TokarskyiAnton/a0180_eol_ecu_mix/img_assy/A0180_EOL ECU MIX CARD_R11A_V0_DEF_TOP.jpeg

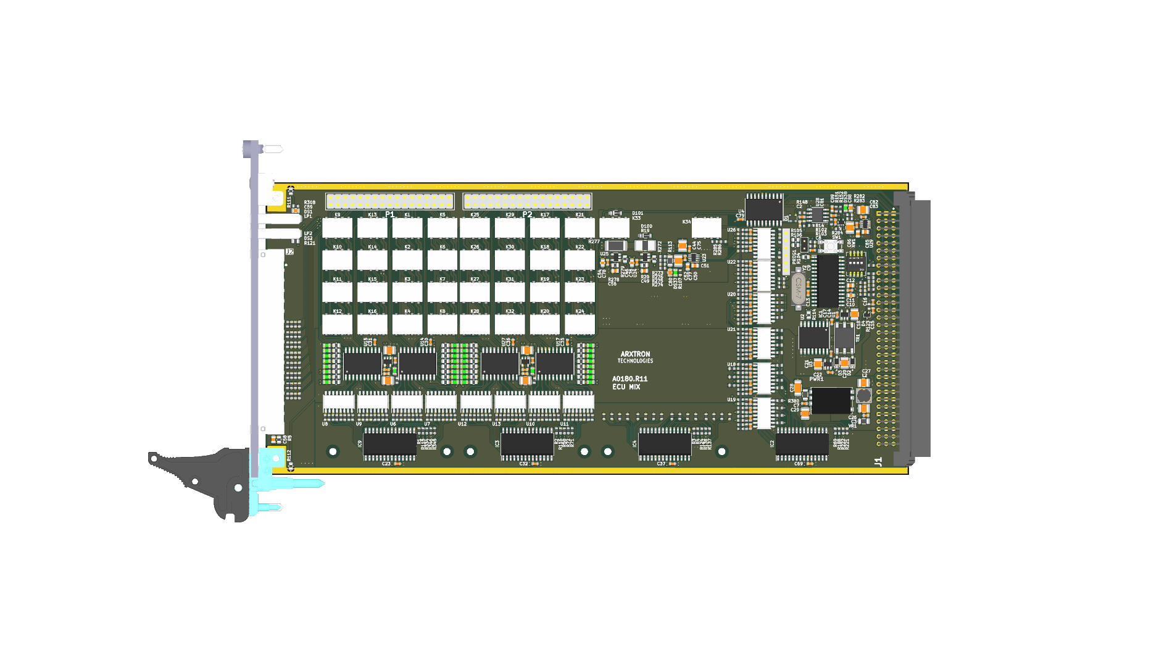
img_assy/A0180_EOL ECU MIX CARD_R11A_V0_DEF_TOP.jpeg
