TokarskyiAnton/a0180_eol_ecu_mix/dxf/a0180_eol_ecu_mix-drl_map.dxf

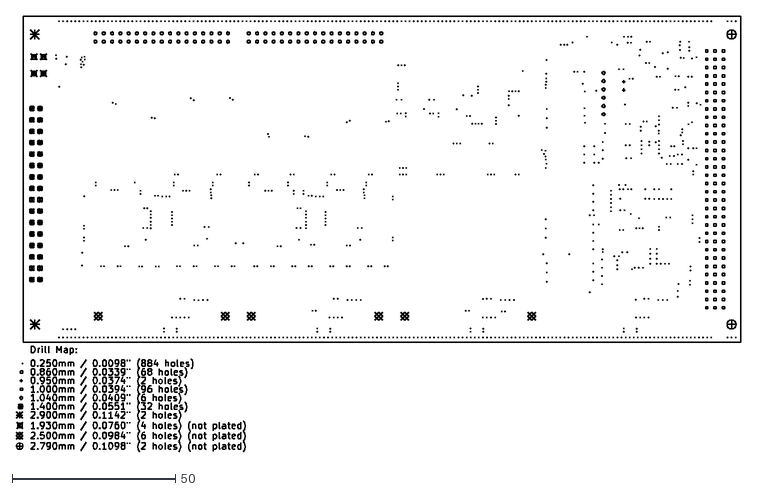
[picture p4: CAD file, 2026-02-21]
dxf/a0180_eol_ecu_mix-drl_map.dxf
222.1 x 133.5
