TokarskyiAnton/a0180_eol_ecu_mix/dxf/a0180_eol_ecu_mix-B_Fab.dxf

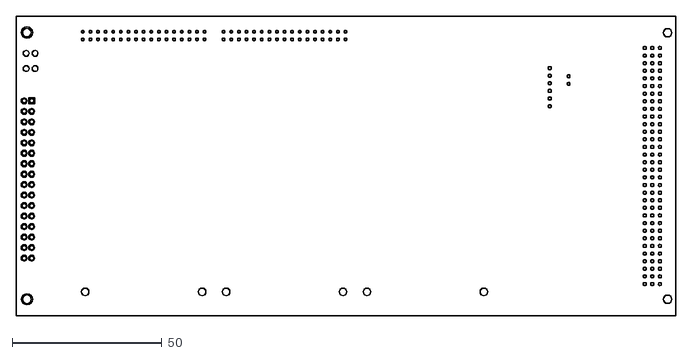
[picture p5: CAD file, 2026-02-07]
dxf/a0180_eol_ecu_mix-B_Fab.dxf
220.0 x 100.0
