TokarskyiAnton/a0180_eol_ecu_mix/pdf/a0180_eol_ecu_mix.pdf

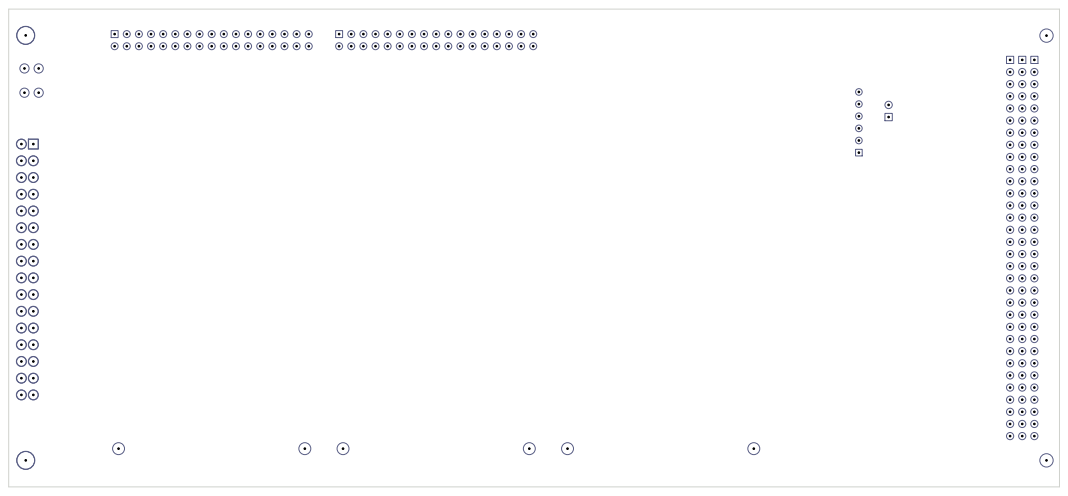
[picture p6: page 1]

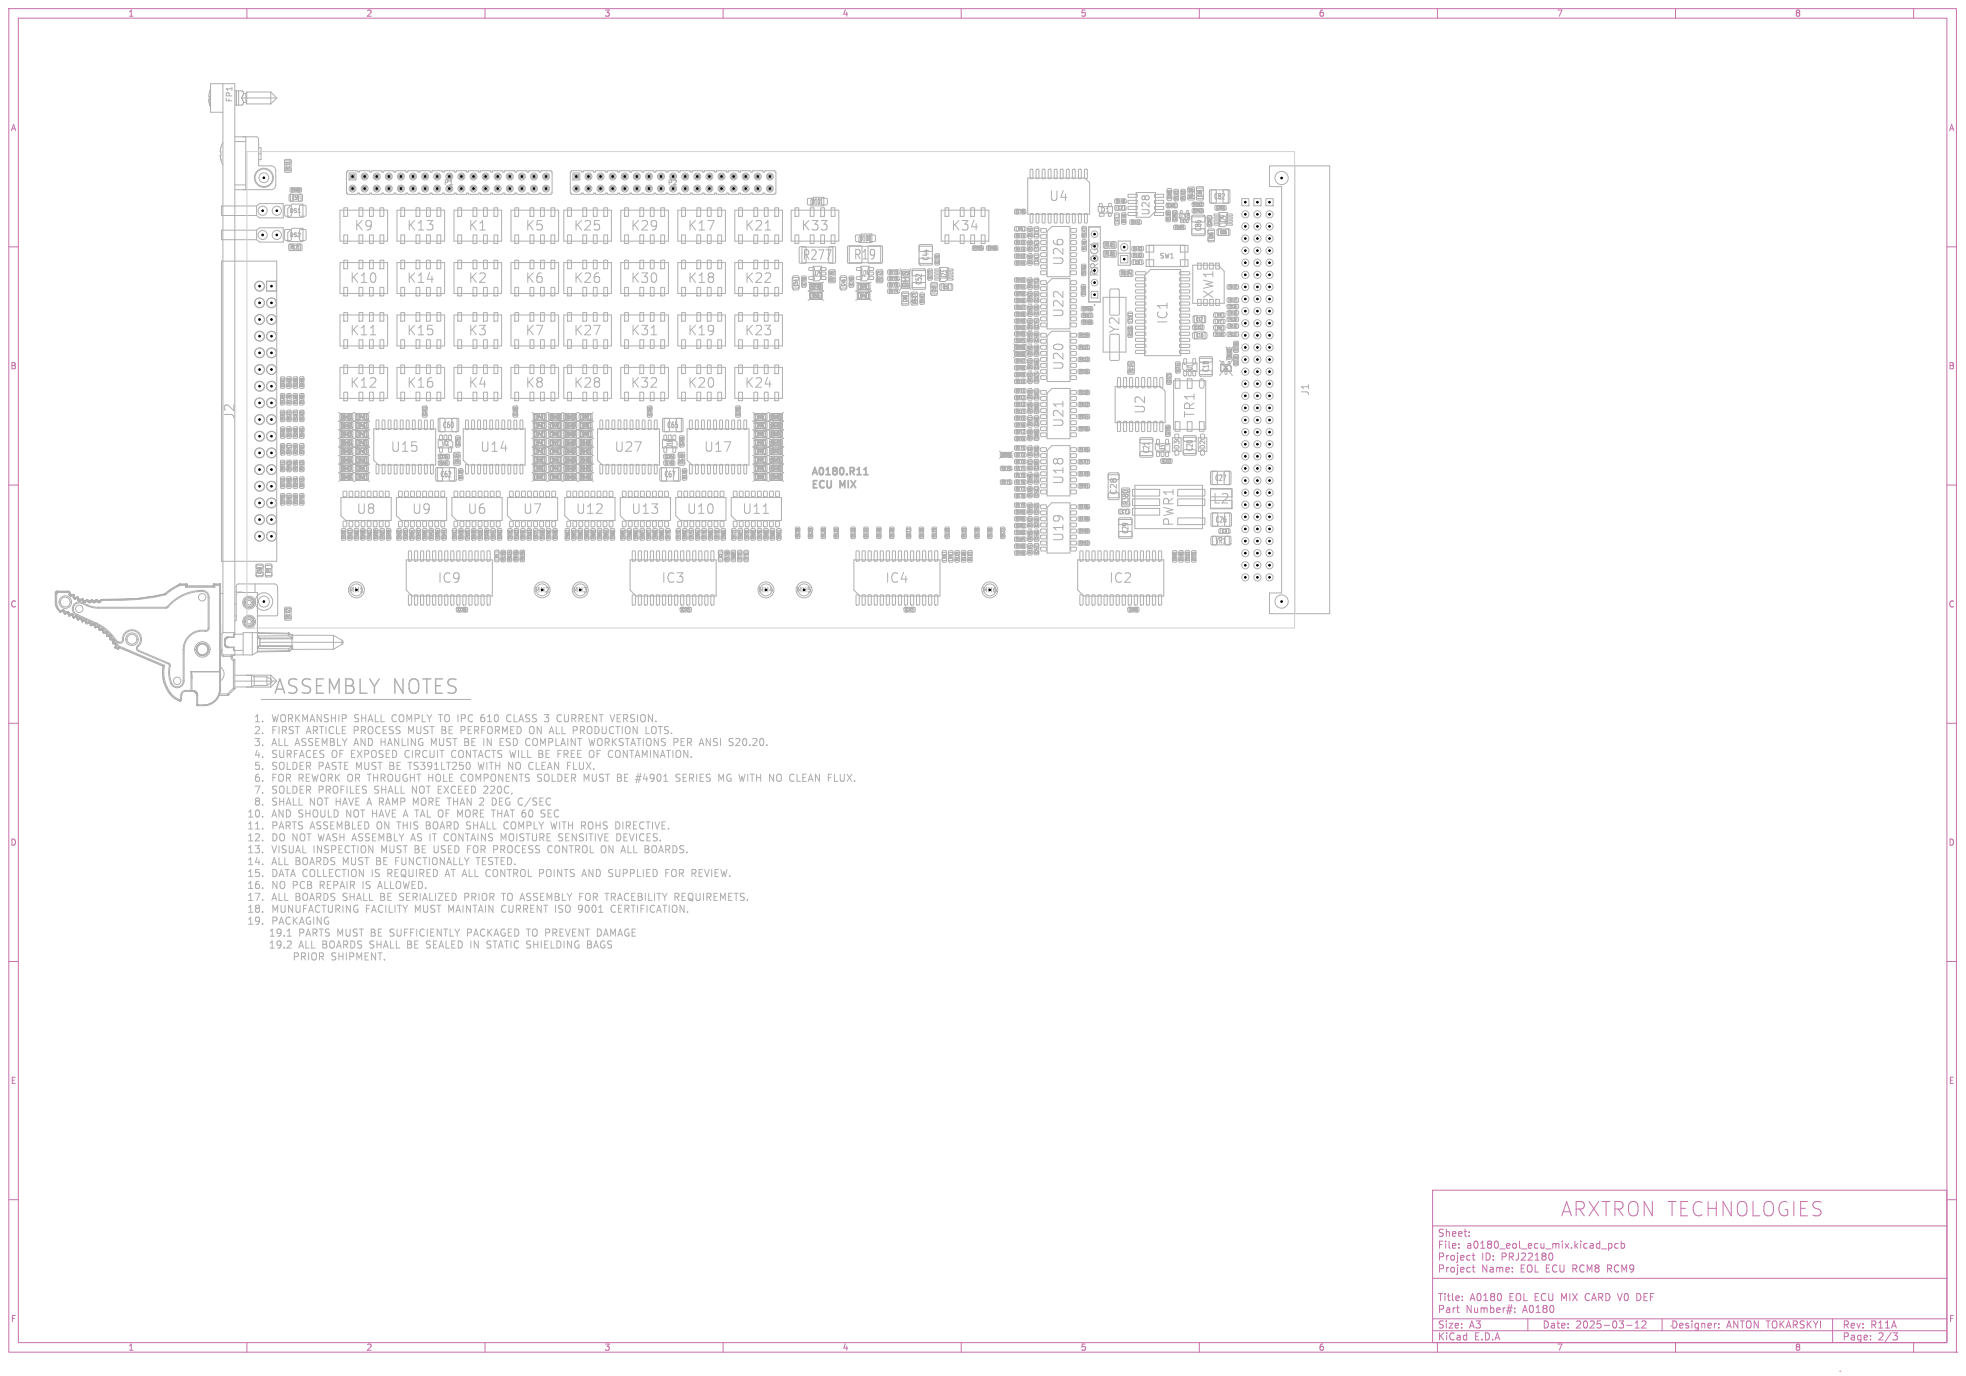
[picture p7: page 2]

19.2 ALL BOARDS SHALL BE SEALED IN STATIC SHIELDING BAGS WORKMANSHIP SHALL COMPLY TO IPC 610 CLASS 3 CURRENT VERSION. AND SHOULD NOT HAVE A TAL OF MORE THAT 60 SEC

FOR REWORK OR THROUGHT HOLE COMPONENTS SOLDER MUST BE #4901 SERIES MG WITH NO CLEAN FLUX. 3.

VISUAL INSPECTION MUST BE USED FOR PROCESS CONTROL ON ALL BOARDS. 19. DATA COLLECTION IS REQUIRED AT ALL CONTROL POINTS AND SUPPLIED FOR REVIEW. PARTS ASSEMBLED ON THIS BOARD SHALL COMPLY WITH ROHS DIRECTIVE. 12. SHALL NOT HAVE A RAMP MORE THAN 2 DEG C/SEC

16. 19.1 PARTS MUST BE SUFFICIENTLY PACKAGED TO PREVENT DAMAGE

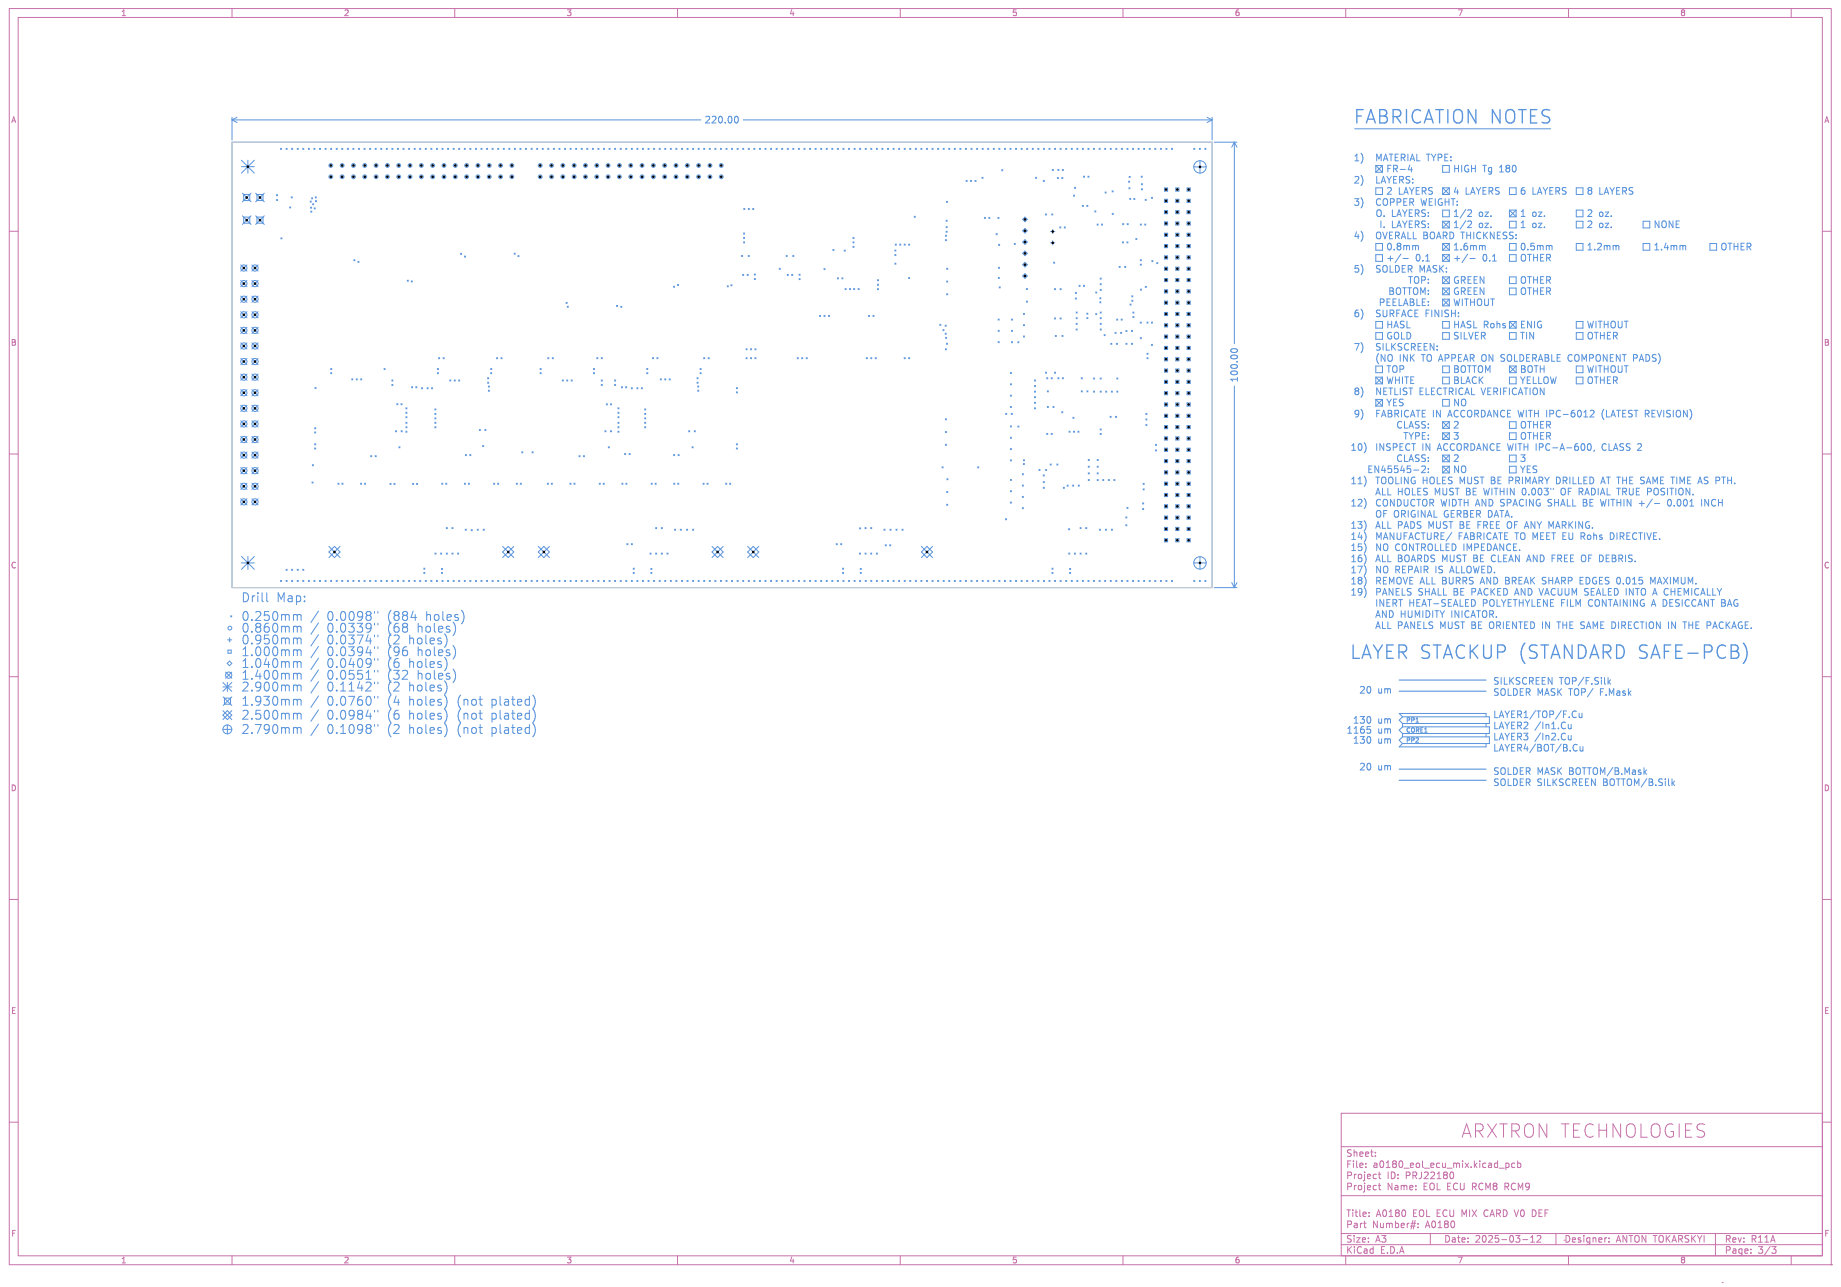
[picture p8: page 3]

CLASS: SURFACE FINISH: FR-4

I. LAYERS: ALL BOARDS MUST BE CLEAN AND FREE OF DEBRIS. YES

(NO INK TO APPEAR ON SOLDERABLE COMPONENT PADS) GOLD

17) OF ORIGINAL GERBER DATA. BLACK

NO REPAIR IS ALLOWED. PANELS SHALL BE PACKED AND VACUUM SEALED INTO A CHEMICALLY

INERT HEAT-SEALED POLYETHYLENE FILM CONTAINING A DESICCANT BAG

PP1 LAYER STACKUP (STANDARD SAFE-PCB)

SILKSCREEN TOP/F.Silk LAYER3 /In2.Cu

LAYER1/TOP/F.Cu SOLDER MASK BOTTOM/B.Mask
