TokarskyiAnton/a0180_eol_ecu_mix/sch/A0180_EOL ECU MIX CARD_R11A_V0_DEF.pdf

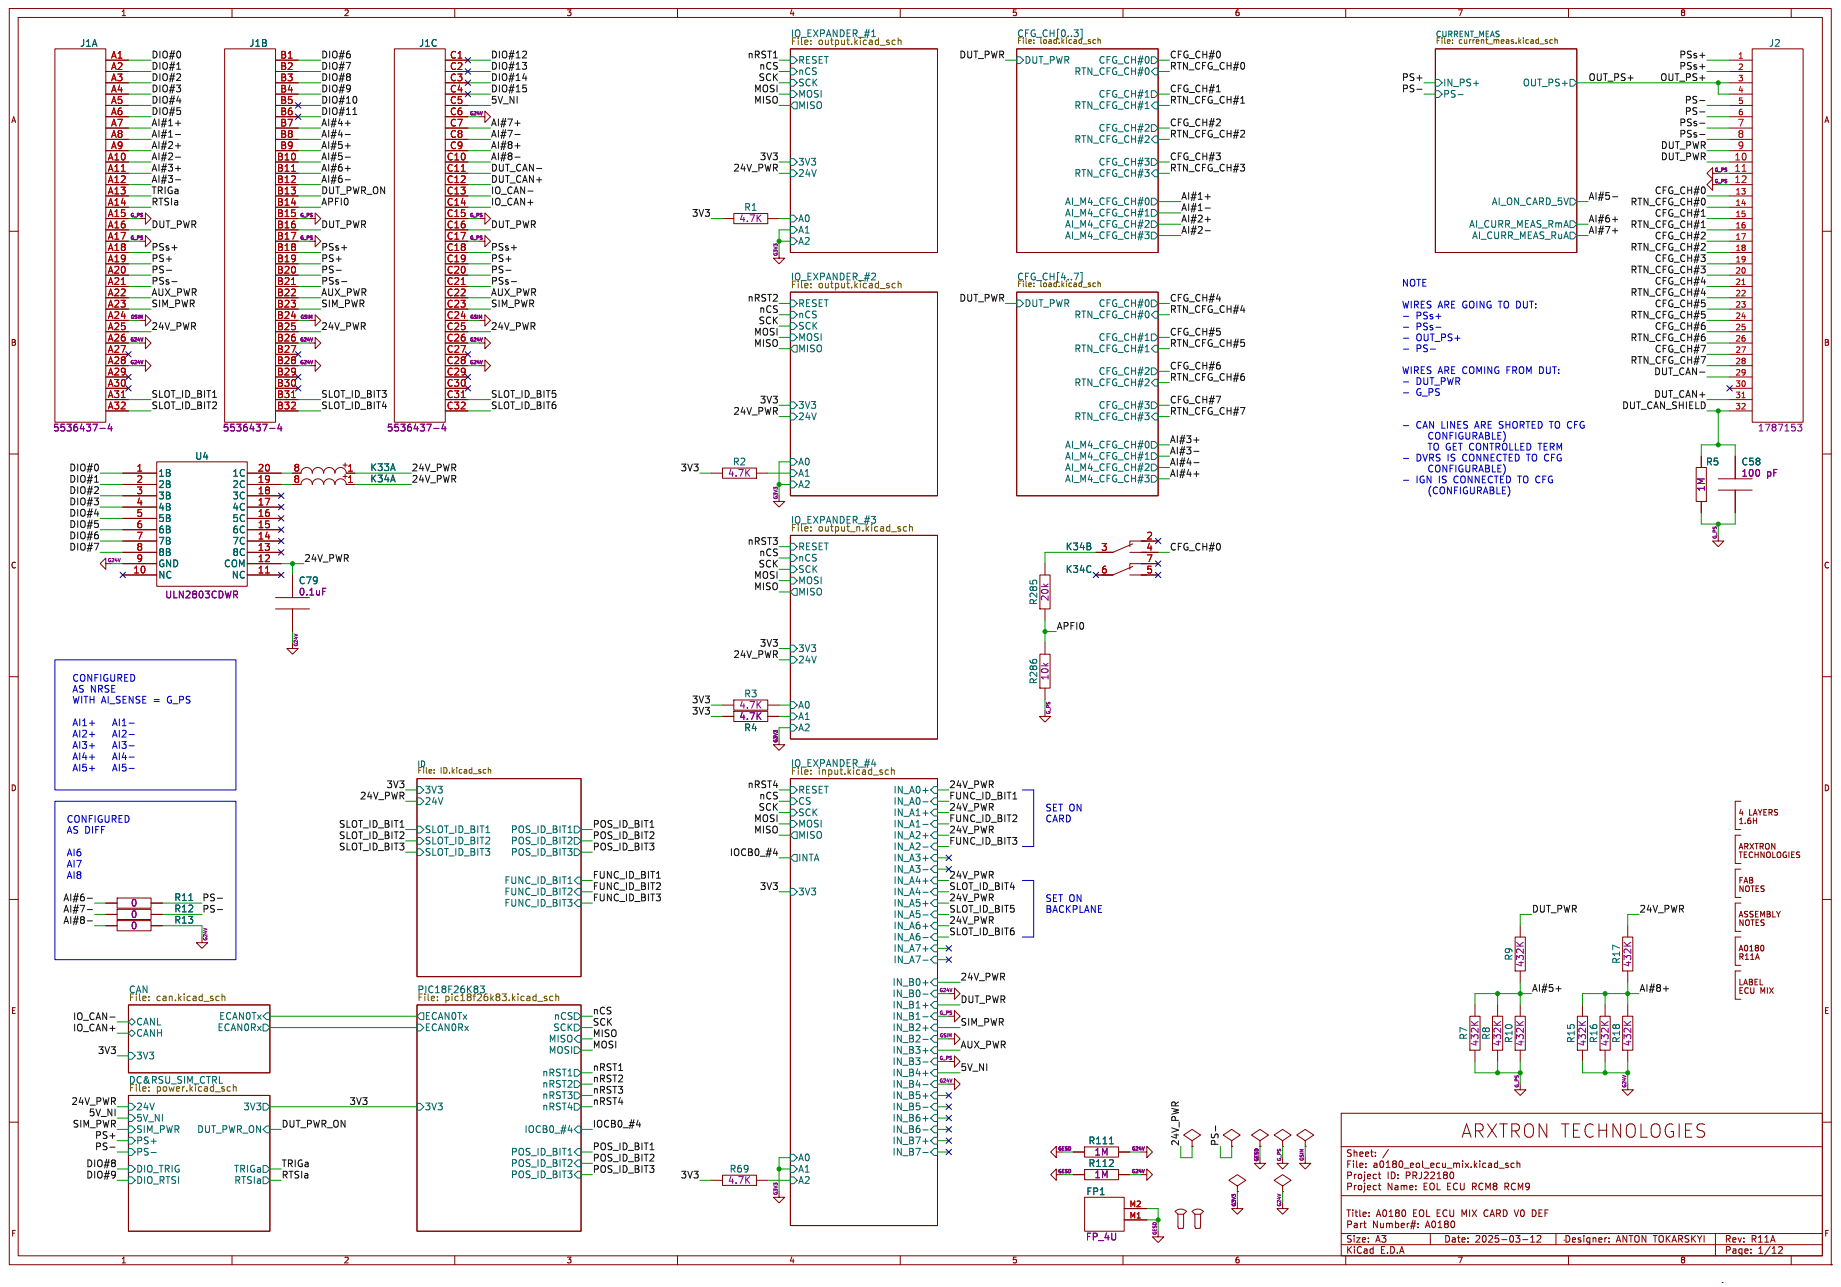
[picture p9: page 1]

DIO#2 AI#2+ AI#3- AI#3+ DUT_PWR

DIO#9 AI#5+ DIO#11
DIO#10 AI#5- AI#6- AI#6+ DUT_PWR_ON

WIRES ARE GOING TO DUT: - PSs+

WIRES ARE COMING FROM DUT: - DUT_PWR

- CAN LINES ARE SHORTED TO CFG
CONFIGURABLE)
- DVRS IS CONNECTED TO CFG
- IGN IS CONNECTED TO CFG
(CONFIGURABLE)

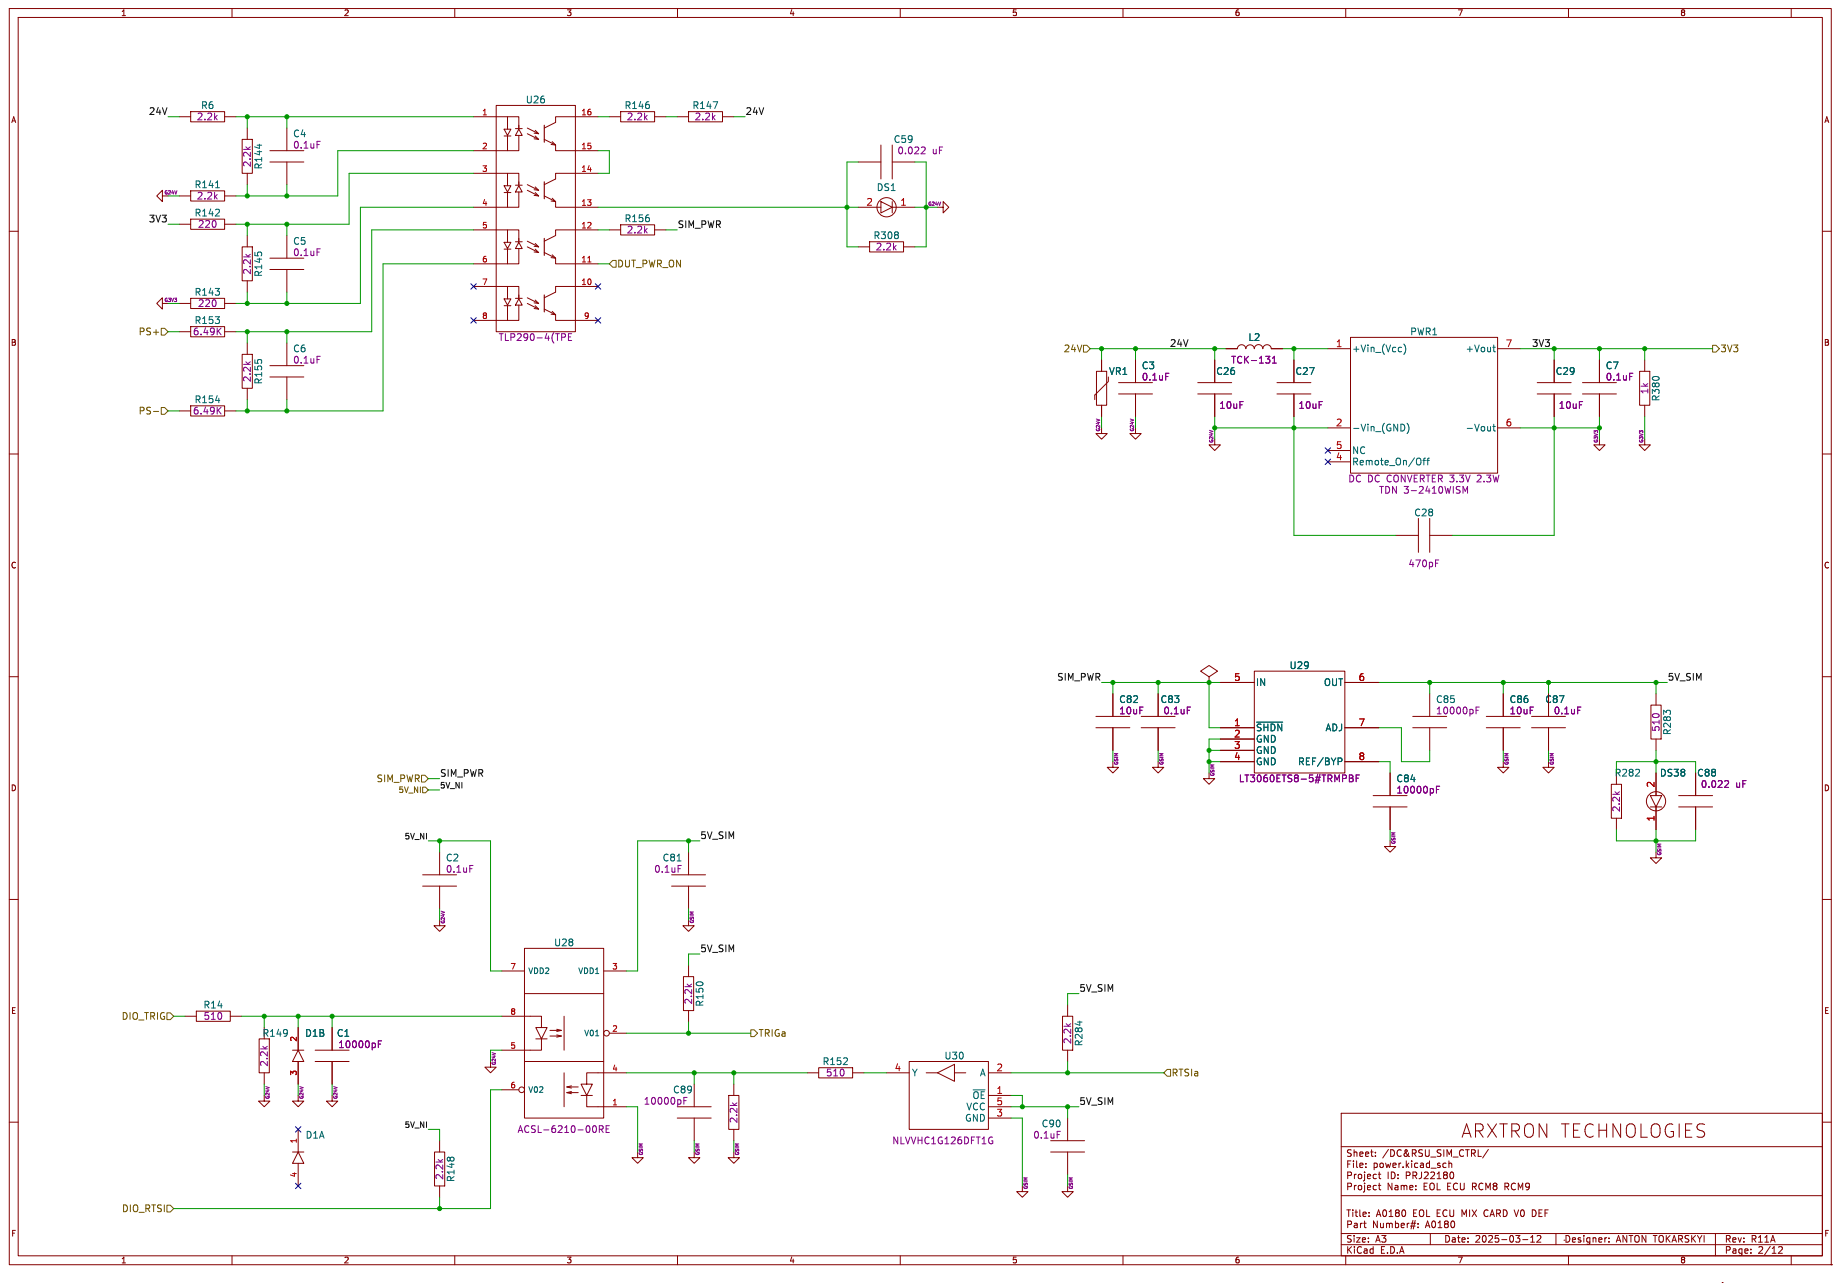
[picture p10: page 2]

File: power.kicad_sch Sheet: /DC&RSU_SIM_CTRL/

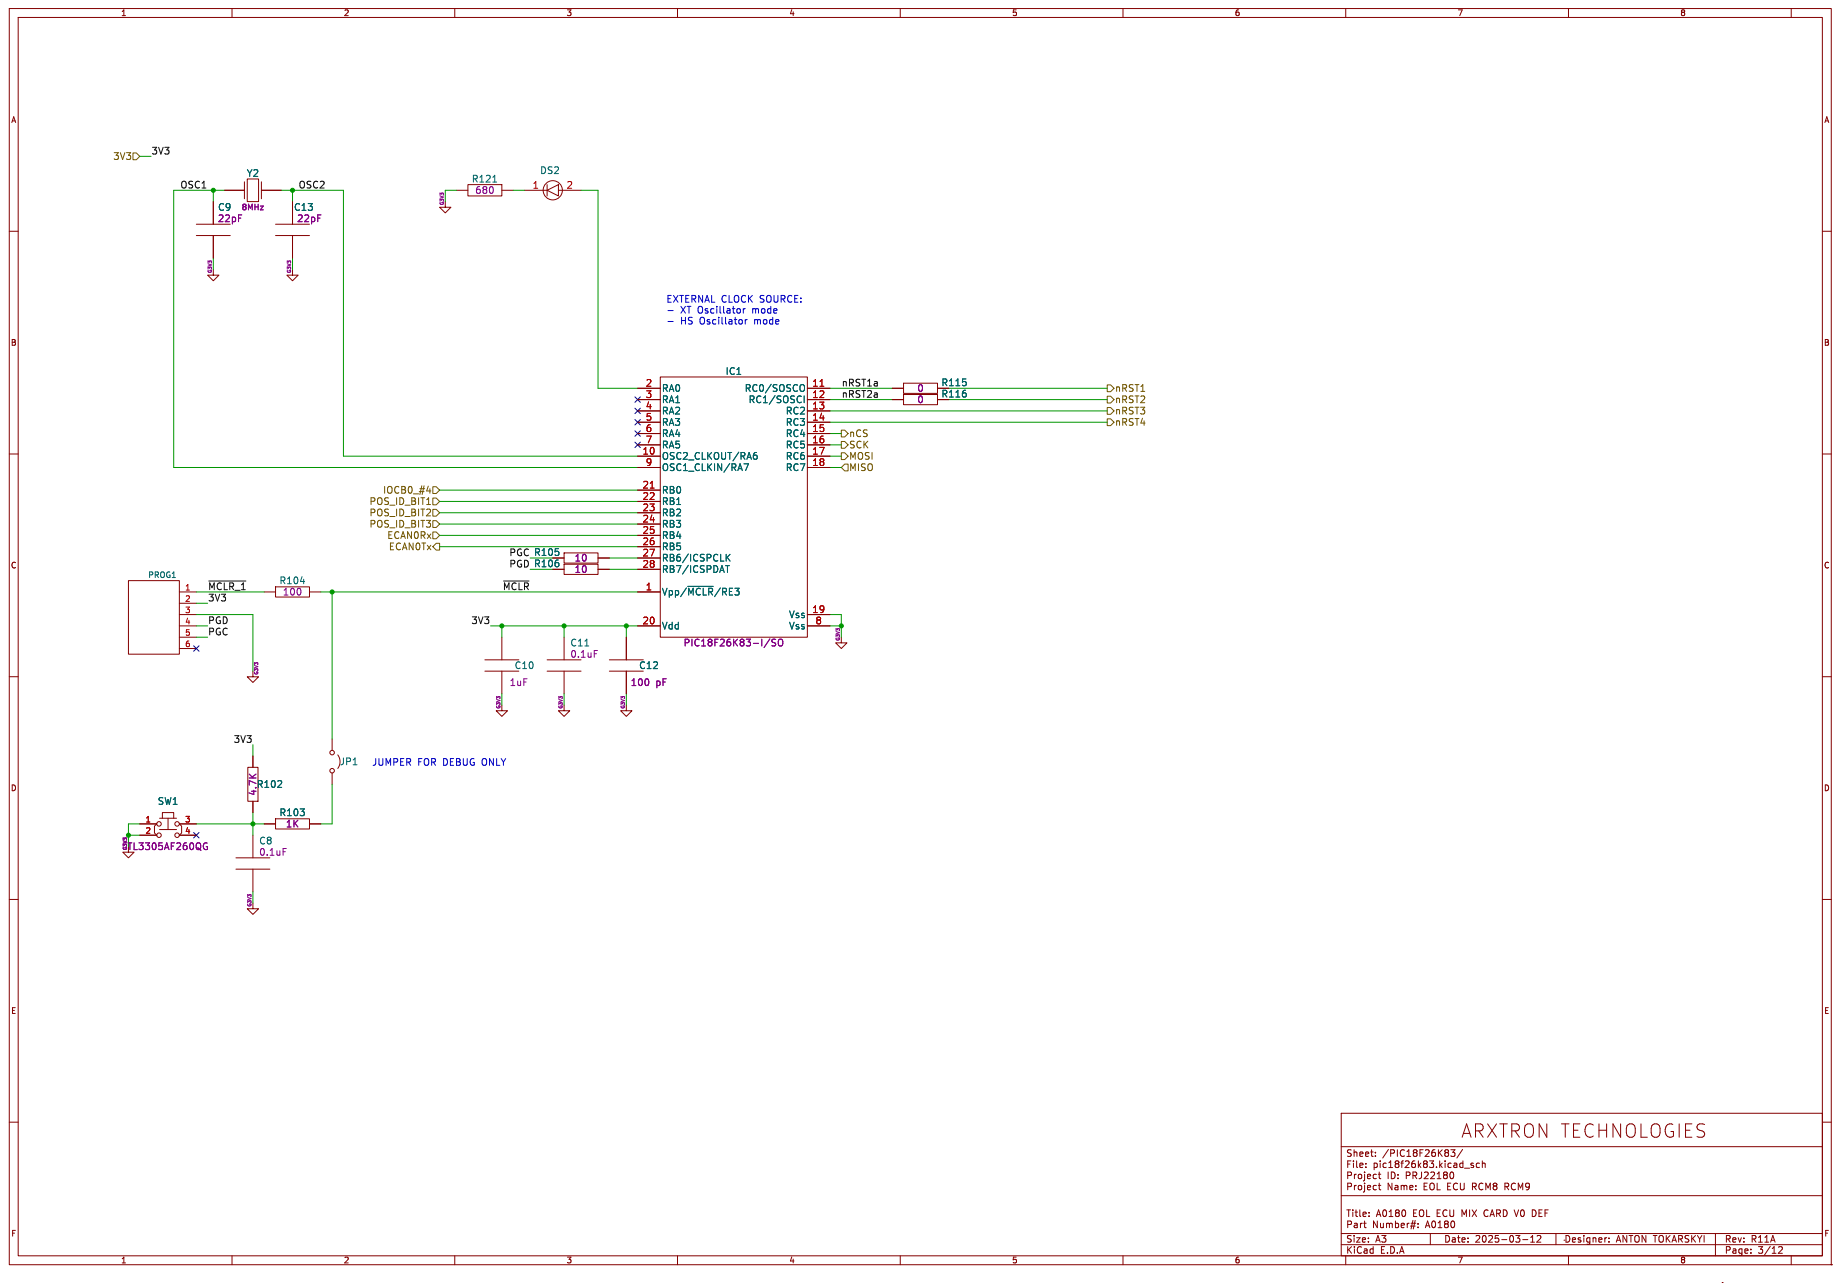
[picture p11: page 3]

JUMPER FOR DEBUG ONLY

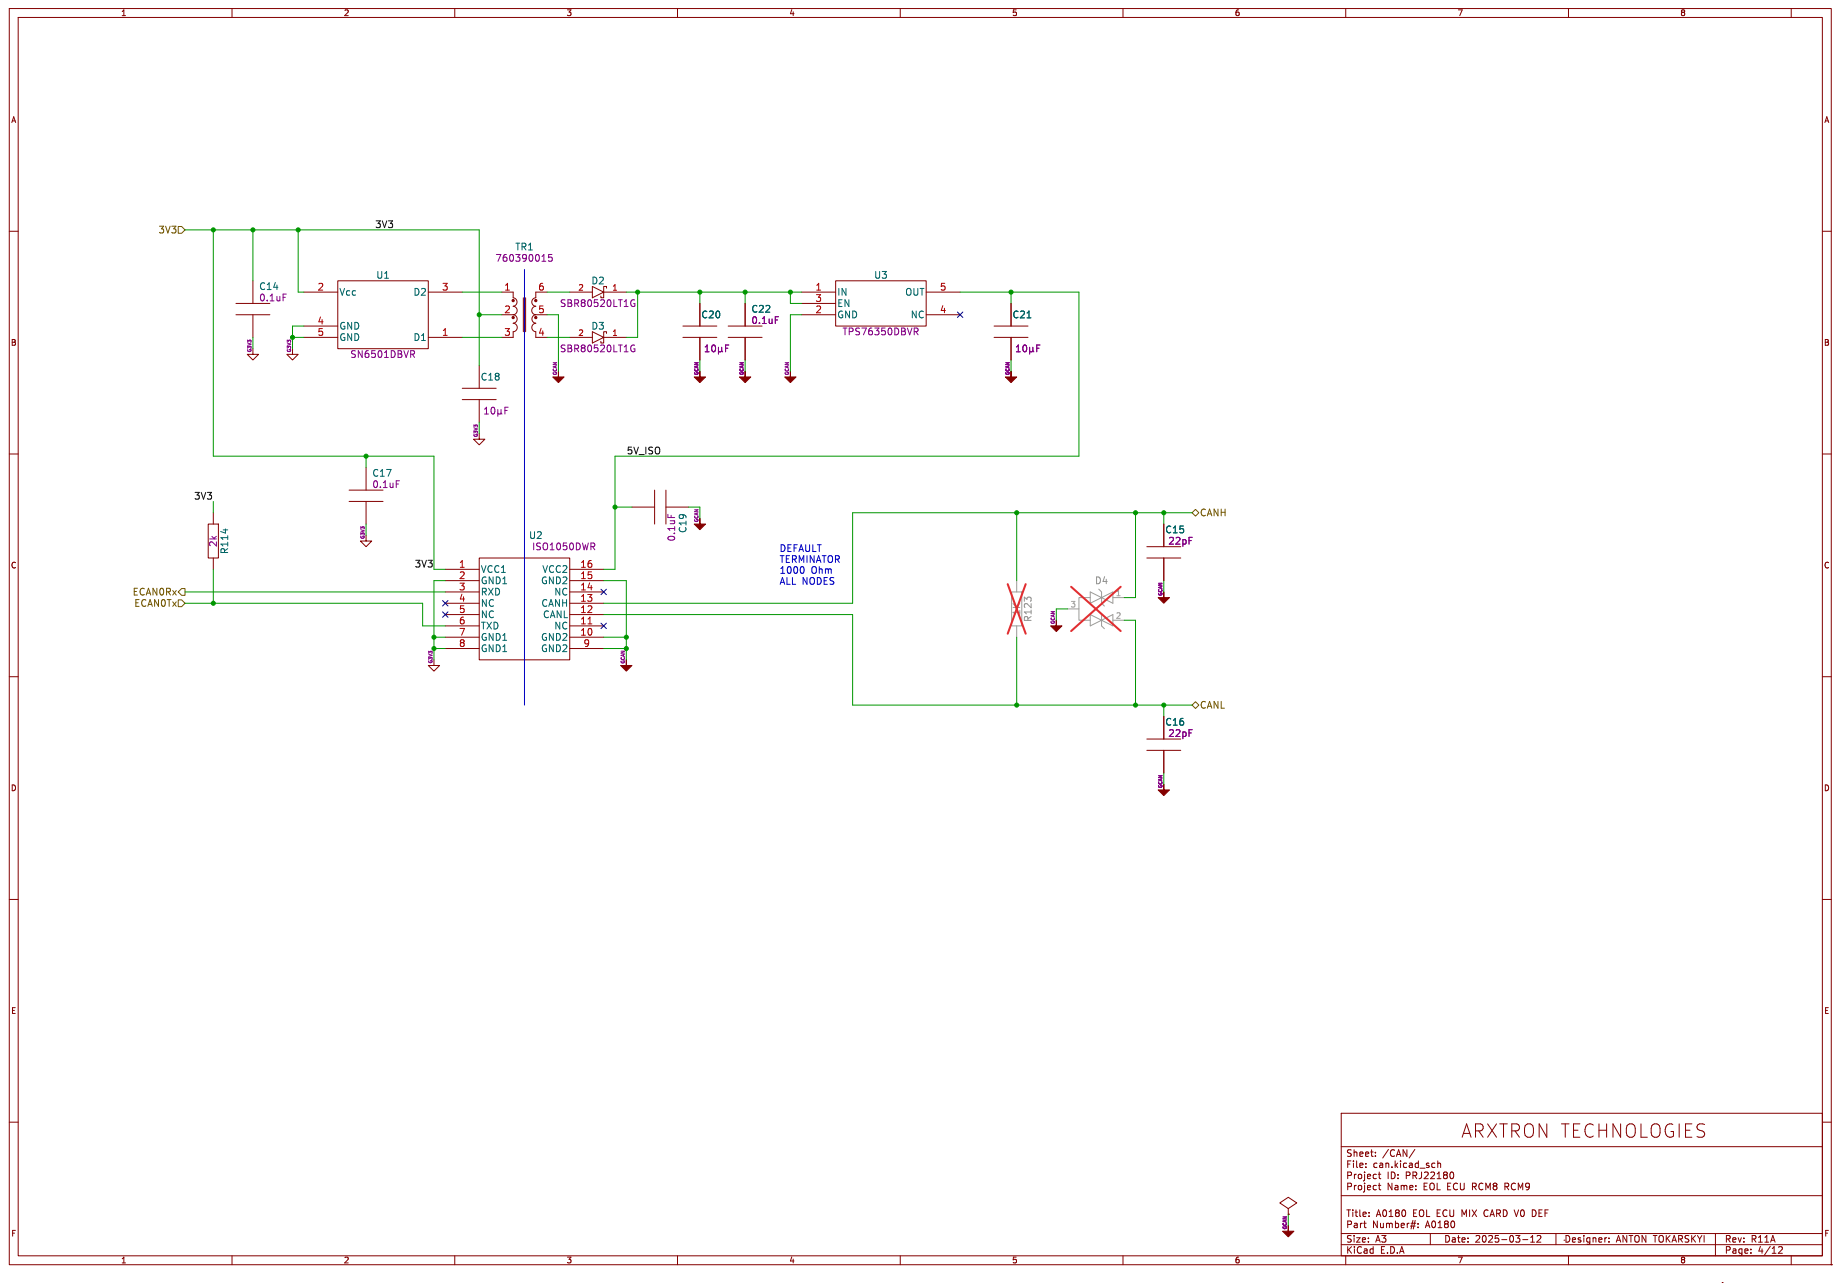
[picture p12: page 4]

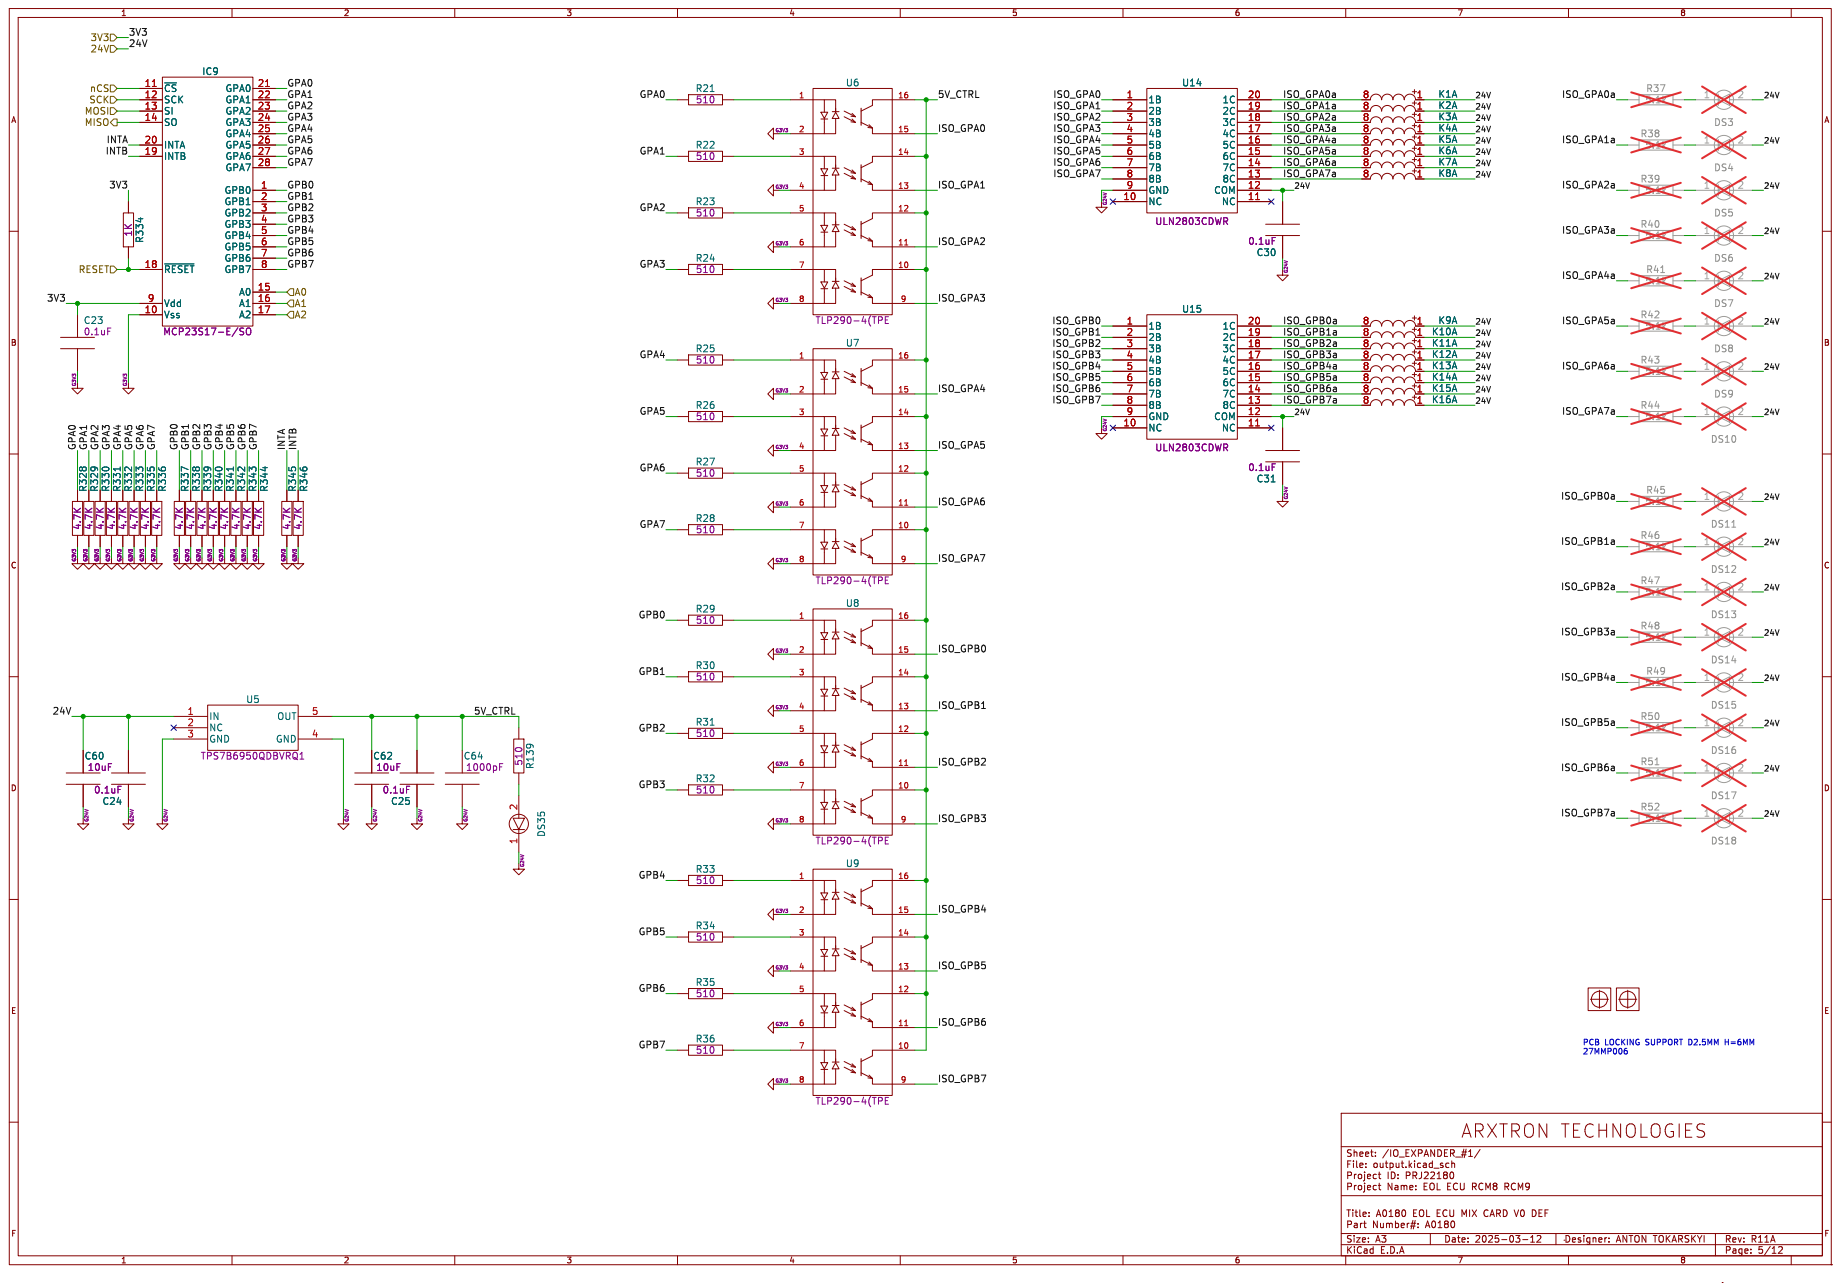
[picture p13: page 5]

~{CS} 11 SCK 12 SI 13 SO 14

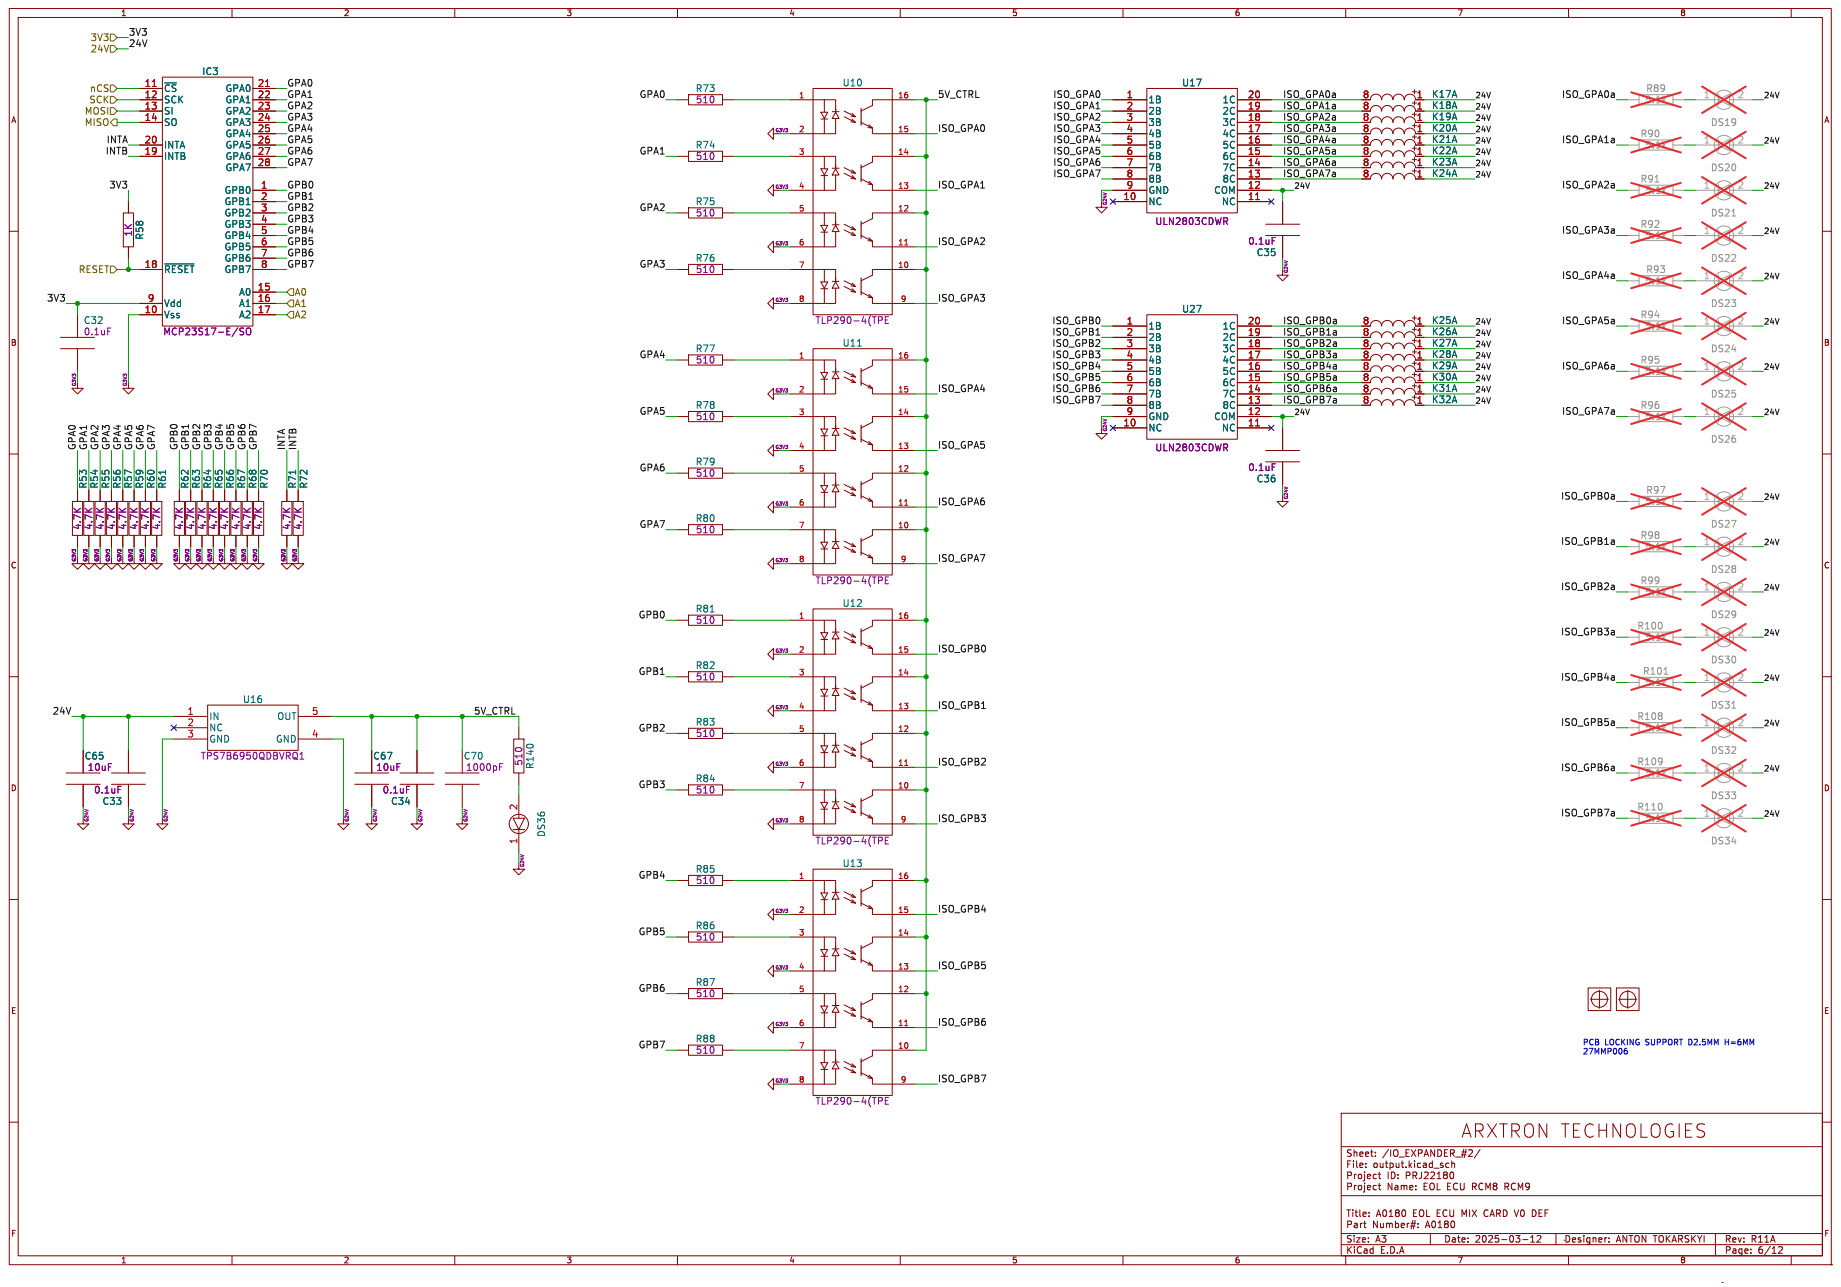
[picture p14: page 6]

~{CS} 11 SCK 12 SI 13 SO 14

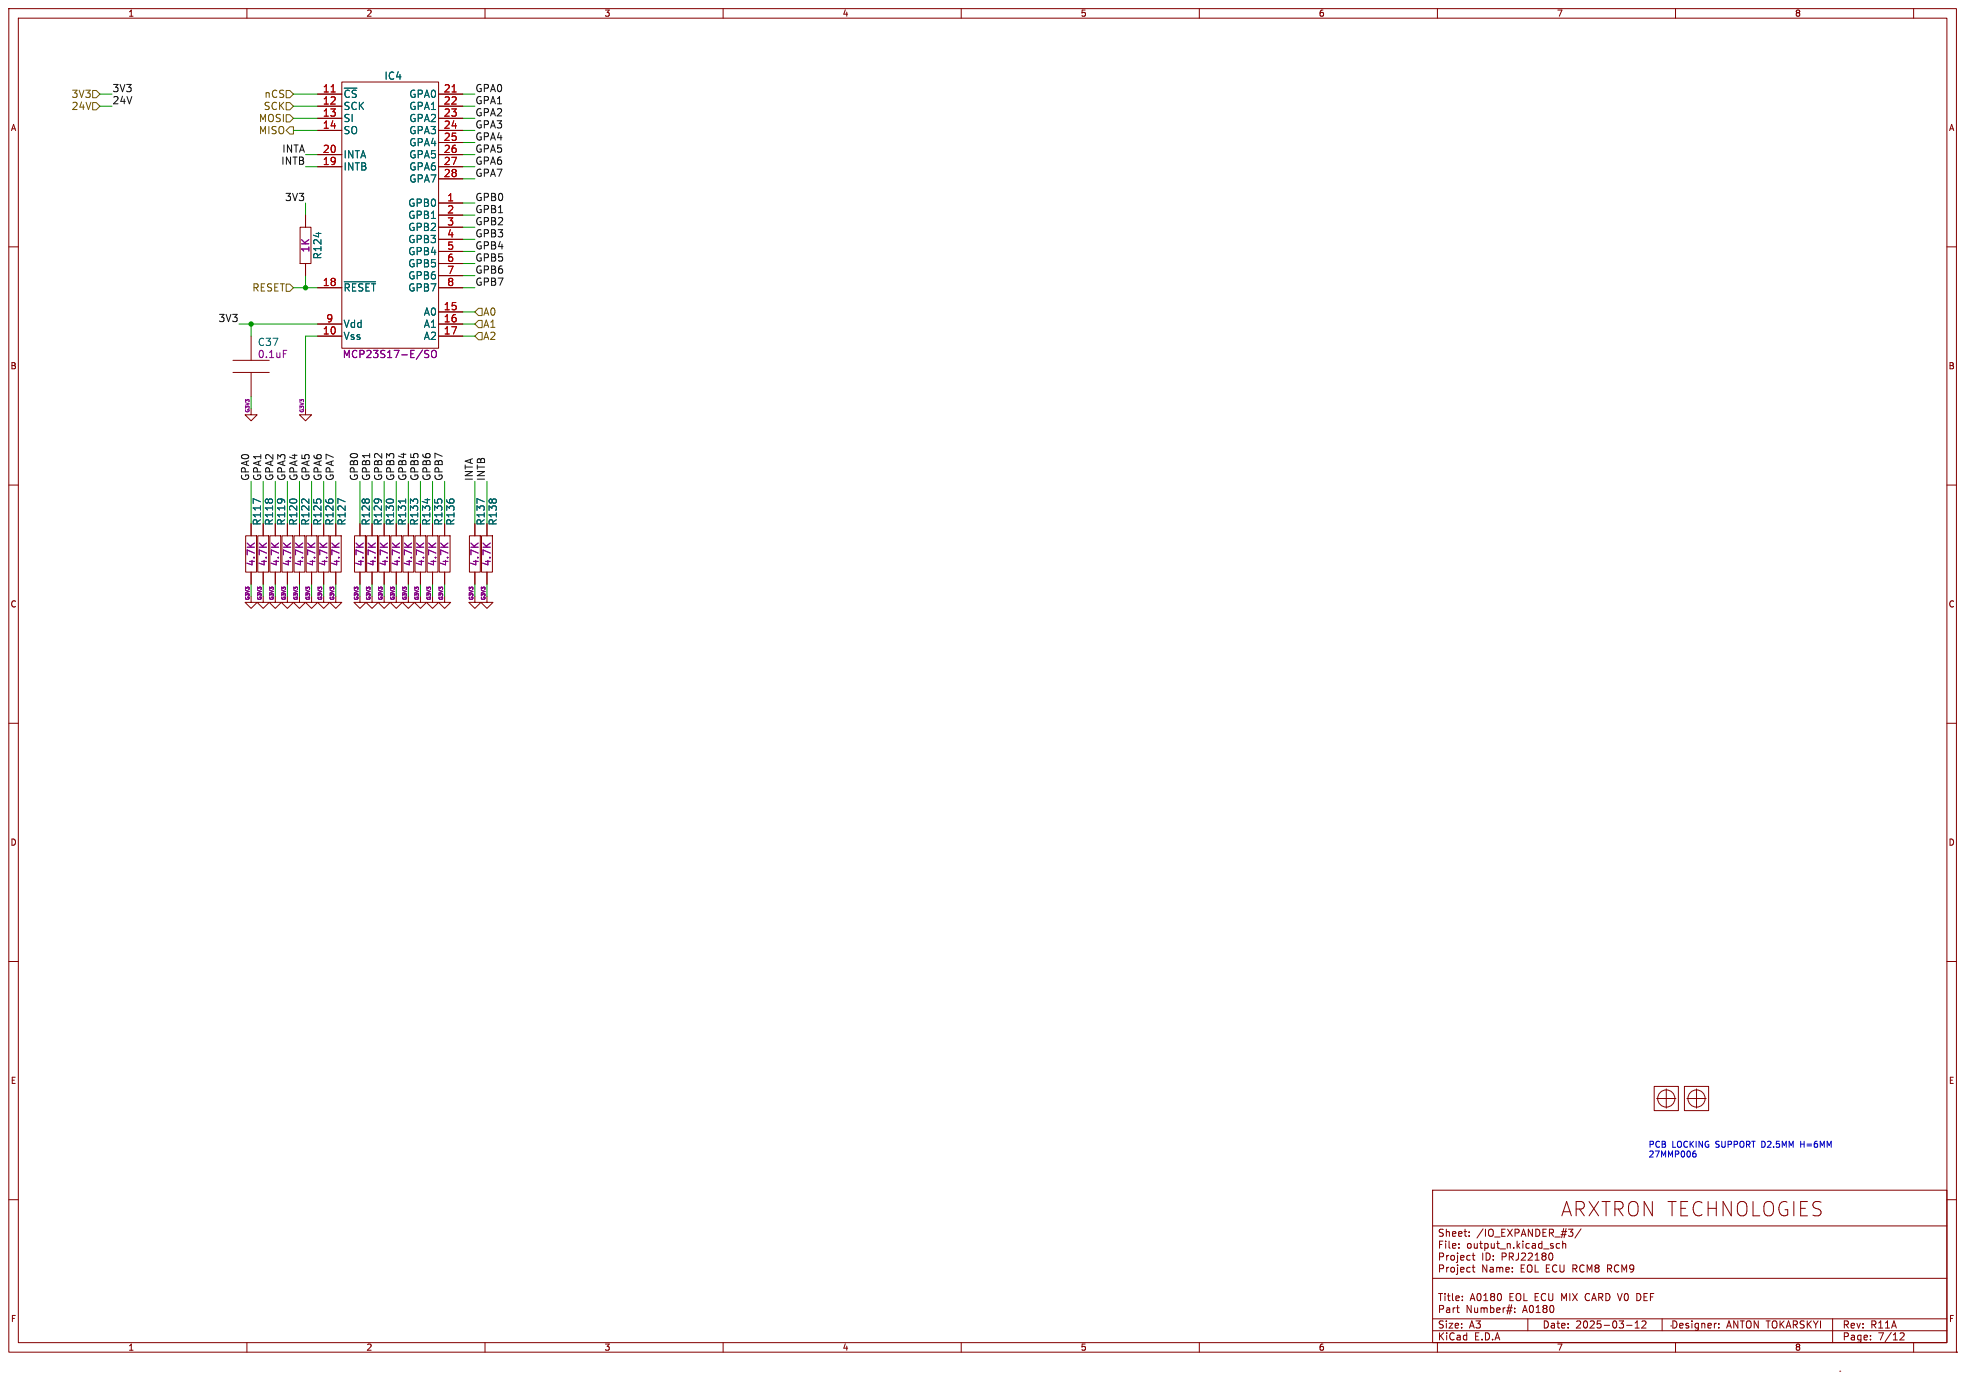
[picture p15: page 7]

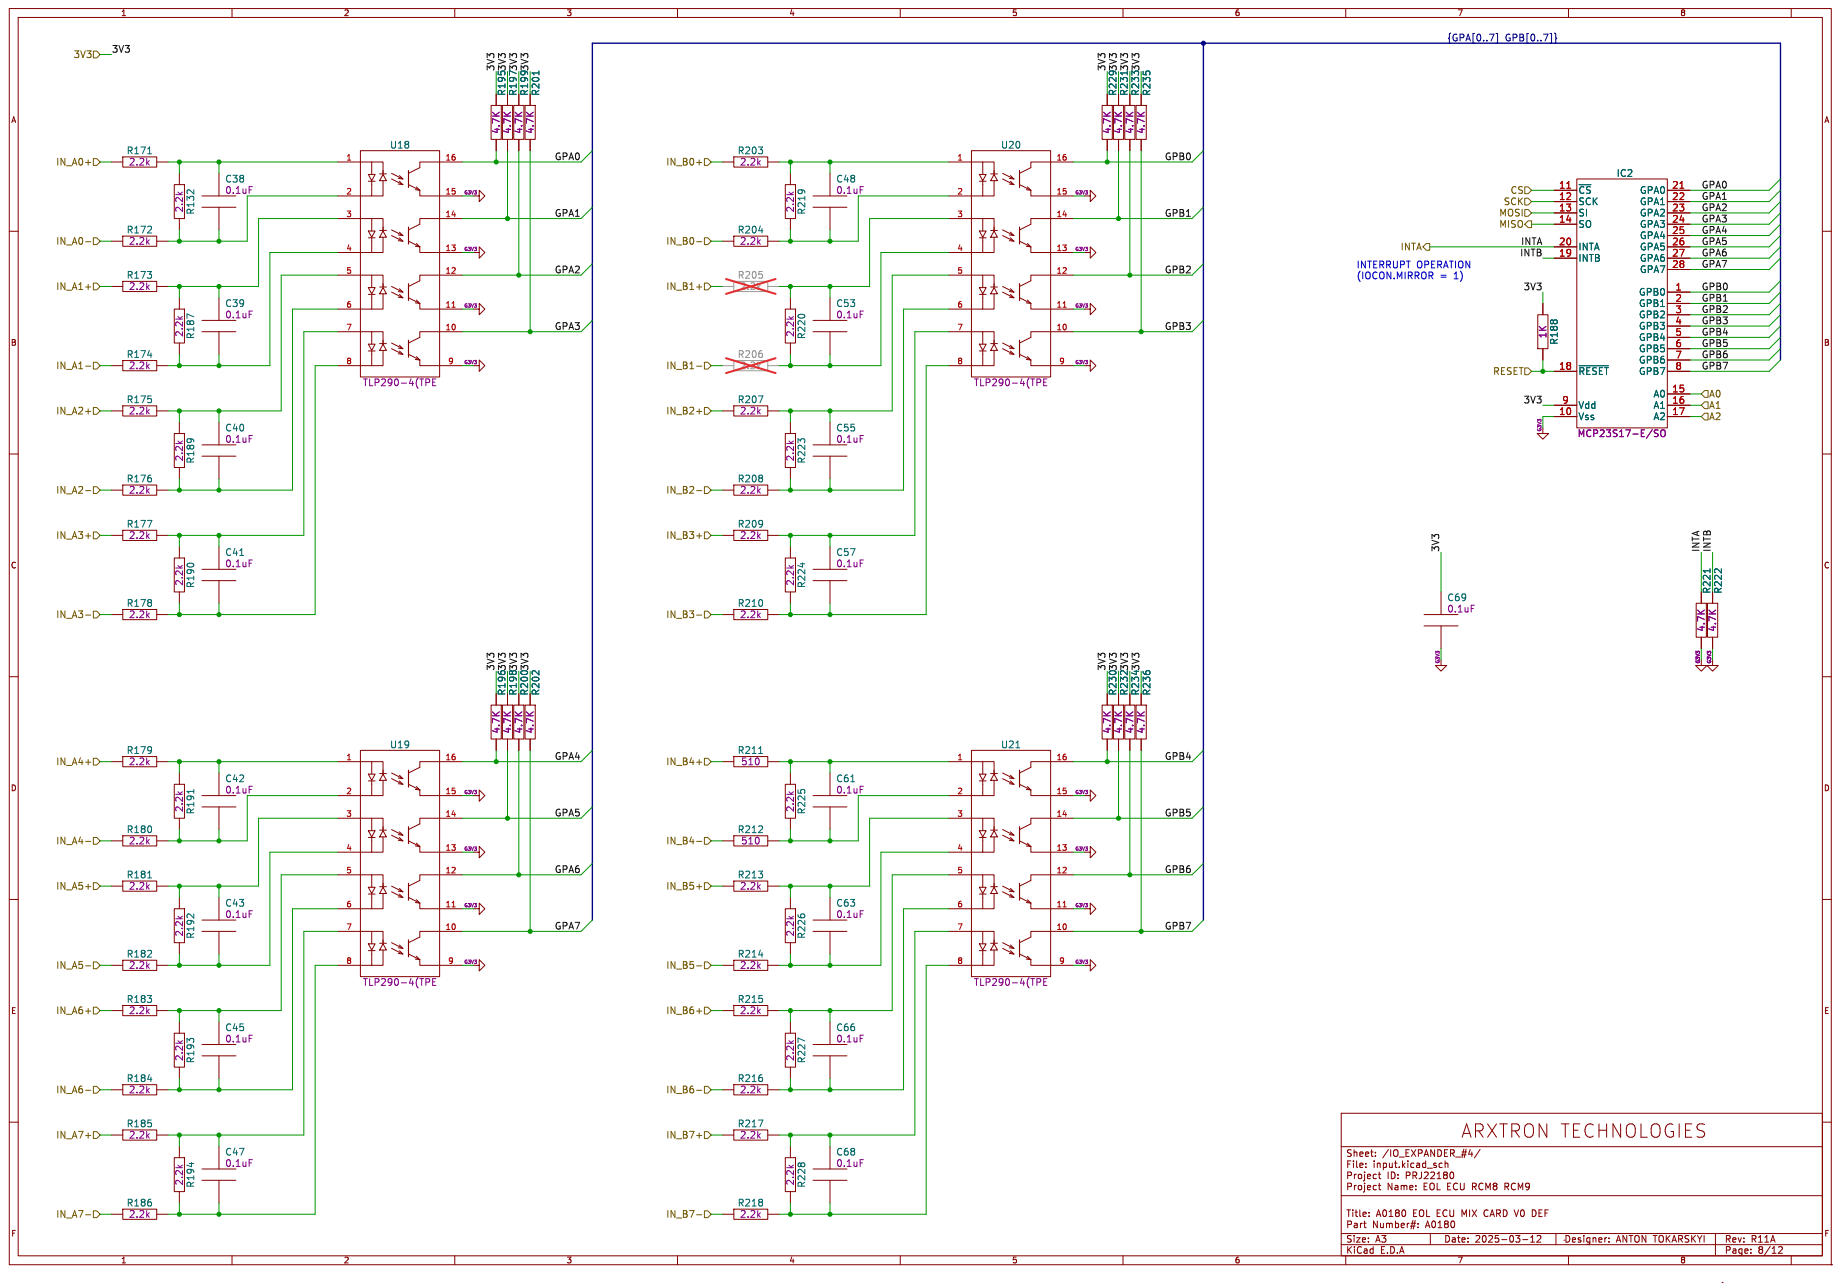
[picture p16: page 8]

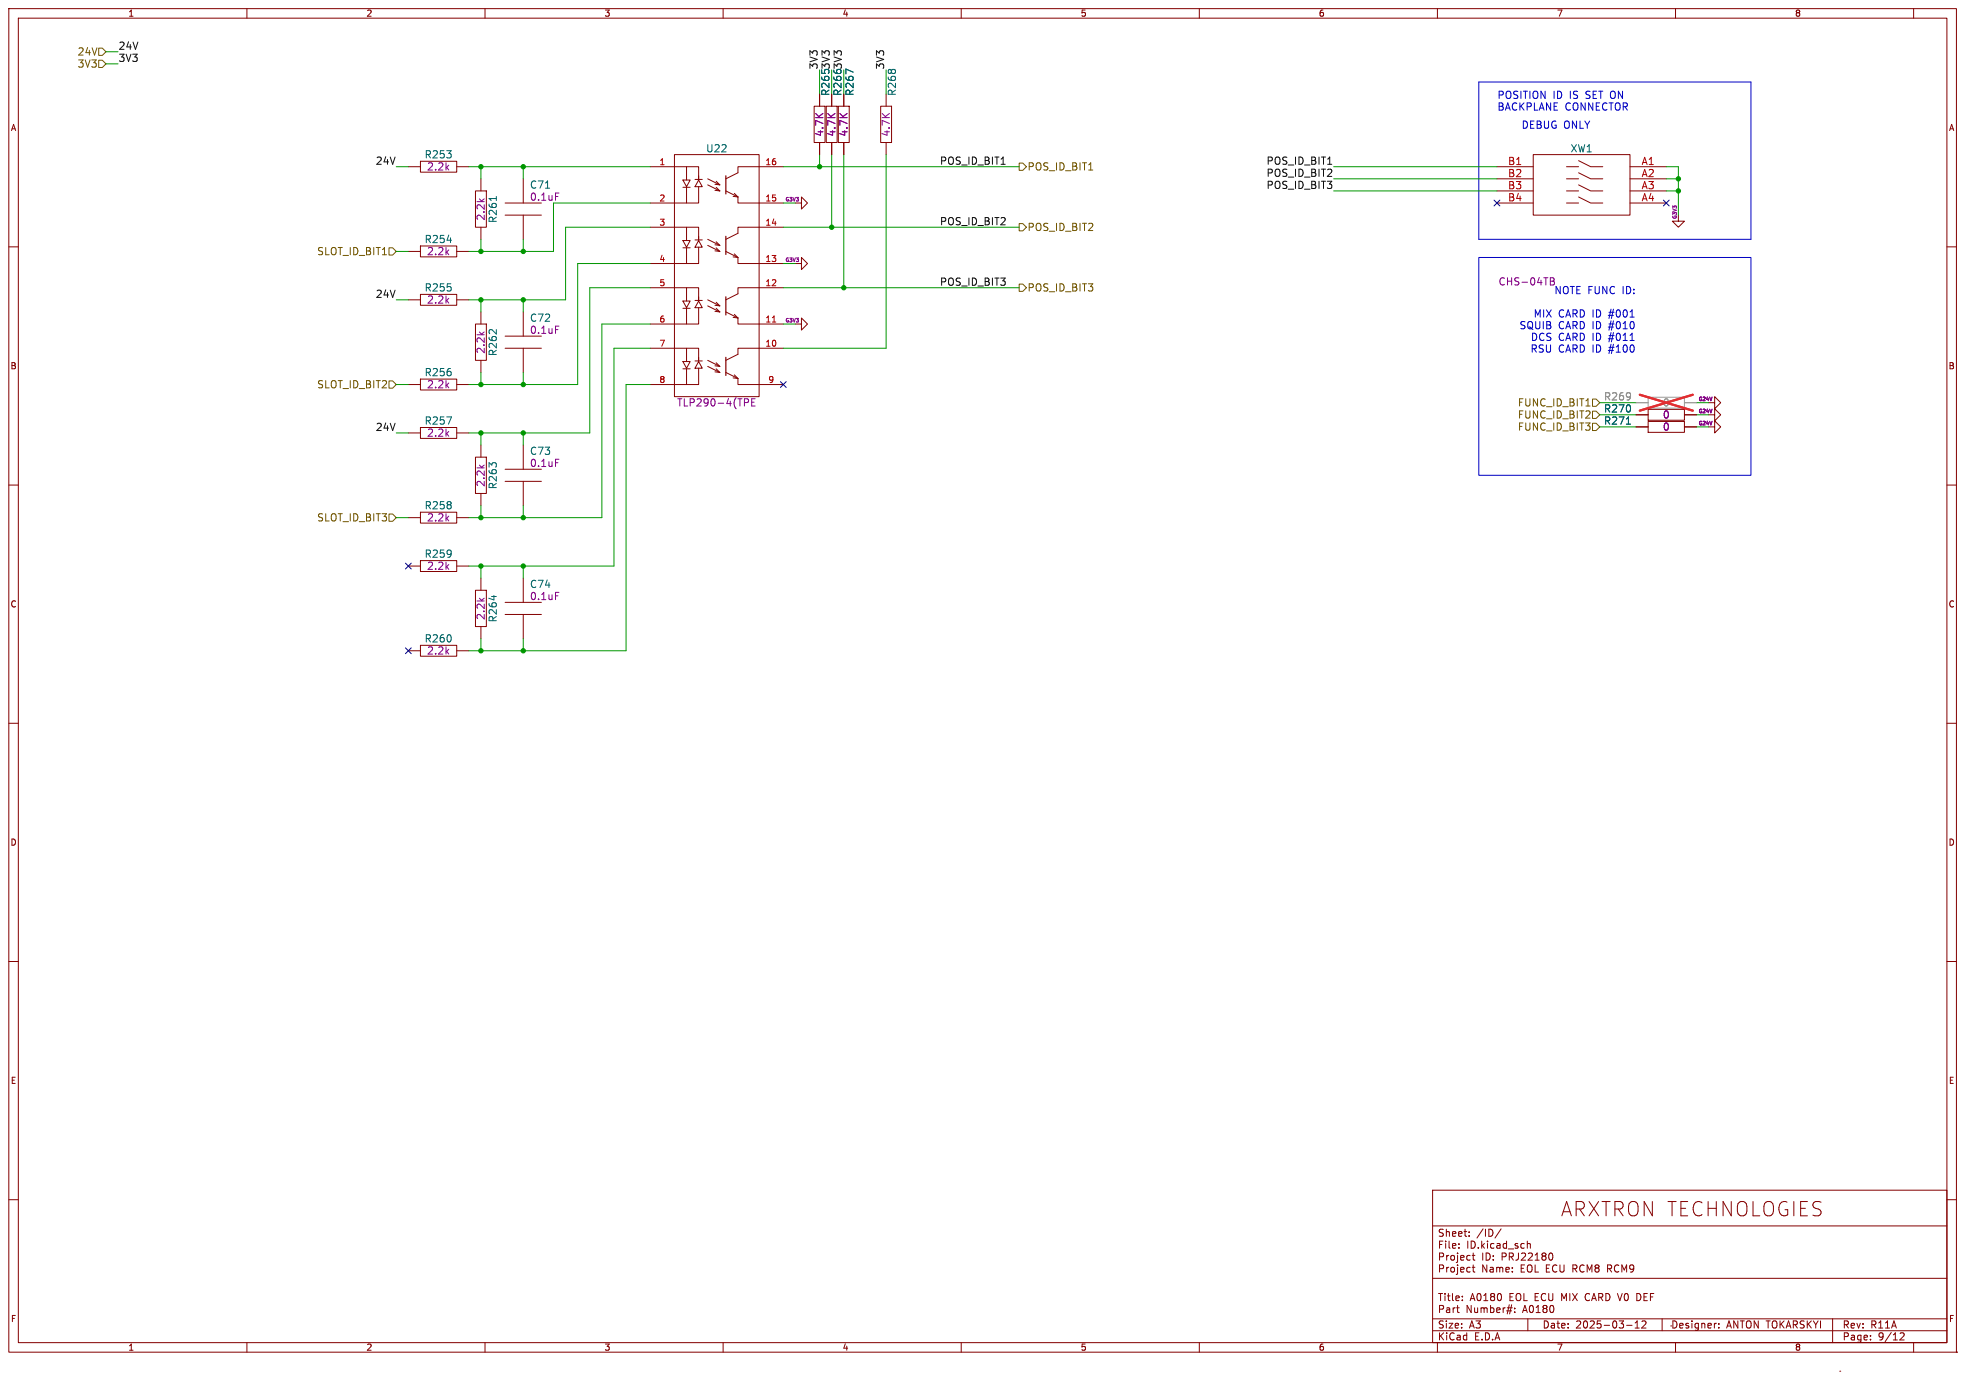
[picture p17: page 9]

POSITION ID IS SET ON
BACKPLANE CONNECTOR
NOTE FUNC ID: MIX CARD ID #001 SQUIB CARD ID #010 DCS CARD ID #011 RSU CARD ID #100 DEBUG ONLY

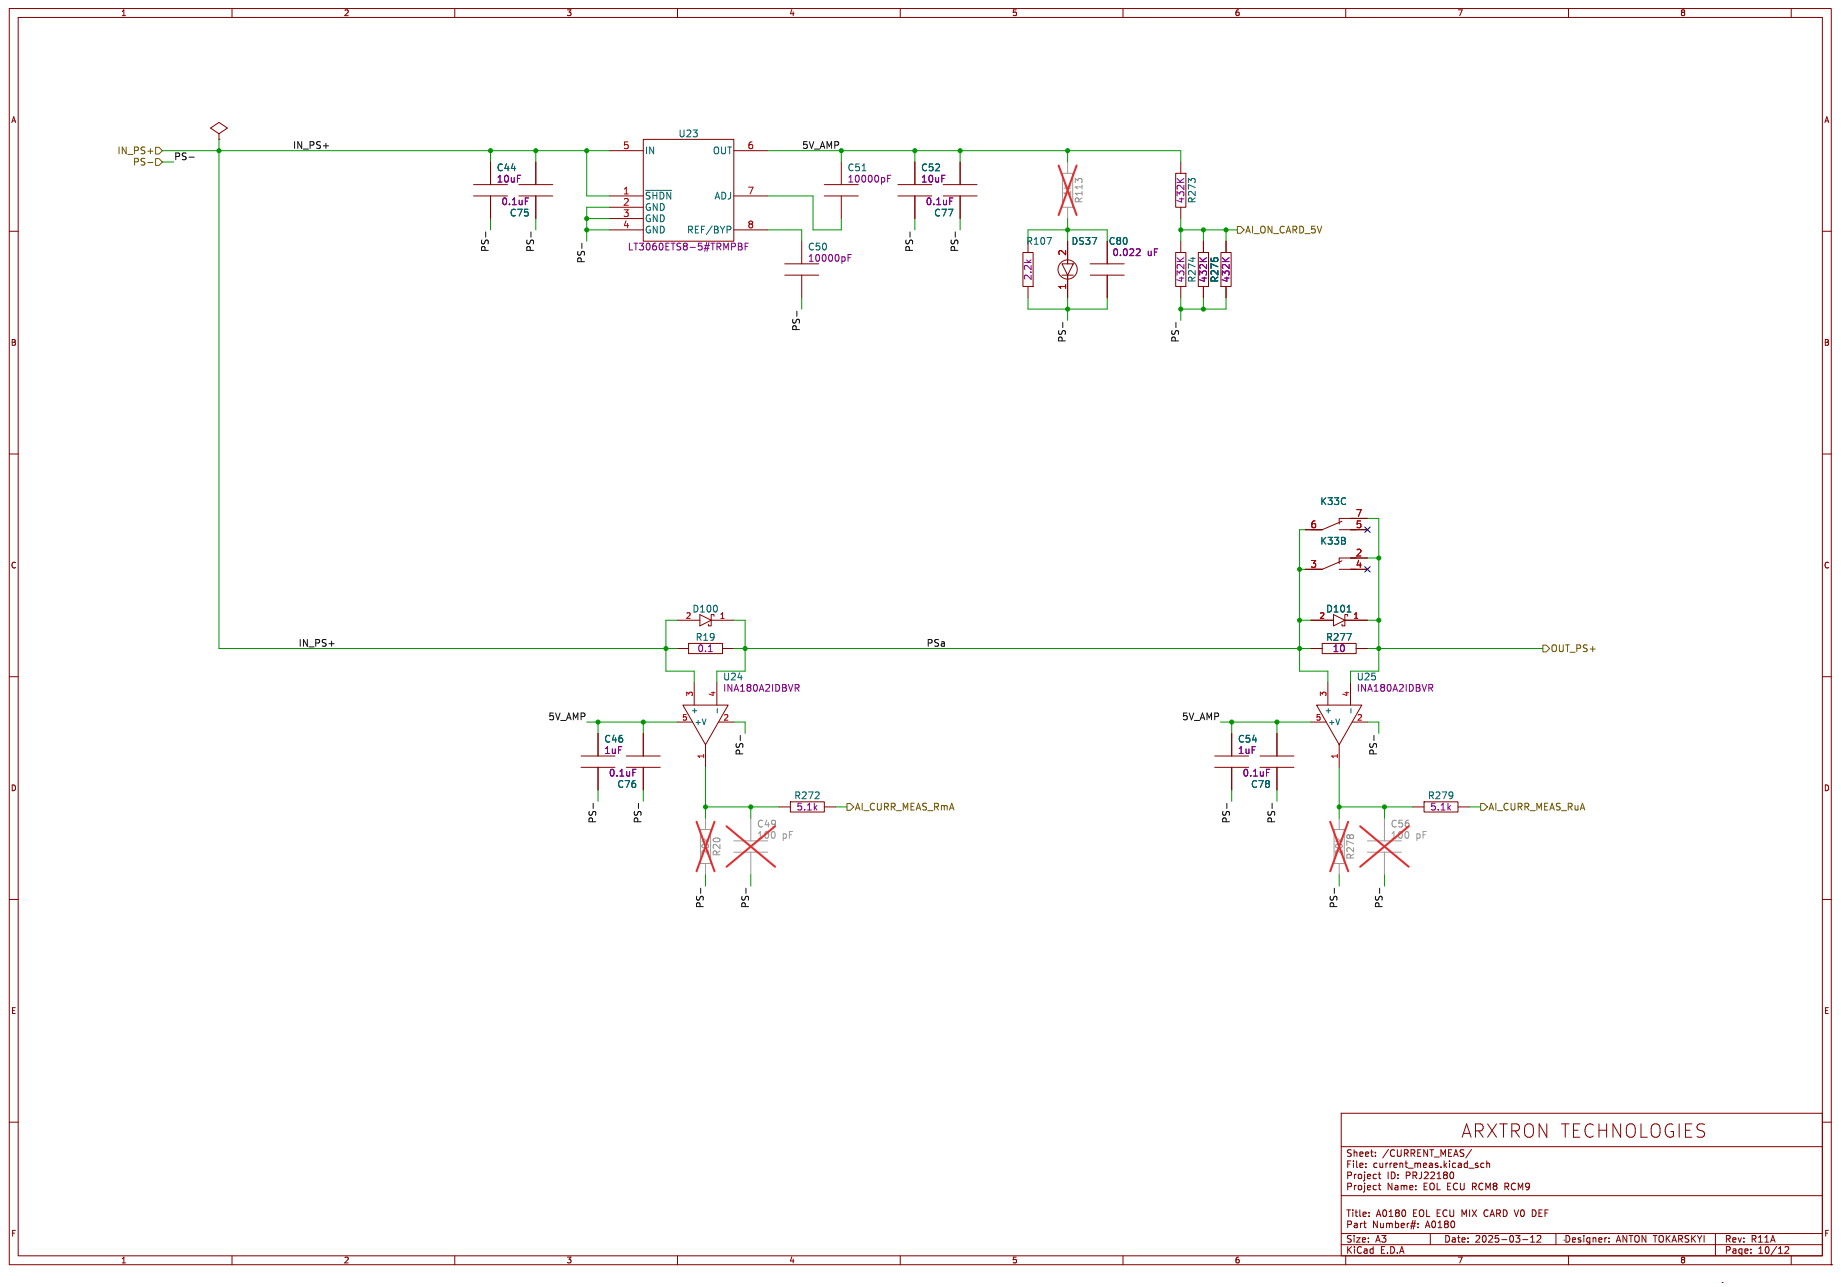
[picture p18: page 10]

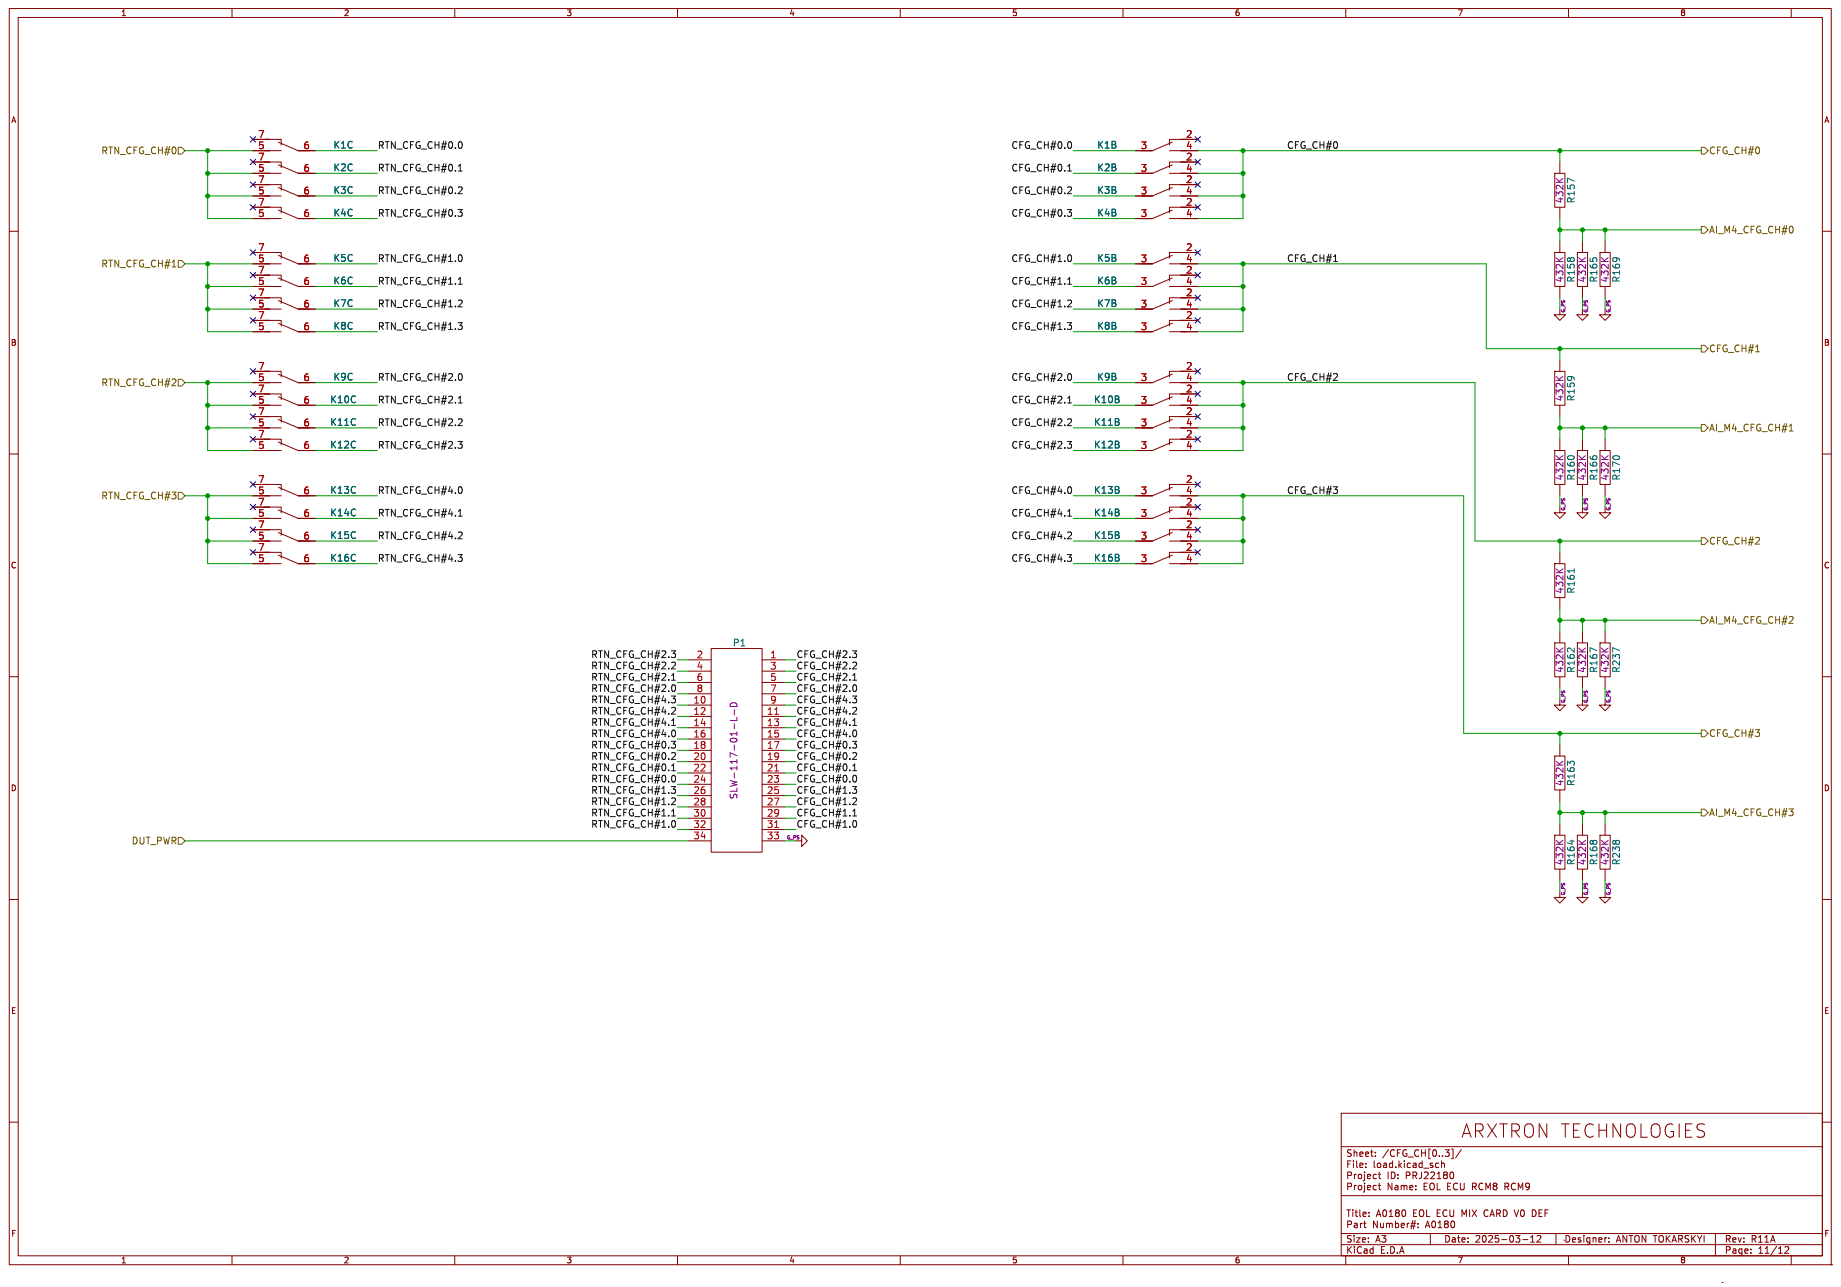
[picture p19: page 11]

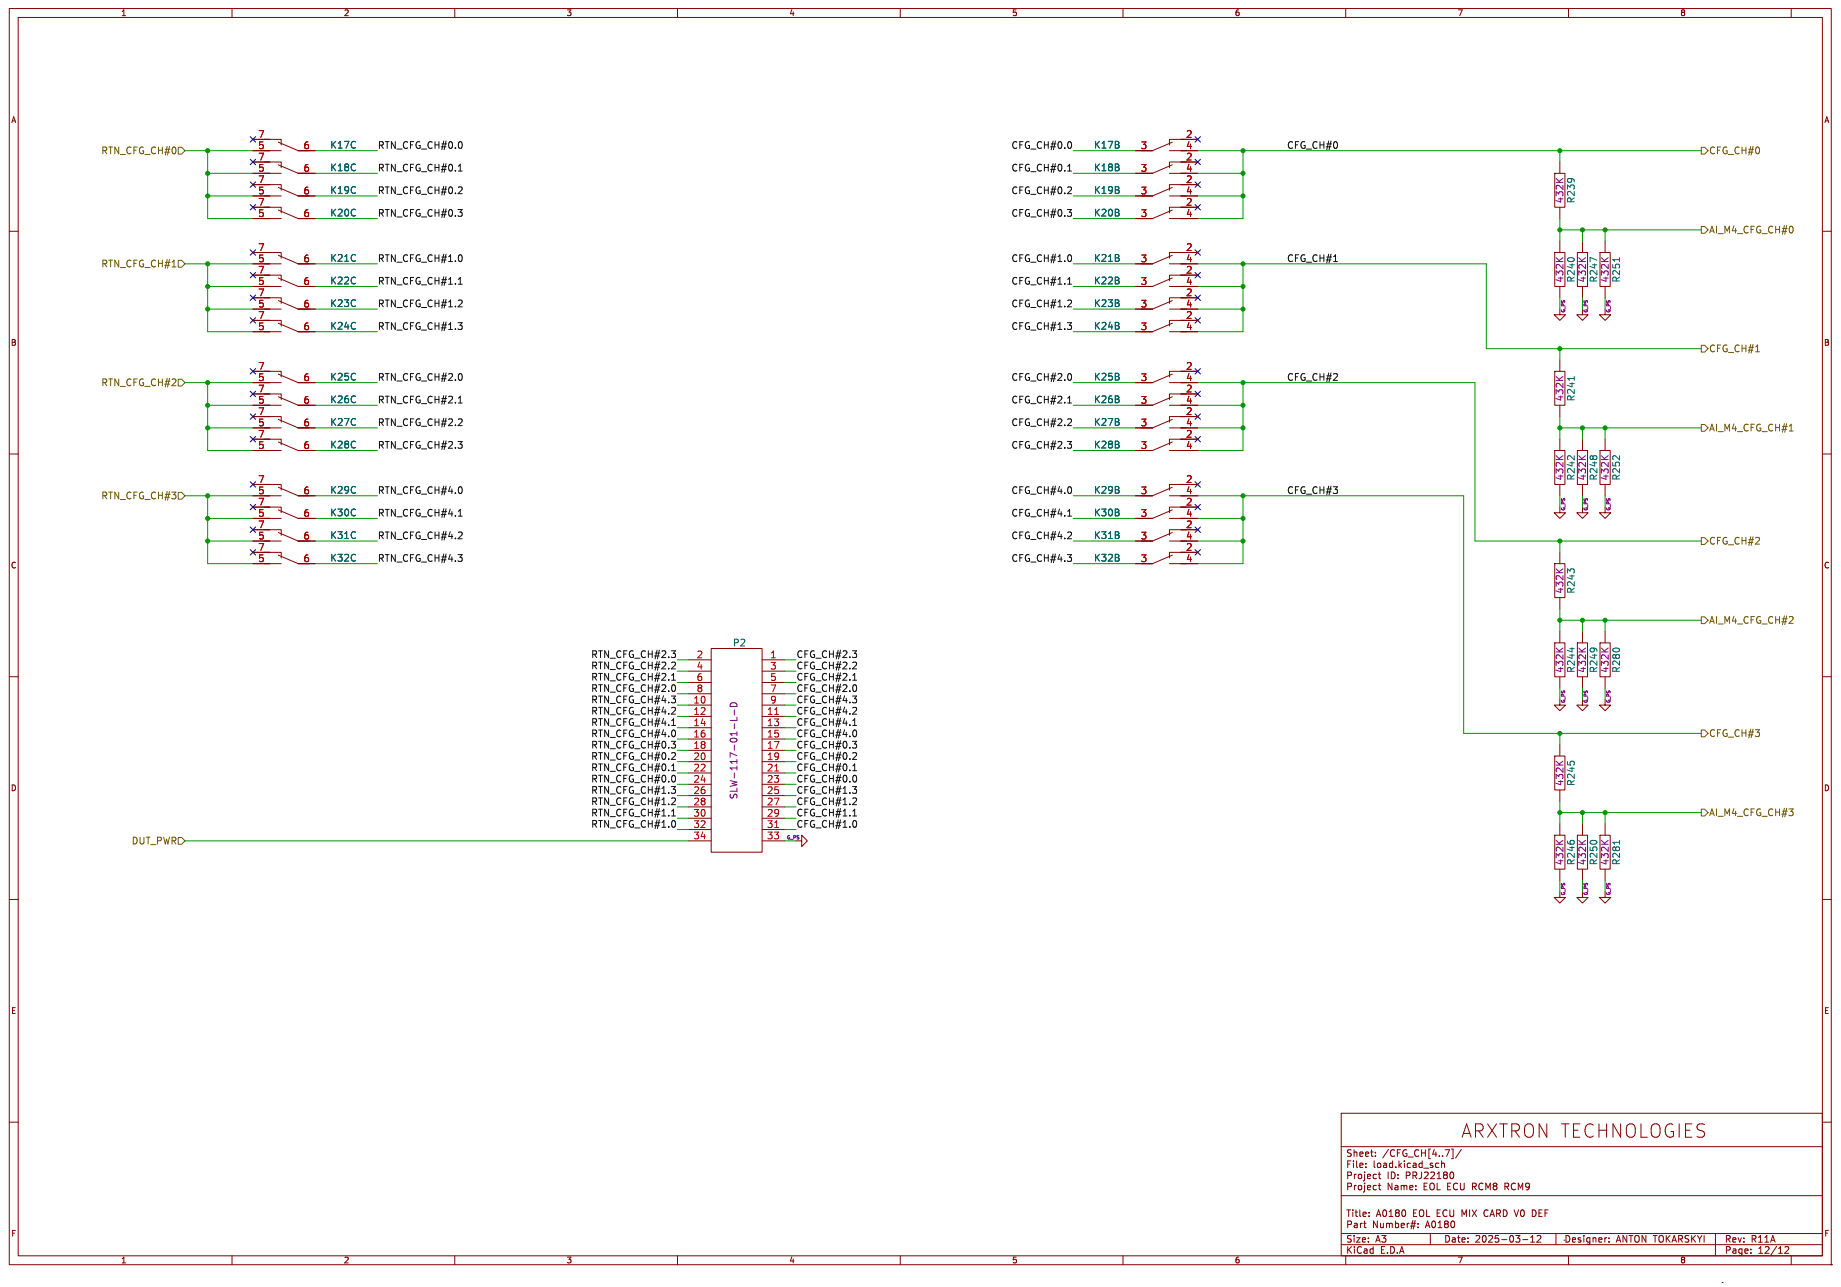
[picture p20: page 12]
