TokarskyiAnton/a0180_eol_ecu_mix/sch/A0180_EOL ECU MIX CARD_R11_V0_DEF.pdf

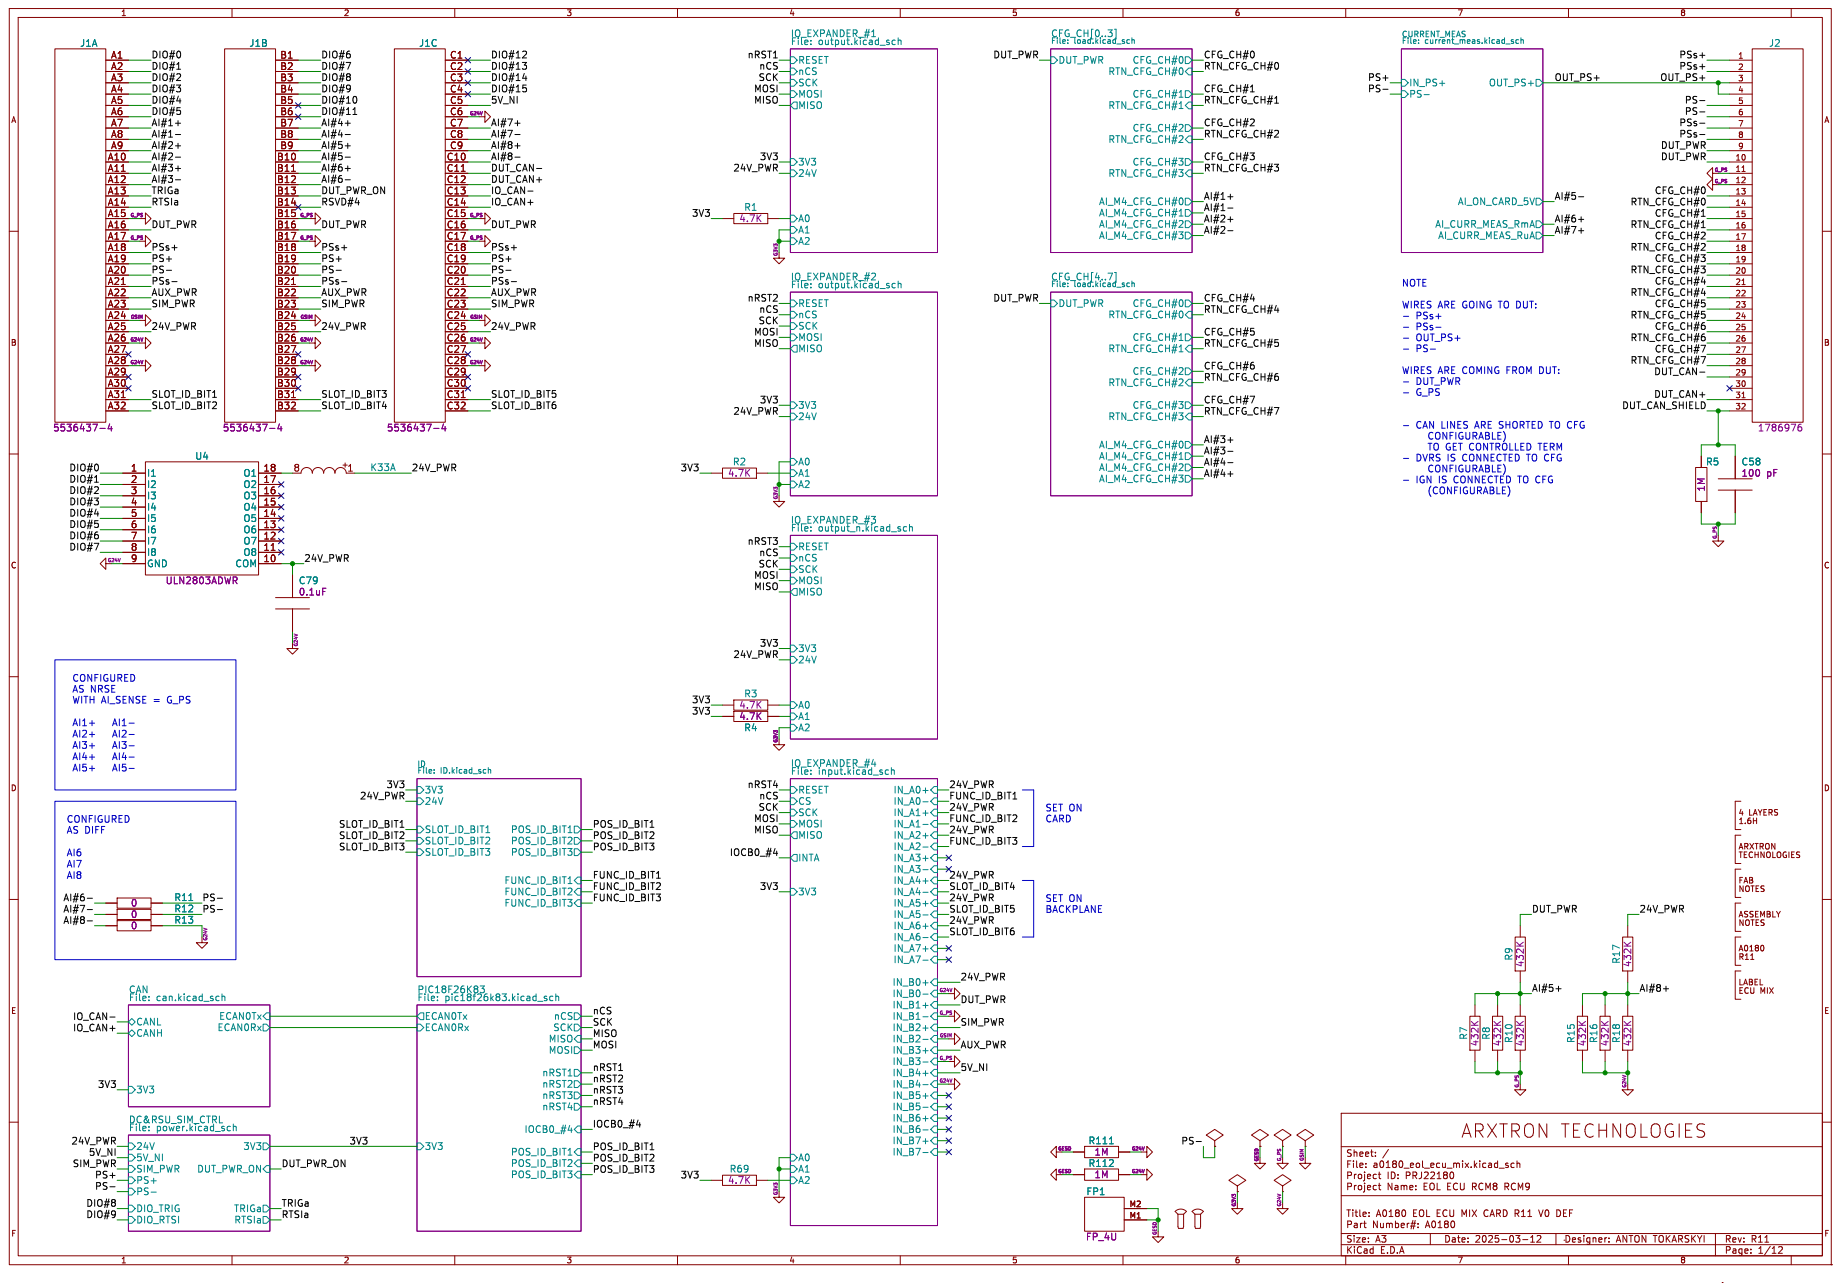
[picture p21: page 1]

WIRES ARE GOING TO DUT: - PSs+

WIRES ARE COMING FROM DUT: - DUT_PWR

- CAN LINES ARE SHORTED TO CFG
CONFIGURABLE)
- DVRS IS CONNECTED TO CFG
- IGN IS CONNECTED TO CFG
(CONFIGURABLE)

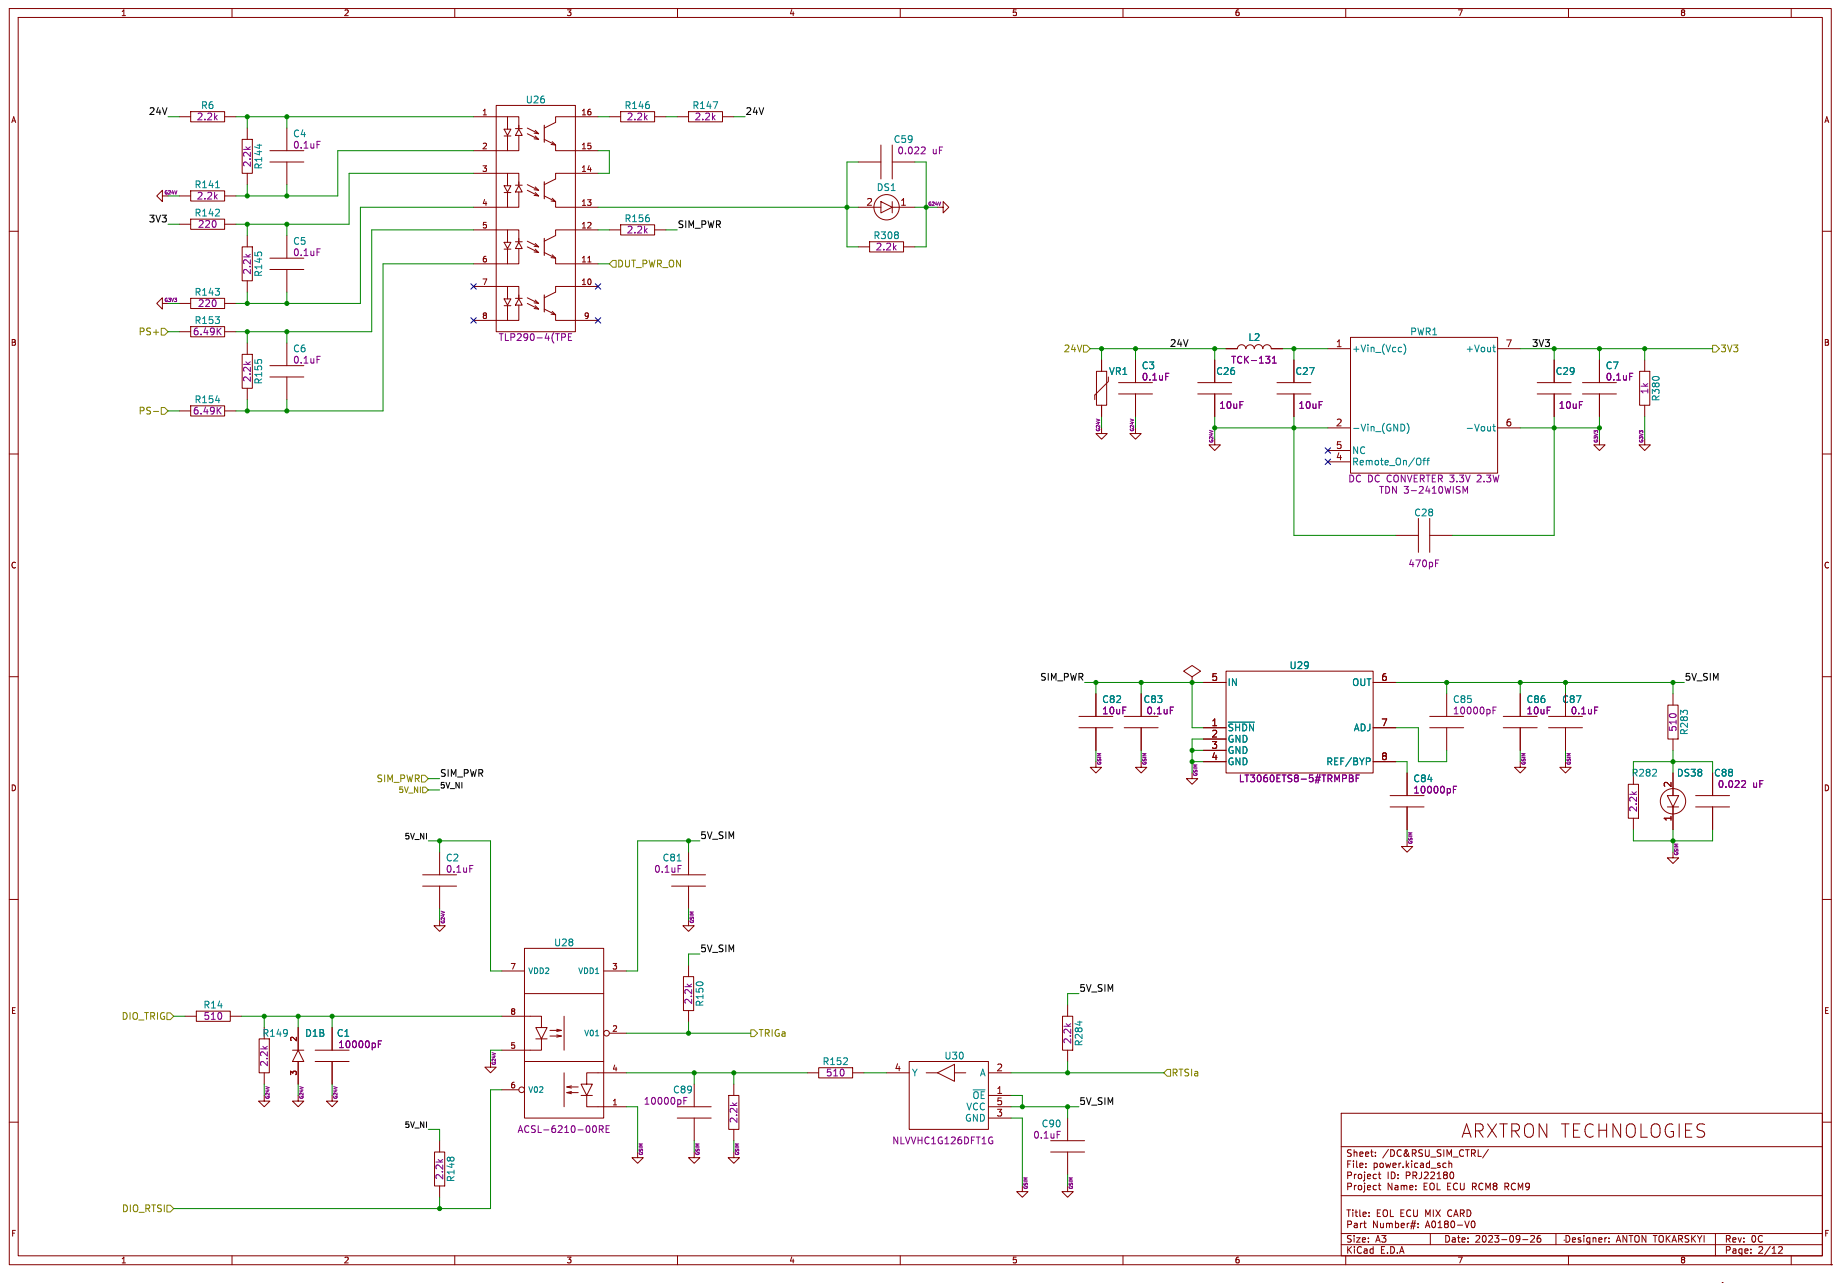
[picture p22: page 2]

File: power.kicad_sch Sheet: /DC&RSU_SIM_CTRL/

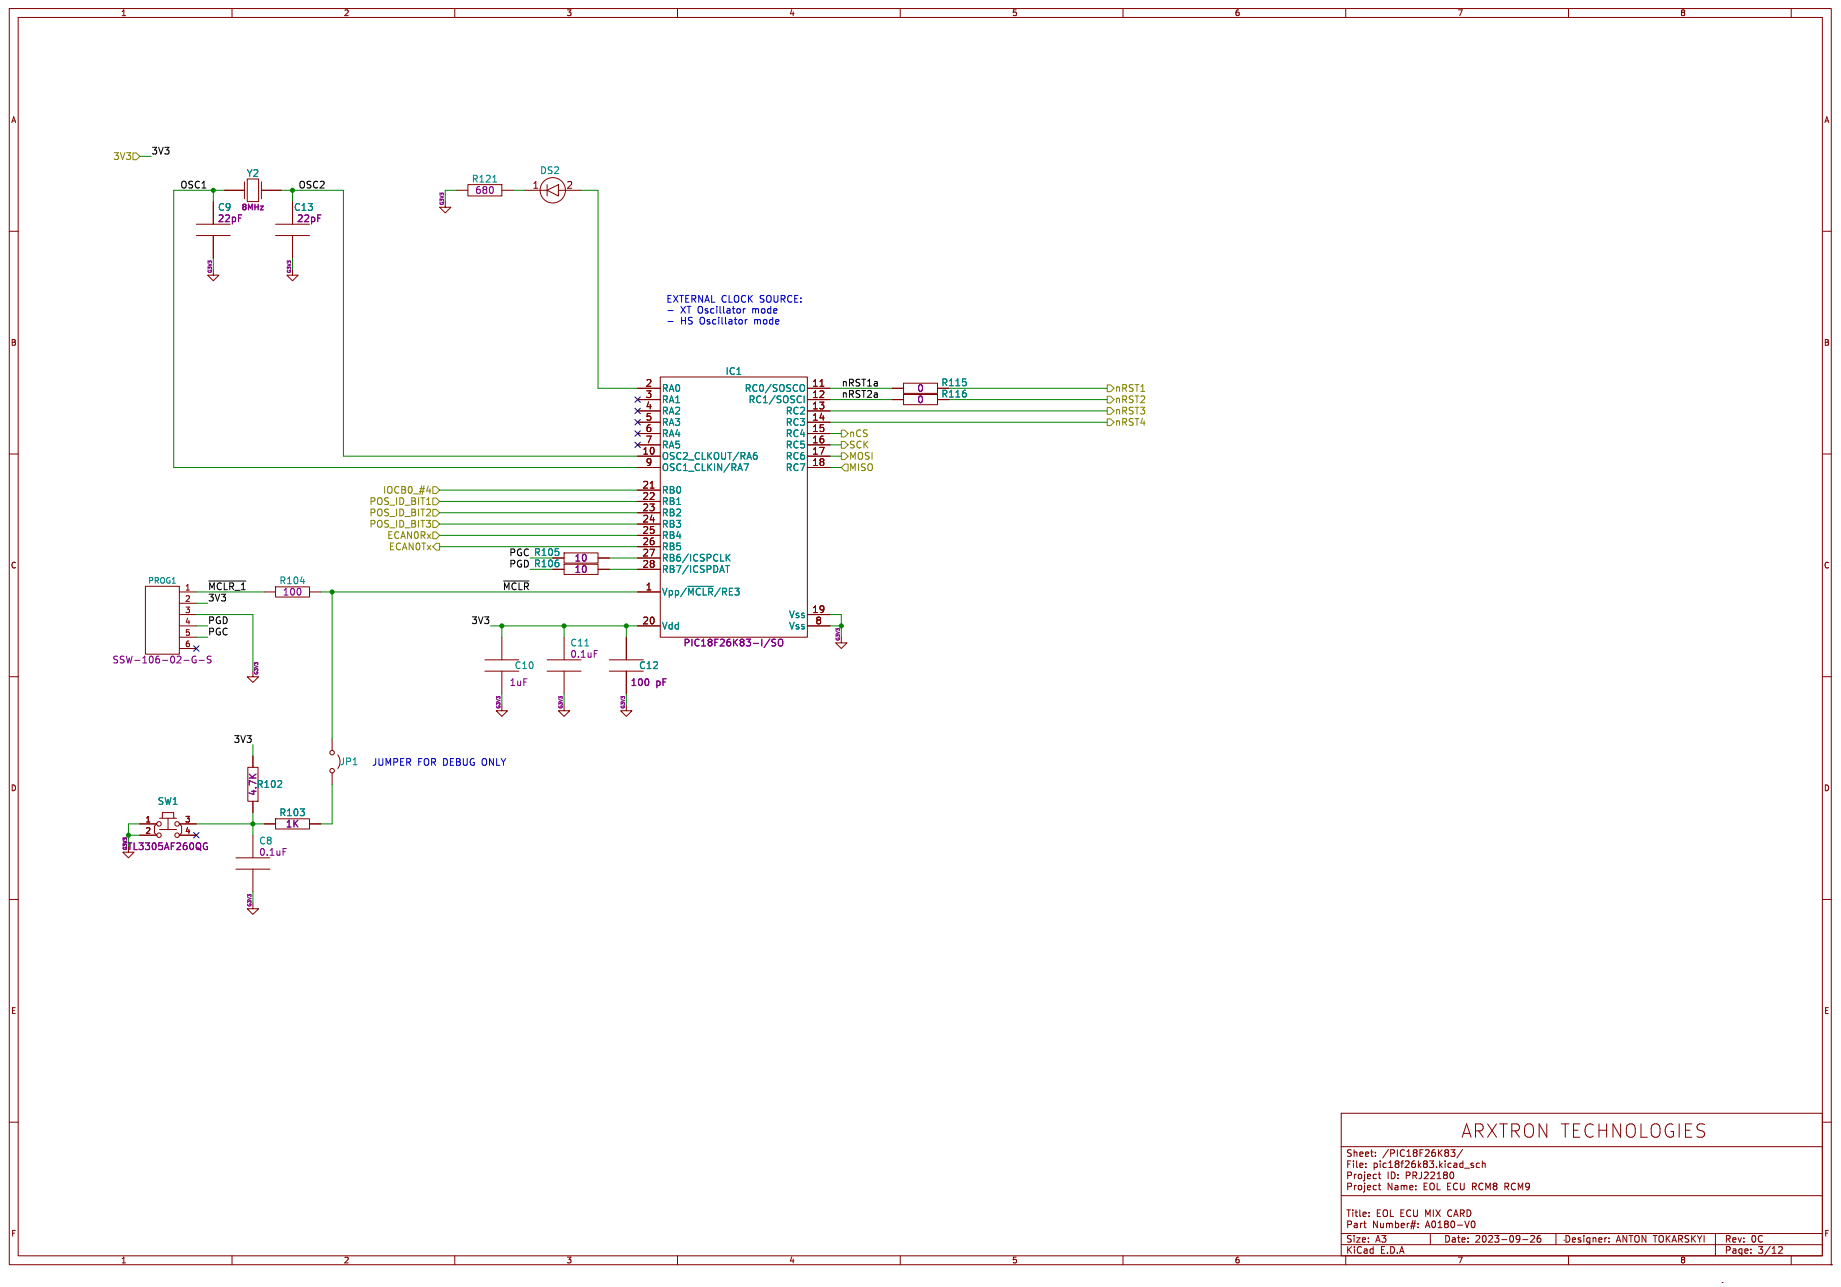
[picture p23: page 3]

JUMPER FOR DEBUG ONLY

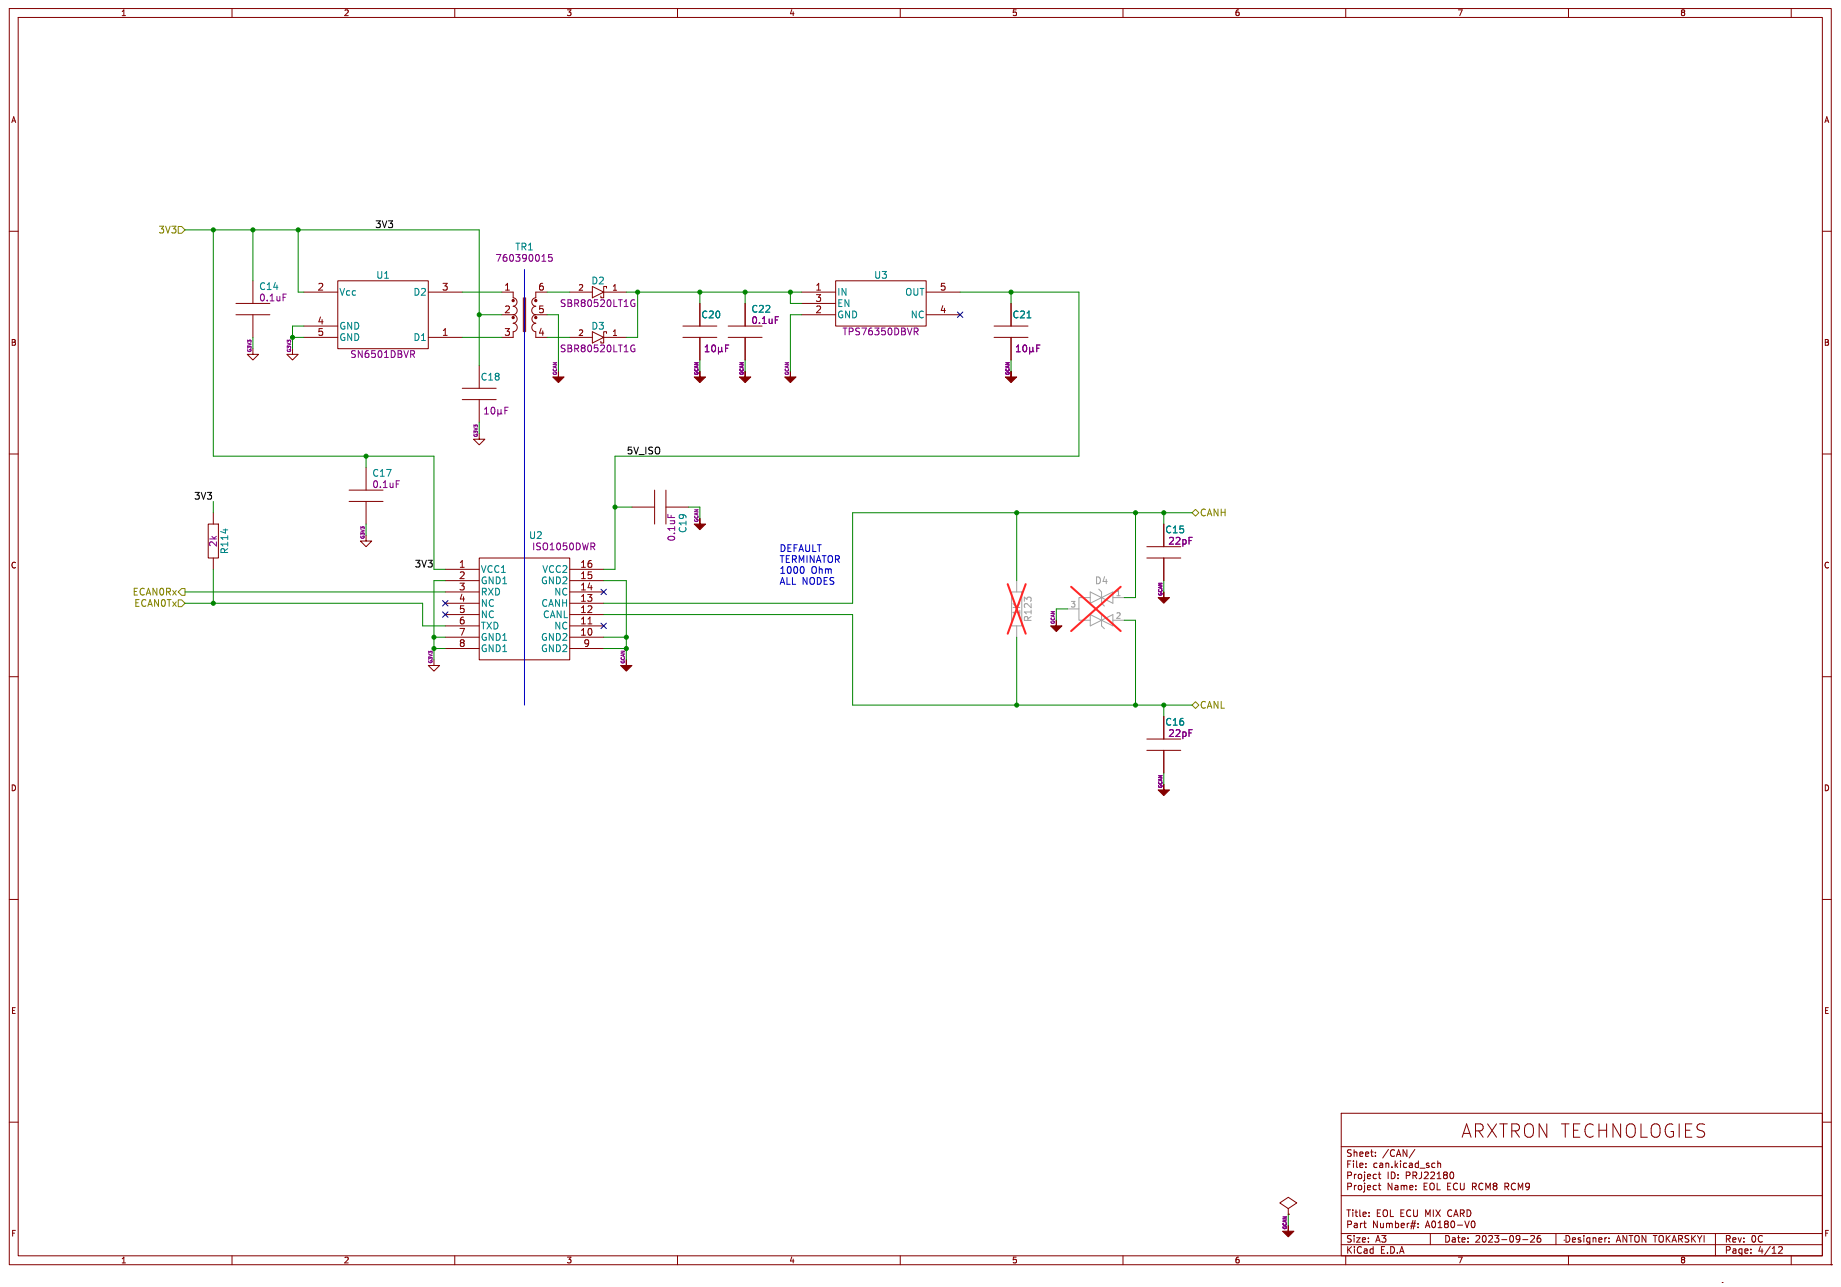
[picture p24: page 4]

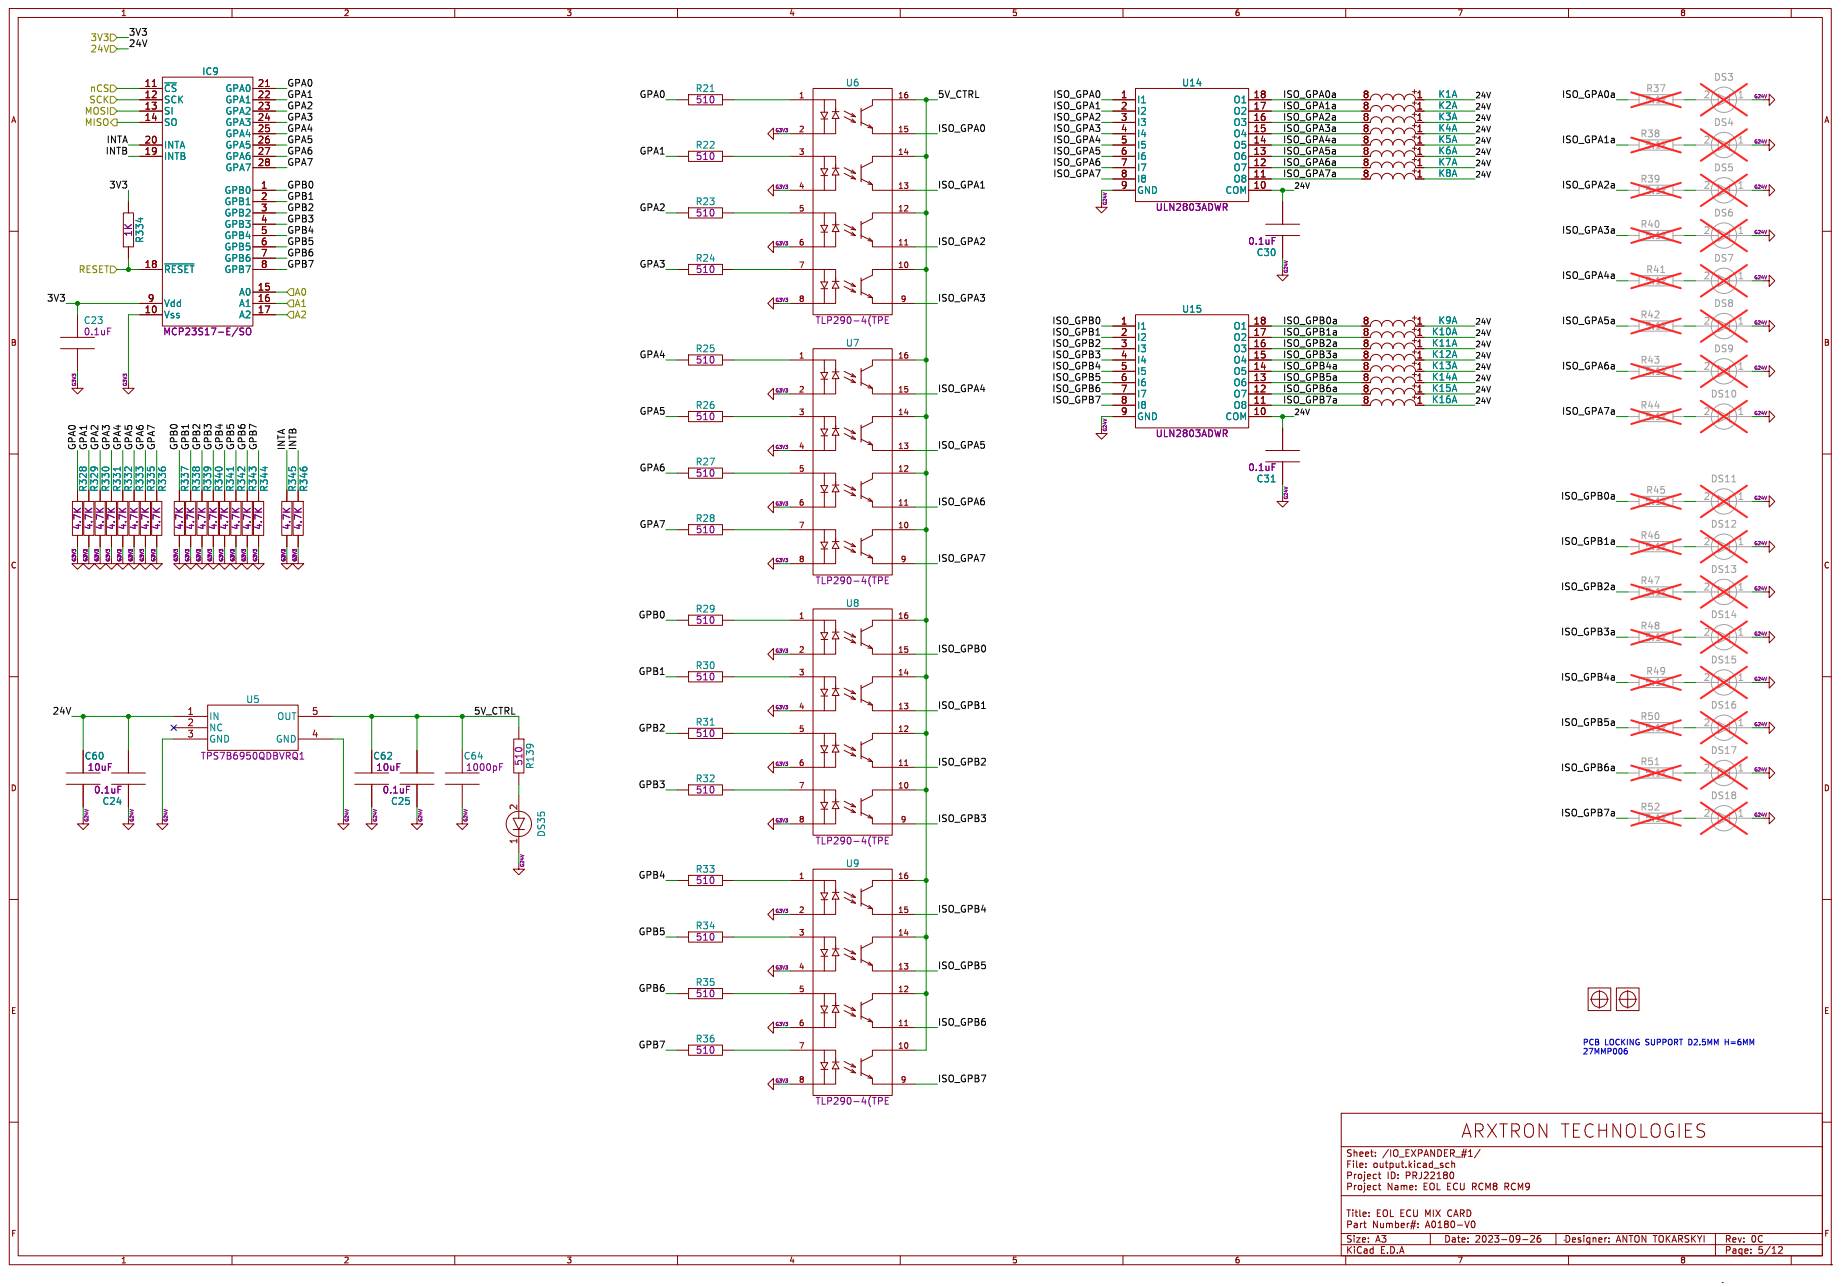
[picture p25: page 5]

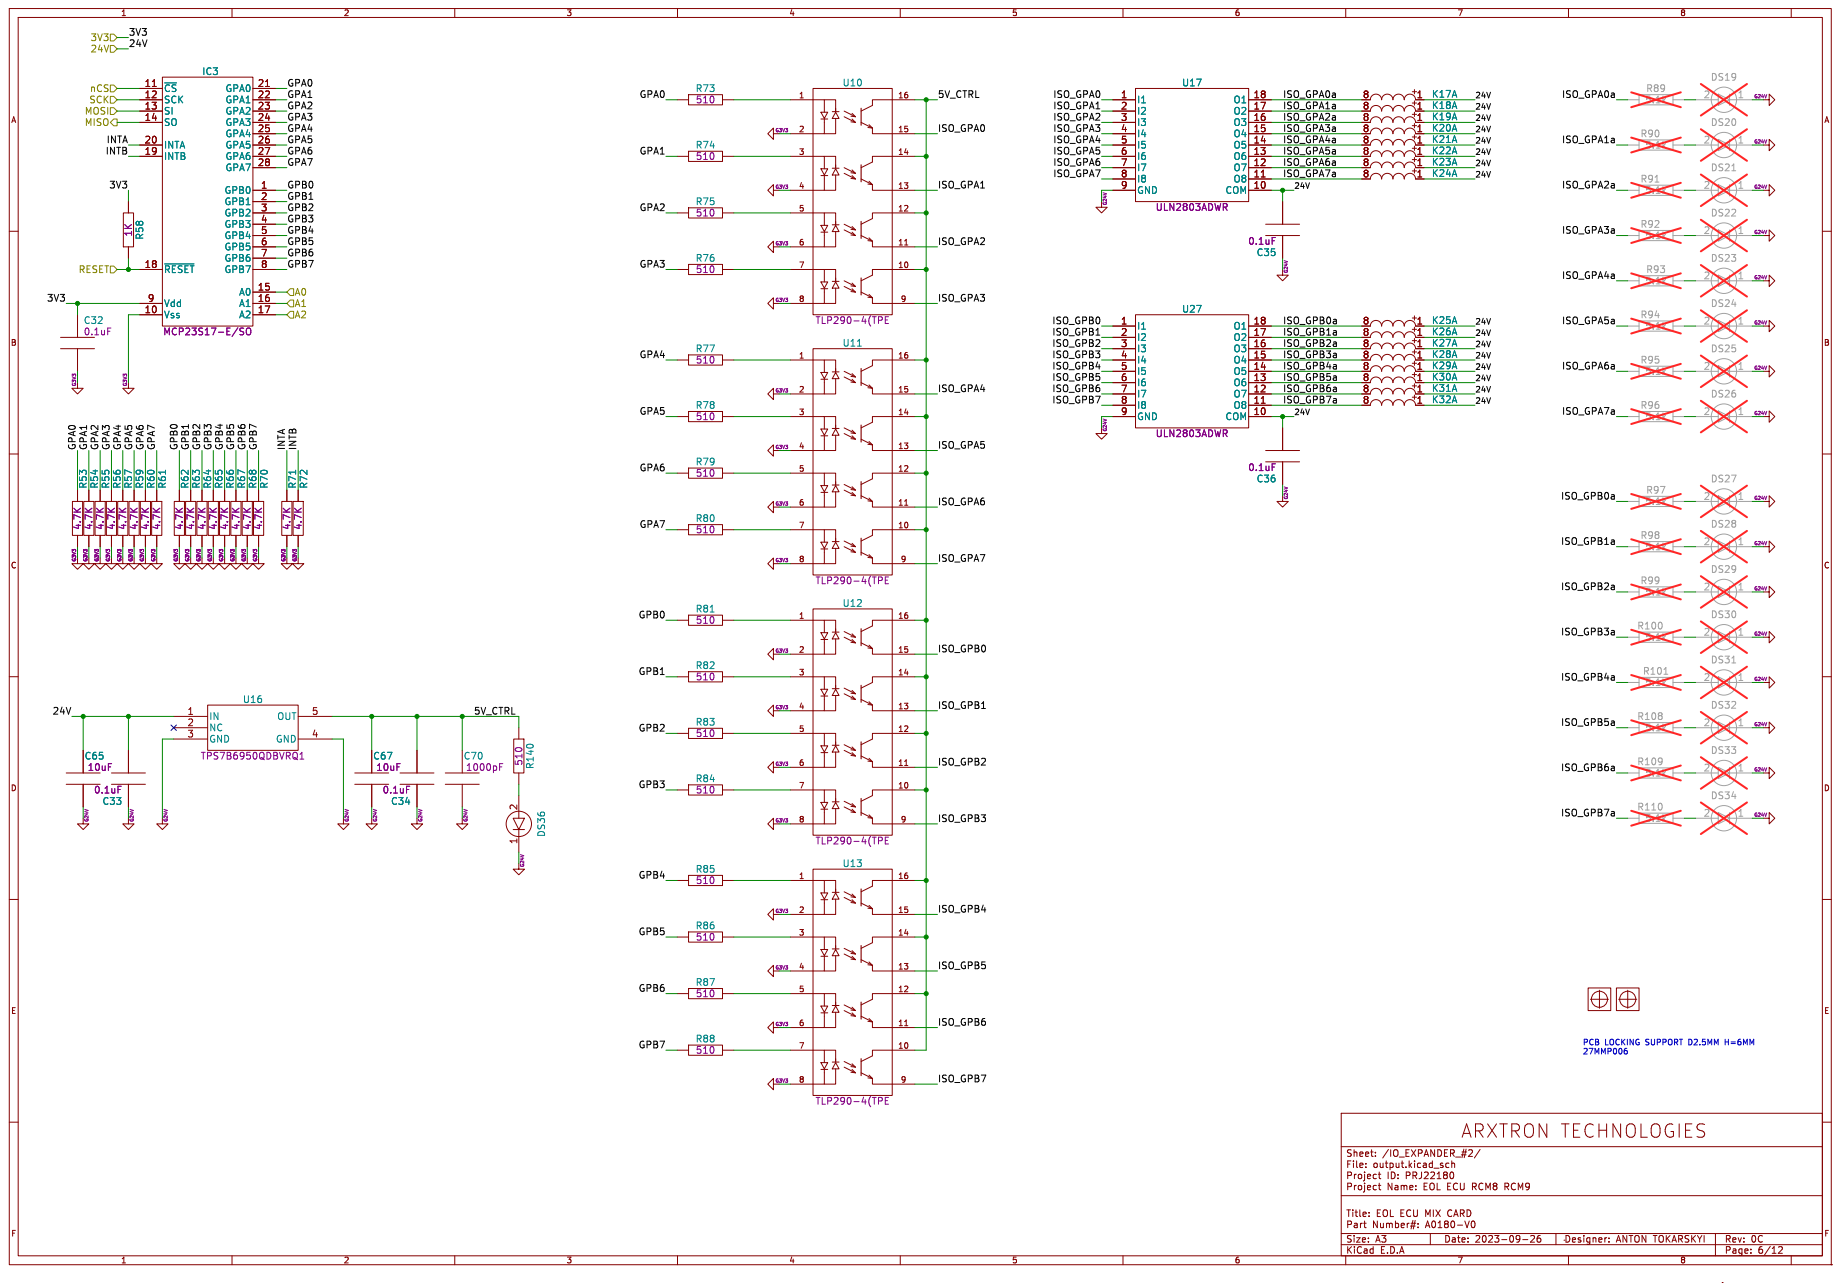
[picture p26: page 6]

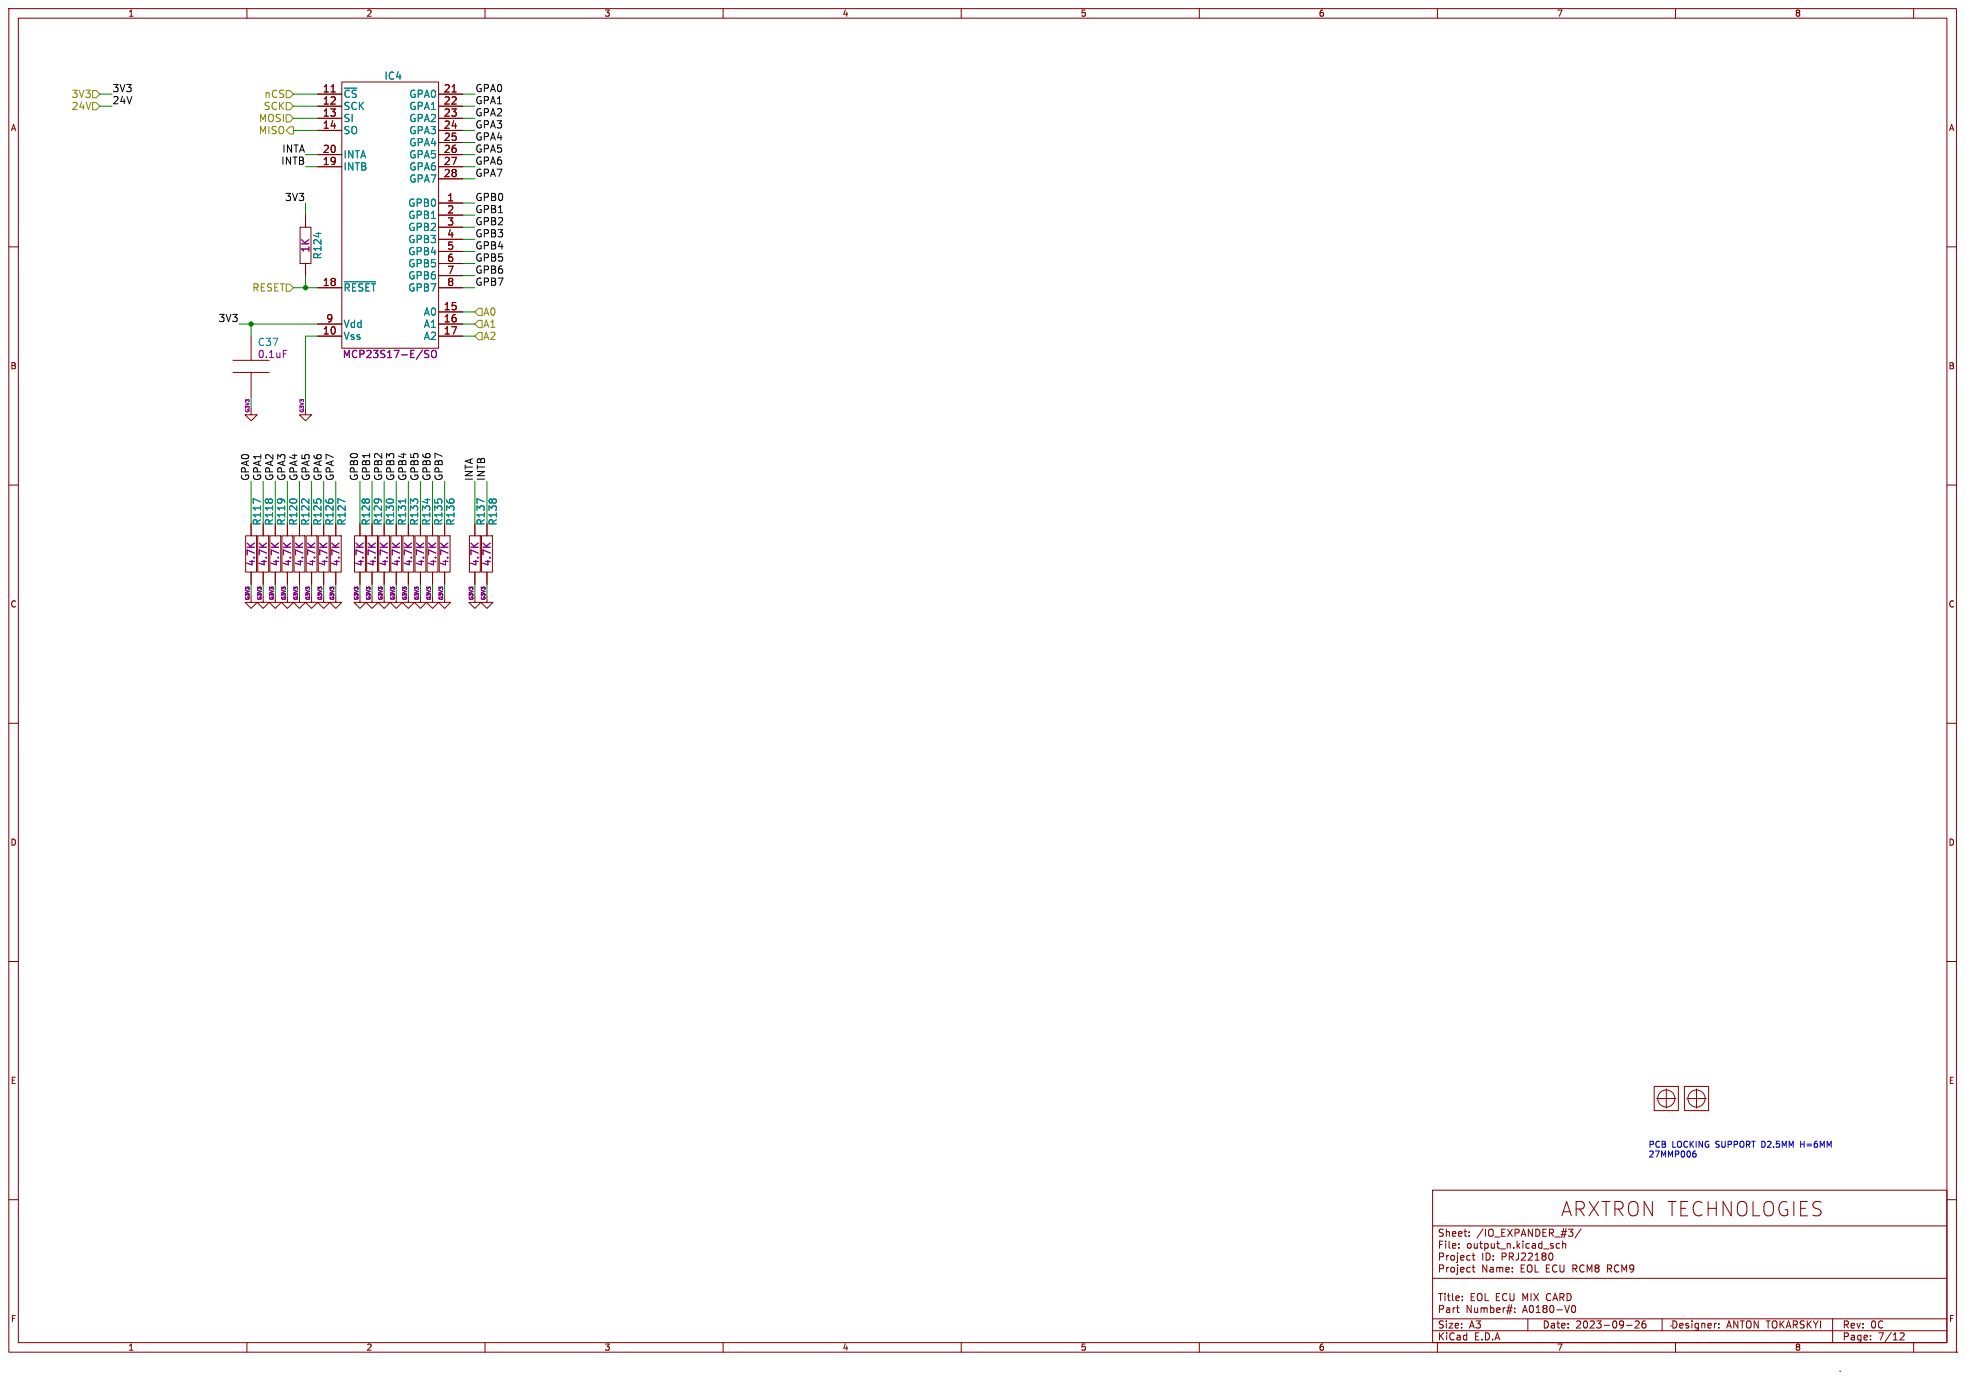
[picture p27: page 7]

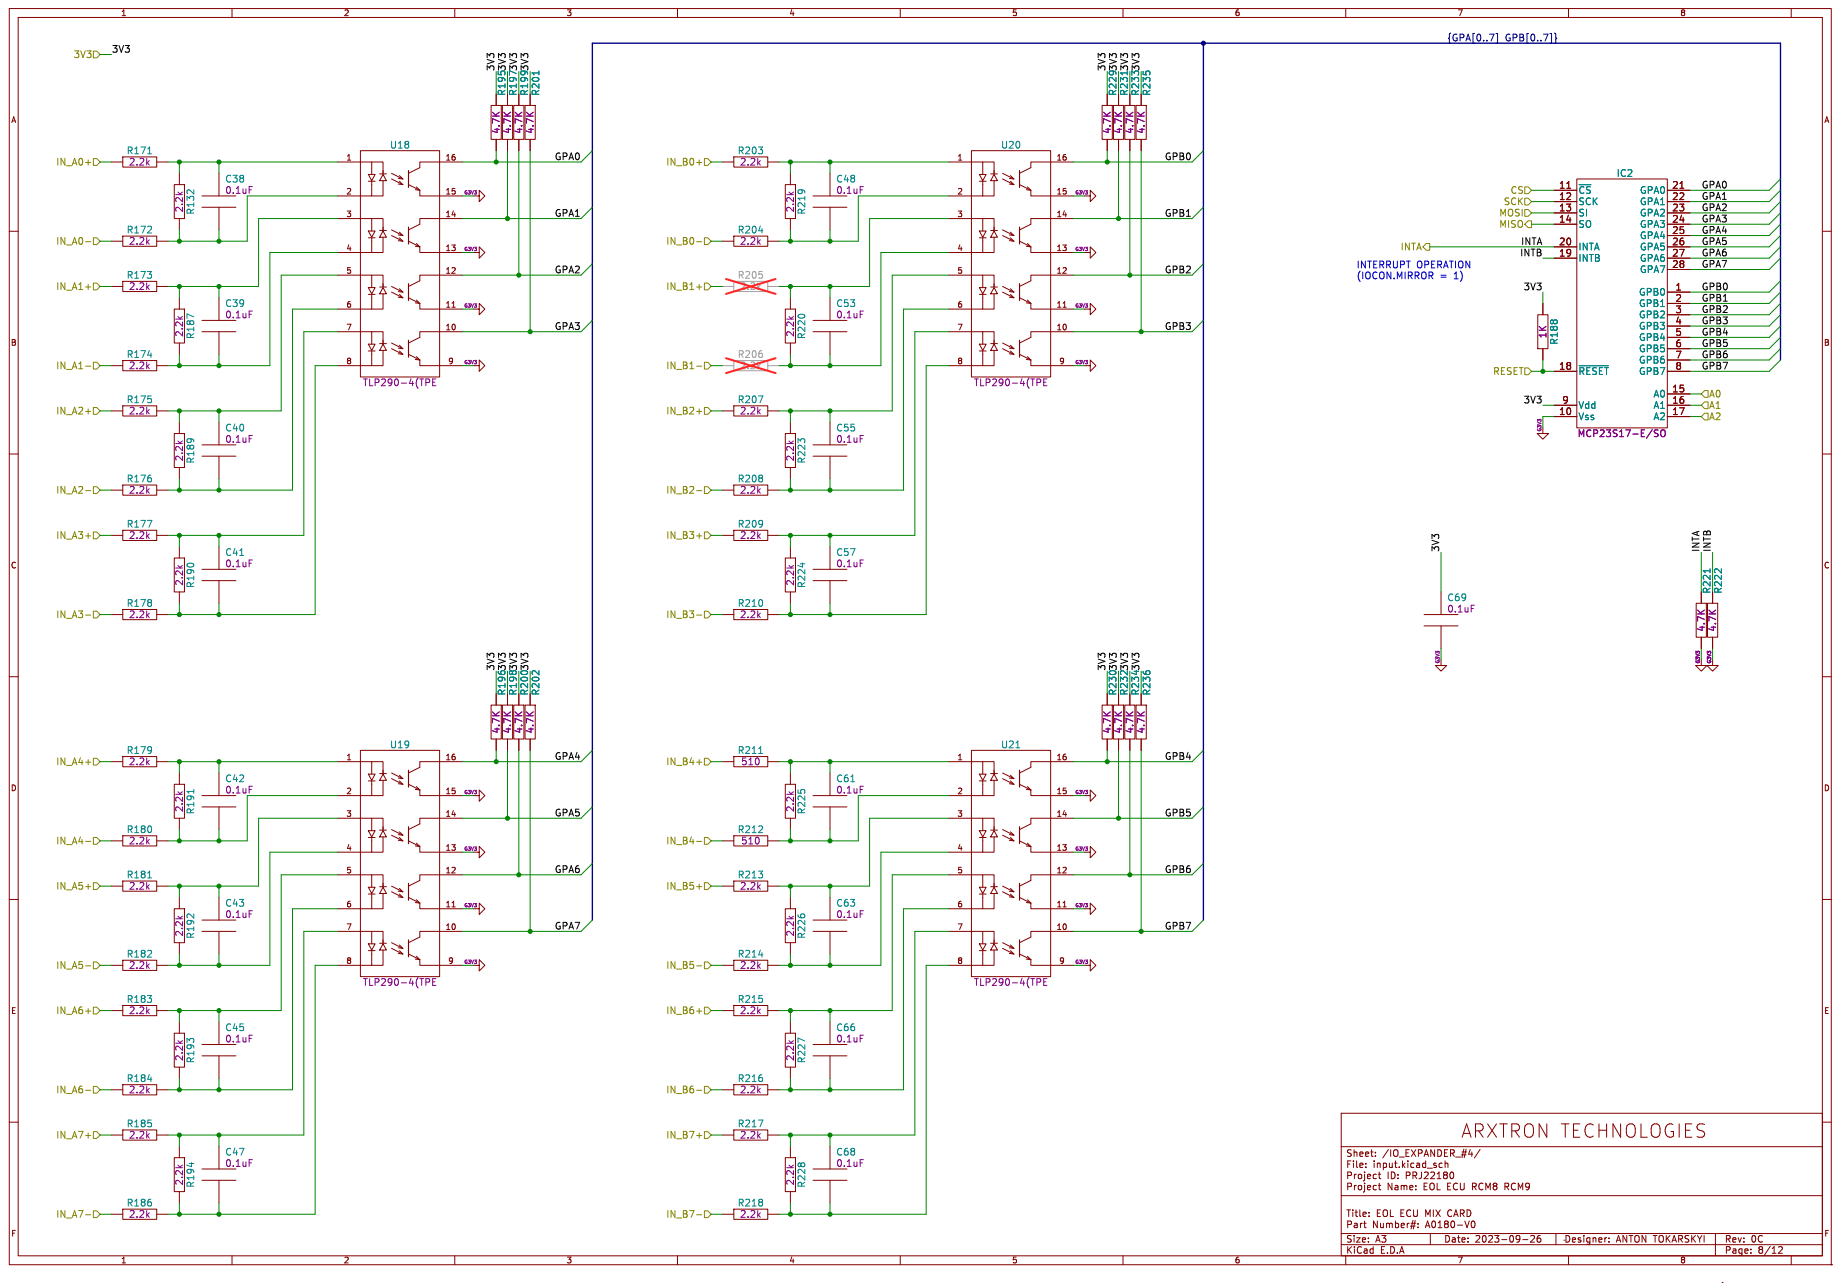
[picture p28: page 8]

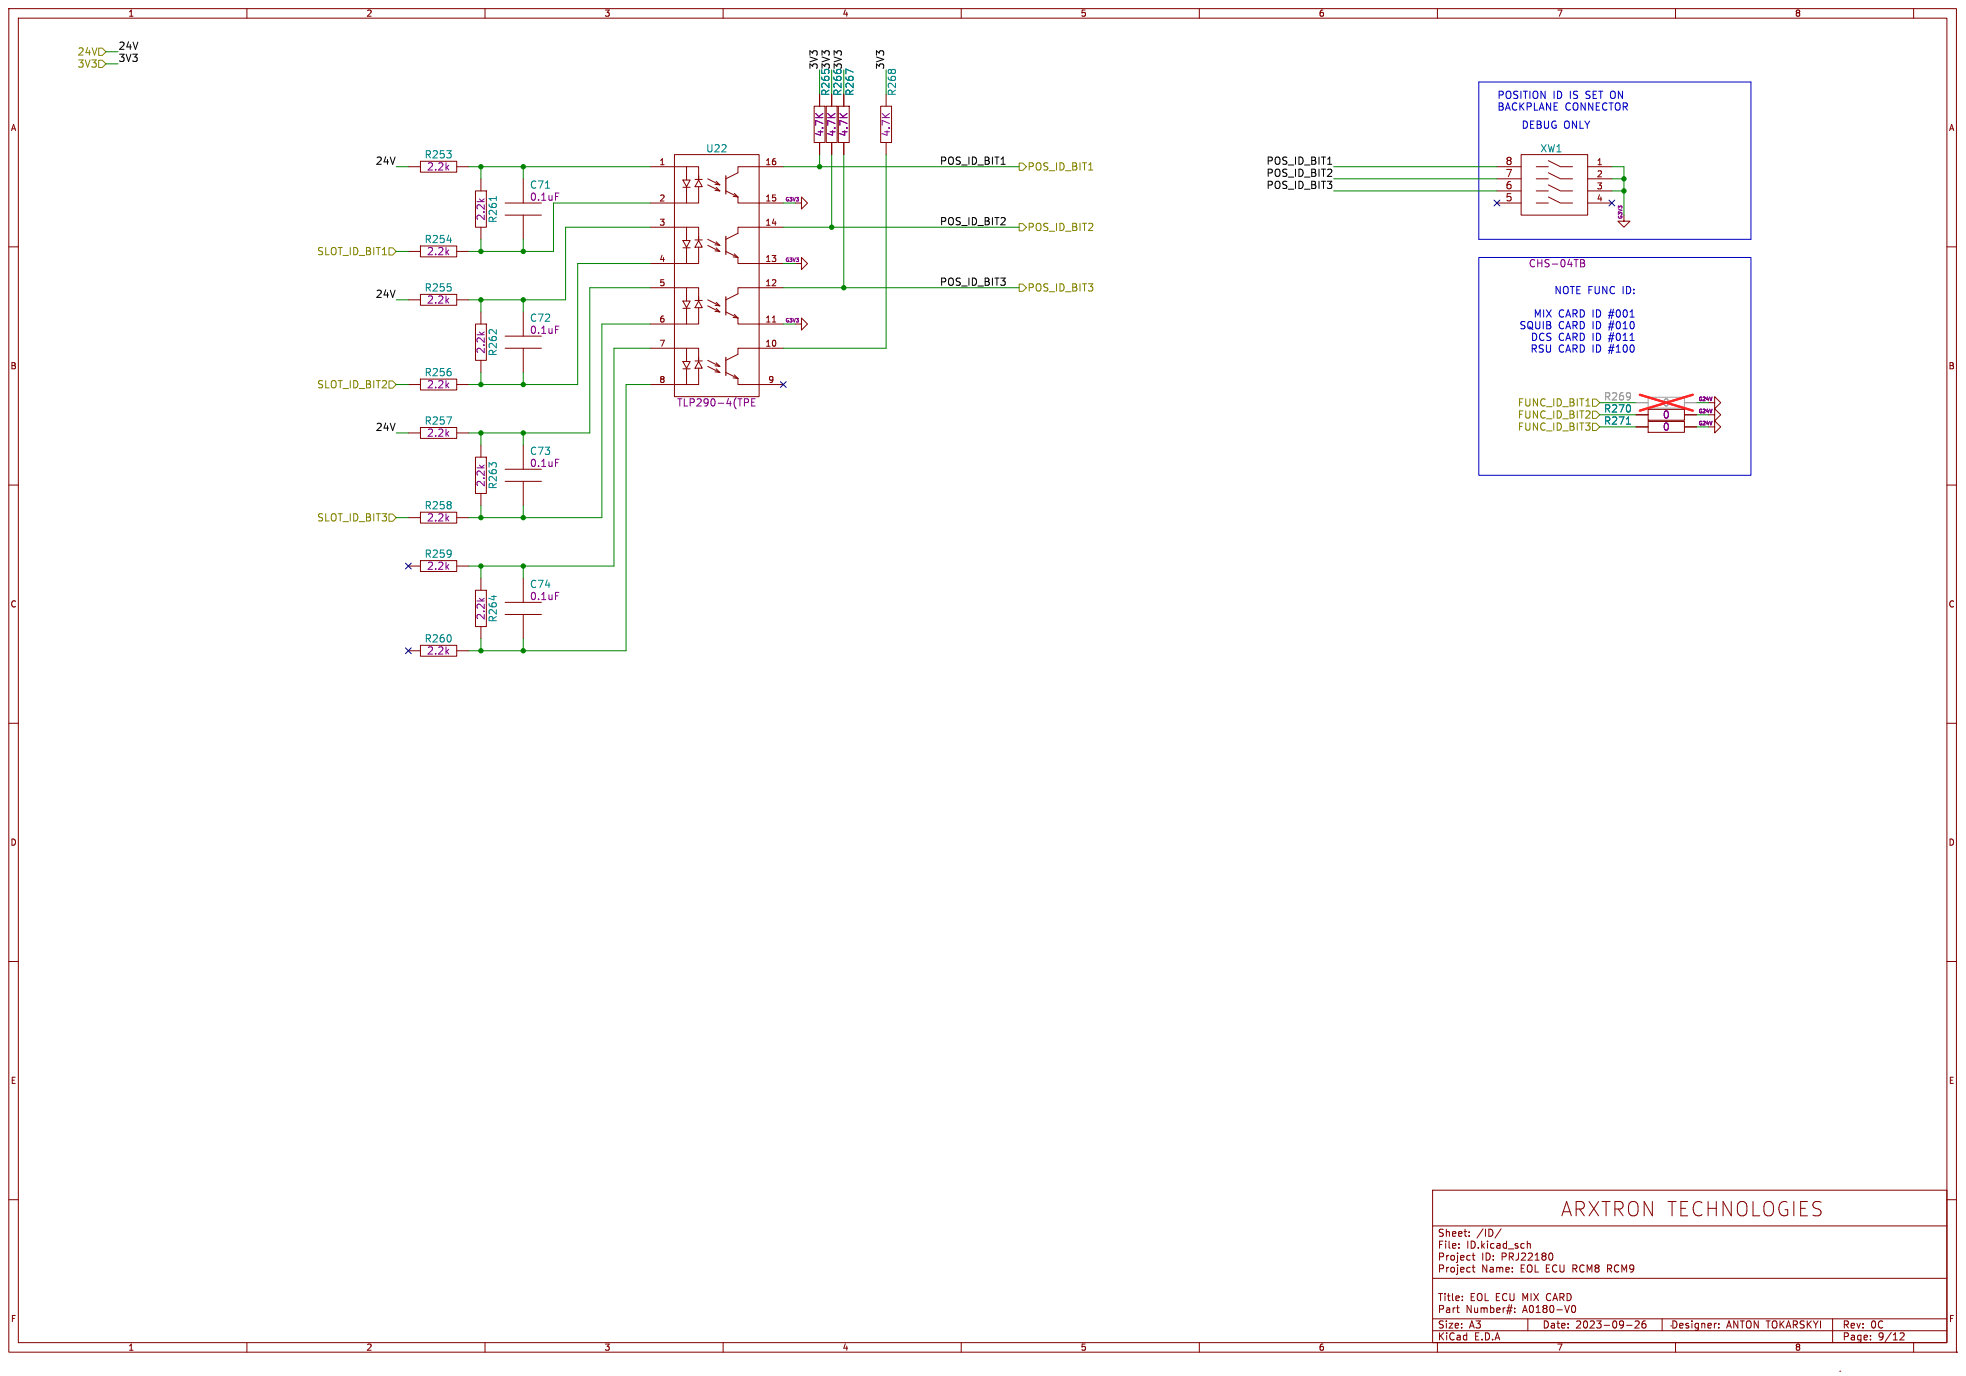
[picture p29: page 9]

POSITION ID IS SET ON
BACKPLANE CONNECTOR
DEBUG ONLY

NOTE FUNC ID: MIX CARD ID #001 SQUIB CARD ID #010 DCS CARD ID #011 RSU CARD ID #100

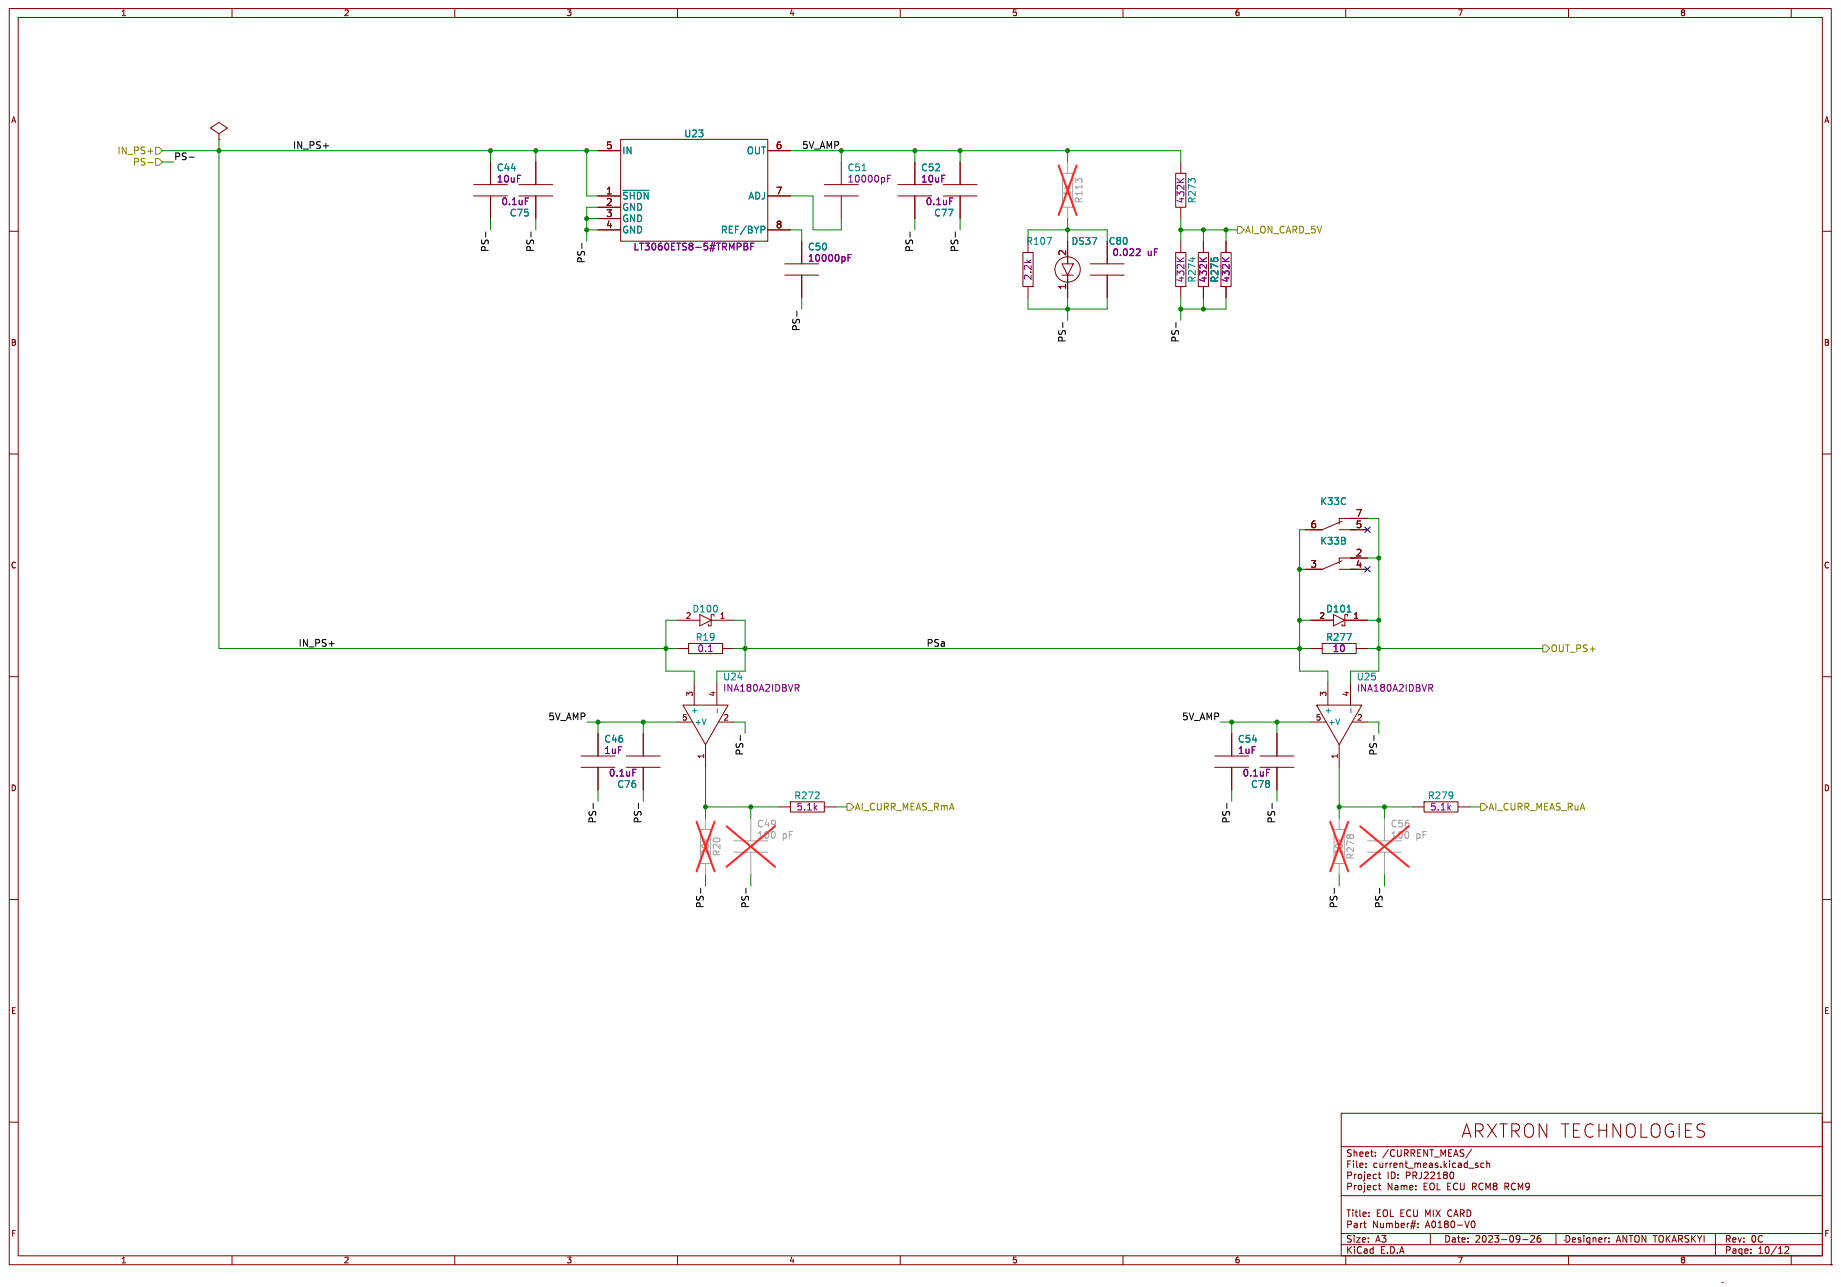
[picture p30: page 10]

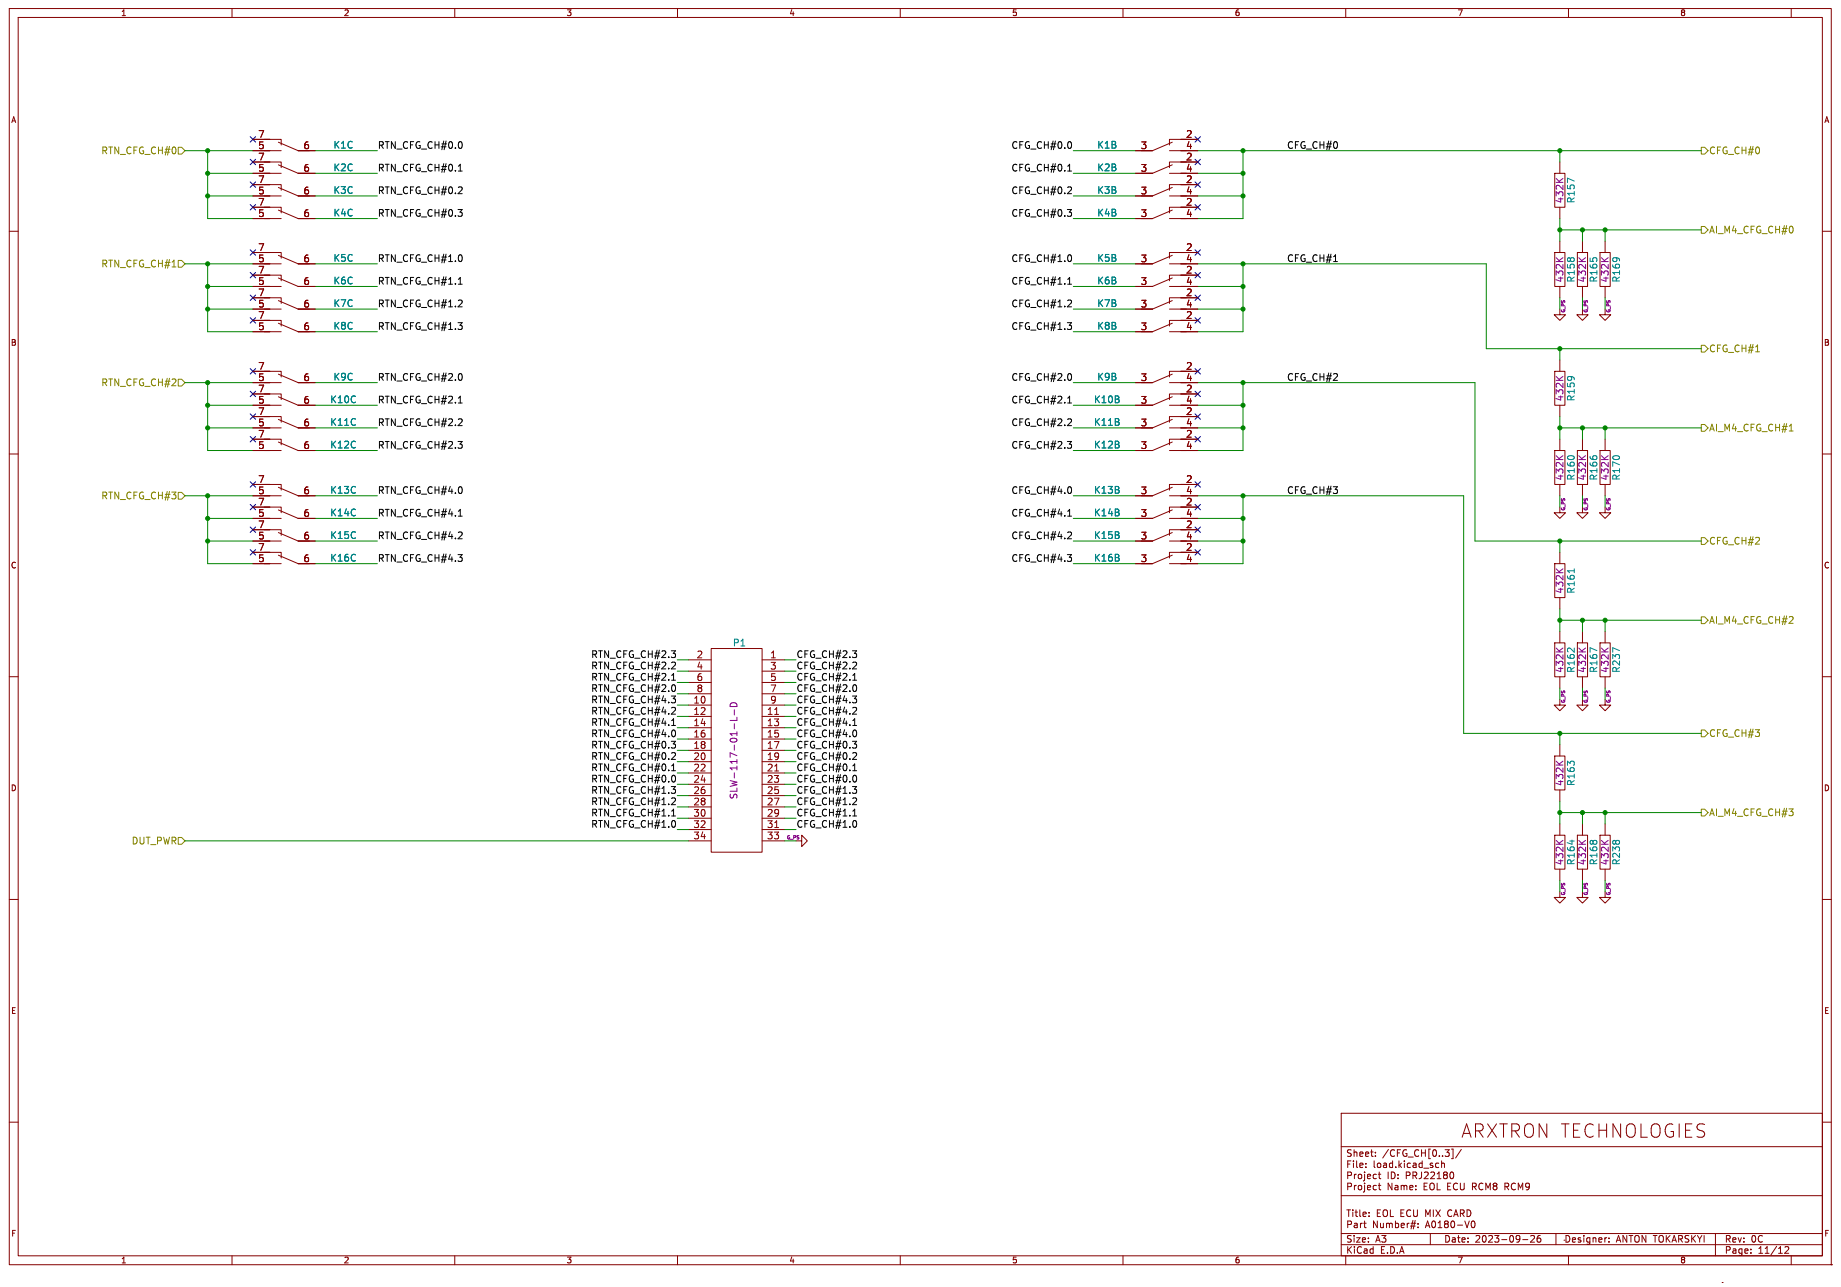
[picture p31: page 11]

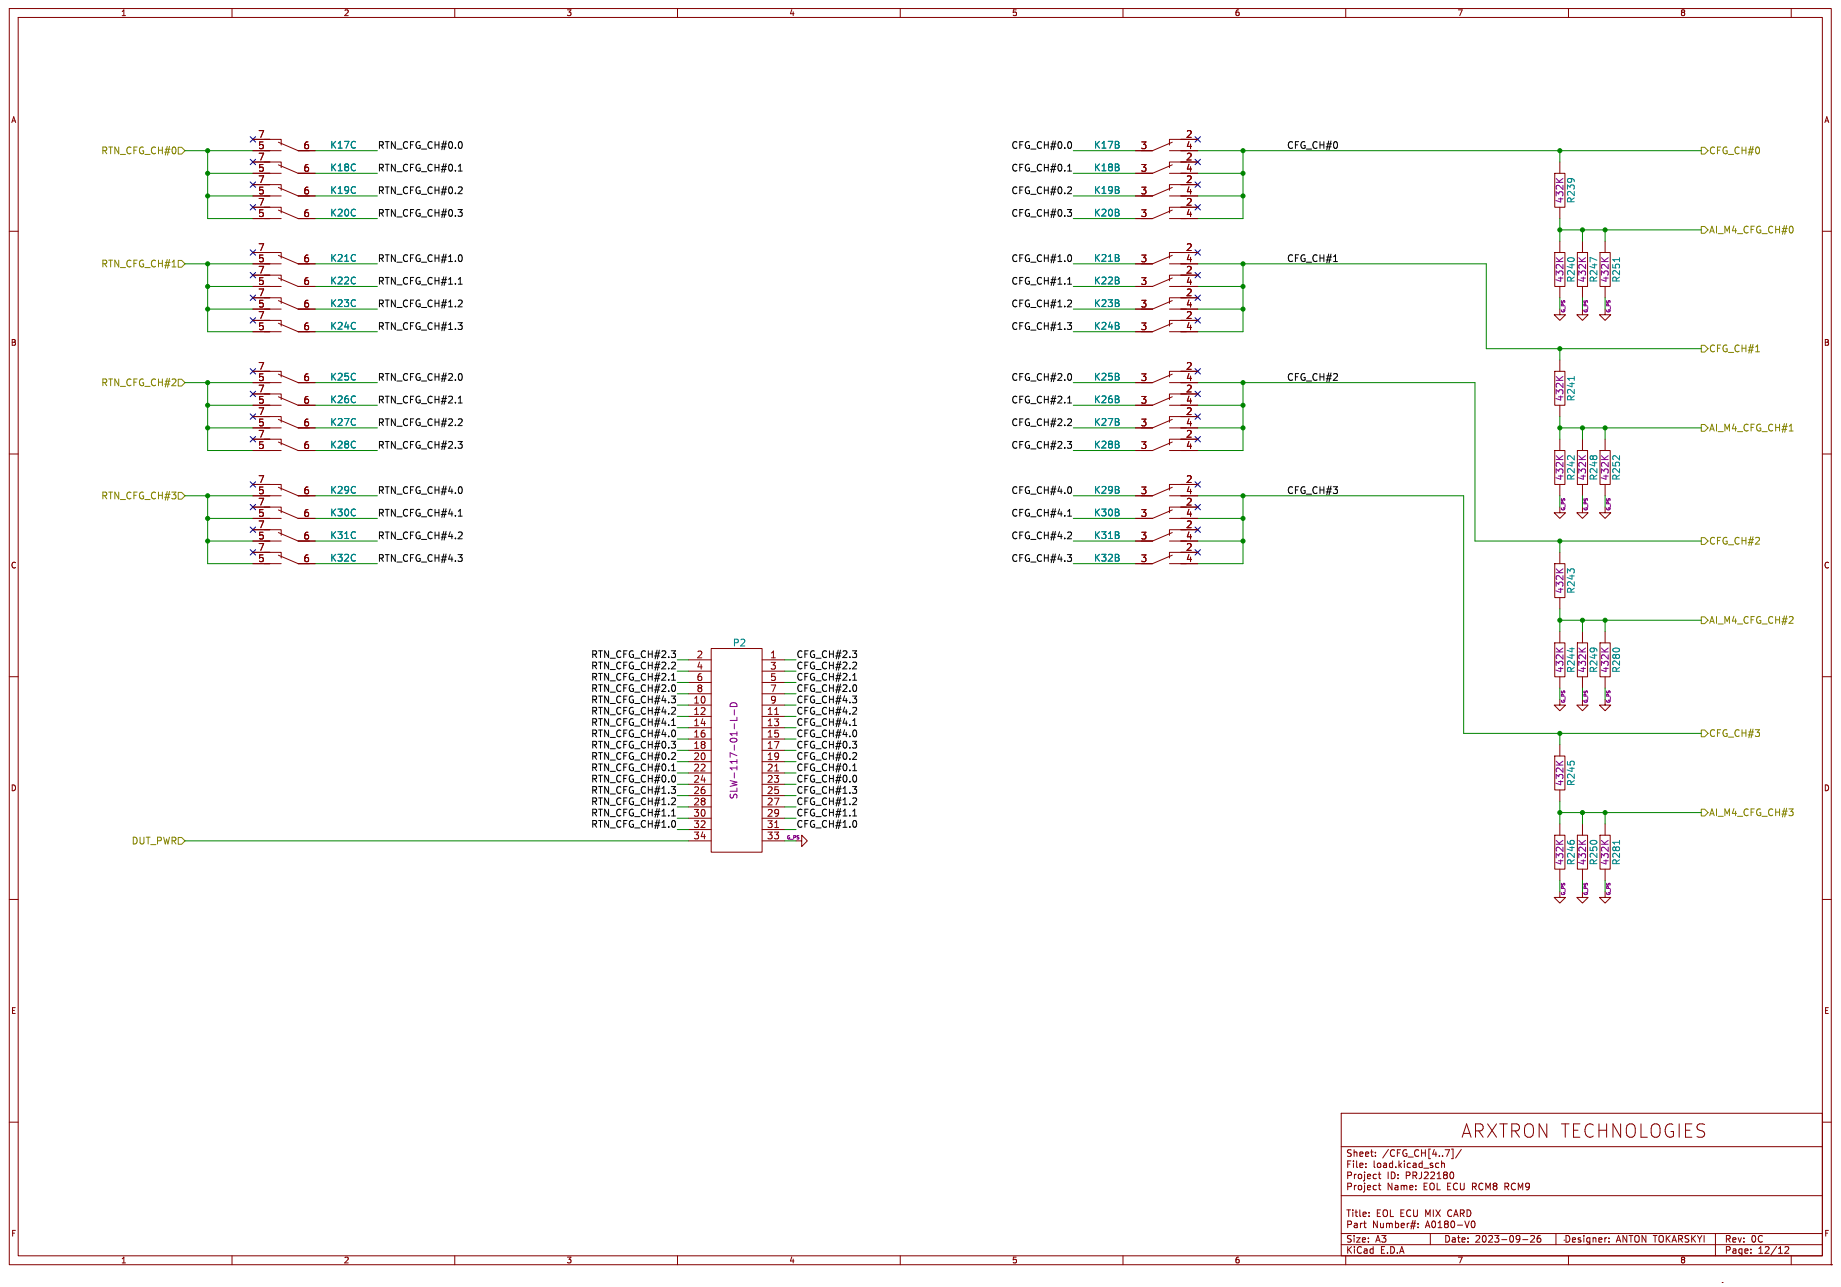
[picture p32: page 12]
