TokarskyiAnton/a0180_eol_ecu_mix/(commit log)

2023-06-08 sch and pcb
    [A0180_eol_ecu_mix.kicad_sch, ID.kicad_sch, can.kicad_sch, current_meas.kicad_sch, input.kicad_sch, load.kicad_sch, output.kicad_sch, output_n.kicad_sch]
2023-08-15 assembly updated - dnp led, they should be tight to 24v
    [A0180_eol_ecu_mix.kicad_sch, ID.kicad_sch, can.kicad_sch, current_meas.kicad_sch, input.kicad_sch, load.kicad_sch, output.kicad_sch, output_n.kicad_sch]
2023-09-27 - zero origin on so - silk - sch trig and rtsi lines need 510 resistor - assembly updated - sch and pcb project name and rev - no changes to gerber, old one can be used
    [A0180_eol_ecu_mix.kicad_sch, ID.kicad_sch, can.kicad_sch, current_meas.kicad_sch, input.kicad_sch, load.kicad_sch, output.kicad_sch, output_n.kicad_sch]
2023-10-17 pnp added
    [A0180_eol_ecu_mix.kicad_sch, ID.kicad_sch, can.kicad_sch, current_meas.kicad_sch, input.kicad_sch, load.kicad_sch, output.kicad_sch, output_n.kicad_sch]
2023-10-17 include pnp to staging
    [bottom_A0180_eol_ecu_mix_pos.csv, top_A0180_eol_ecu_mix_pos.csv]
2023-11-11 wip res
    [input.kicad_sch, top_A0180_eol_ecu_mix_pos_o.csv]
2023-11-12 dnp res for di pwr dnp led feed for 5v replace with 6.49k feed for ign_on on sim circuit
    [current_meas.kicad_sch, power.kicad_sch]
2023-11-12 assembly modified, not generated use with caution
    [top_A0180_eol_ecu_mix_pos_o.csv]
2024-08-29 clean up
    [A0180_eol_ecu_mix.kicad_sch, ID.kicad_sch, can.kicad_sch, current_meas.kicad_sch, input.kicad_sch, load.kicad_sch, output.kicad_sch, output_n.kicad_sch]
2025-04-30 kicad 9 - r11-check gerber before sending to manufacturing
    [A0180_eol_ecu_mix.kicad_sch, ID.kicad_sch, a0180_eol_ecu_mix-drl_map.dxf, can.kicad_sch, current_meas.kicad_sch, input.kicad_sch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]
2025-04-30 gitignore to include csv for pnp
    [bottom_pos_a0180_eol_ecu_mix.csv, top_pos_a0180_eol_ecu_mix.csv]
2026-02-06 r11a - clean up mostly with reports naming, values, footprints and parts
    [A0180_eol_ecu_mix.kicad_sch, ID.kicad_sch, a0180_eol_ecu_mix-B_Fab.dxf, a0180_eol_ecu_mix-drl_map.dxf, bottom_pos_a0180_eol_ecu_mix.csv, bottom_pos_a0180_eol_ecu_mix_R11A_V0_DEF.csv, can.kicad_sch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]
2026-02-07 drill layer updated
    [a0180_eol_ecu_mix-B_Fab.dxf, a0180_eol_ecu_mix-drl_map.dxf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]
2026-02-11 r11a released with gerbers - uln updated, leds updated - still dnp
    [A0180_eol_ecu_mix.kicad_sch, a0180_eol_ecu_mix-drl_map.dxf, output.kicad_sch, power.kicad_sch, top_pos_a0180_eol_ecu_mix_R11A_V0_DEF.csv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]
2026-02-20 r11a sch and gerbers released for fabrication, previous revis r11a is not used and can be ignored - added apfio support
    [A0180_eol_ecu_mix.kicad_sch, a0180_eol_ecu_mix-drl_map.dxf, power.kicad_sch, top_pos_a0180_eol_ecu_mix_R11A_V0_DEF.csv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]
2026-02-21 changes on trigger apfi input - revision is the same
    [A0180_eol_ecu_mix.kicad_sch, a0180_eol_ecu_mix-drl_map.dxf, top_pos_a0180_eol_ecu_mix_R11A_V0_DEF.csv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]
2026-03-05 update ignore to add csv from bom folder
    [A0180_EOL ECU MIX CARD_R11A_V0_DEF.csv]
