TokarskyiAnton/a0180_eol_ecu_mix/ID.kicad_sch

## KiCad design ID.kicad_sch (2026-02-06)

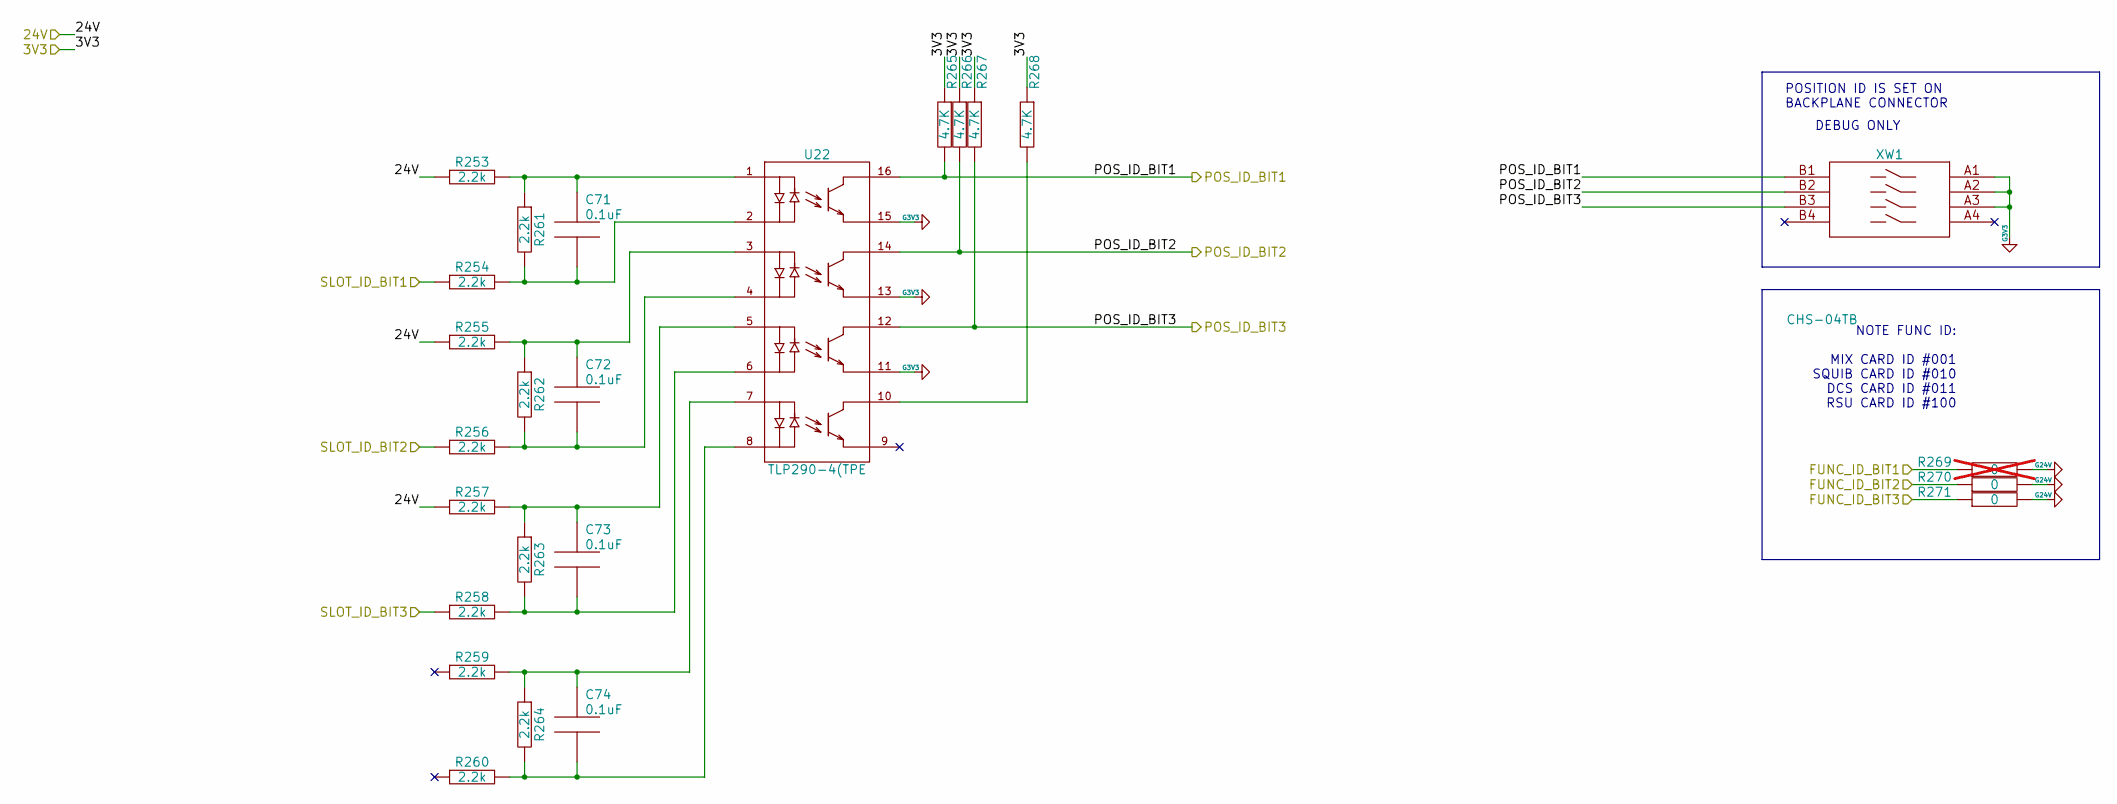
[picture p3: schematic ID.kicad_sch]

Parts:
C71, C72, C73, C74: 06035C104KAZ2A; CAPC1608X90N; Tolerance ±10%; Voltage 50V; ManufacturerPartNumber 06035C104KAZ2A
R253, R254, R255, R256, R257, R258, R259, R260, R261, R262, R263, R264: RC0603JR-072K2L; RESC1608X65N; Tolerance 5%; ManufacturerPartNumber RC0603JR-072K2L
R265, R266, R267, R268: RC0603FR-074K7L; RESC1608X65N; ManufacturerPartNumber RC0603FR-074K7L
R269: RC0603JR-070RL; RESC1608X65N; ManufacturerPartNumber RC0603JR-070RL; not fitted
R270, R271: RC0603JR-070RL; RESC1608X65N; ManufacturerPartNumber RC0603JR-070RL
U22: TLP290-4(TPE; SOIC127P700X220-16; ManufacturerPartNumber TLP290-4(TPE
XW1: CHS-04TB; COPAL_CHS-04TB; ManufacturerPartNumber CHS-04TB

Connections:
3V3: R265.1, R266.1, R267.1, R268.1
24V: R253.1, R255.1, R257.1
FUNC_ID_BIT1: R269.1
FUNC_ID_BIT2: R270.1
FUNC_ID_BIT3: R271.1
GND_3V3: U22.11, U22.13, U22.15, XW1.A1, XW1.A2, XW1.A3
GND_24V: R269.2, R270.2, R271.2
unnamed: C71.1, R253.2, R261.1, U22.1
unnamed: C71.2, R254.2, R261.2, U22.2
unnamed: C72.1, R255.2, R262.1, U22.3
unnamed: C72.2, R256.2, R262.2, U22.4
unnamed: C73.1, R257.2, R263.1, U22.5
unnamed: C73.2, R258.2, R263.2, U22.6
unnamed: C74.1, R259.2, R264.1, U22.7
unnamed: C74.2, R260.2, R264.2, U22.8
unnamed: R268.2, U22.10
POS_ID_BIT1: R265.2, U22.16, XW1.B1
POS_ID_BIT2: R266.2, U22.14, XW1.B2
POS_ID_BIT3: R267.2, U22.12, XW1.B3
SLOT_ID_BIT1: R254.1
SLOT_ID_BIT2: R256.1
SLOT_ID_BIT3: R258.1

Notes on the sheet:
DEBUG ONLY
NOTE FUNC ID: MIX CARD ID #001 SQUIB CARD ID #010 DCS CARD ID #011 RSU CARD ID #100
POSITION ID IS SET ON BACKPLANE CONNECTOR
