TokarskyiAnton/a0180_eol_ecu_mix/can.kicad_sch

## KiCad design can.kicad_sch (2026-02-06)

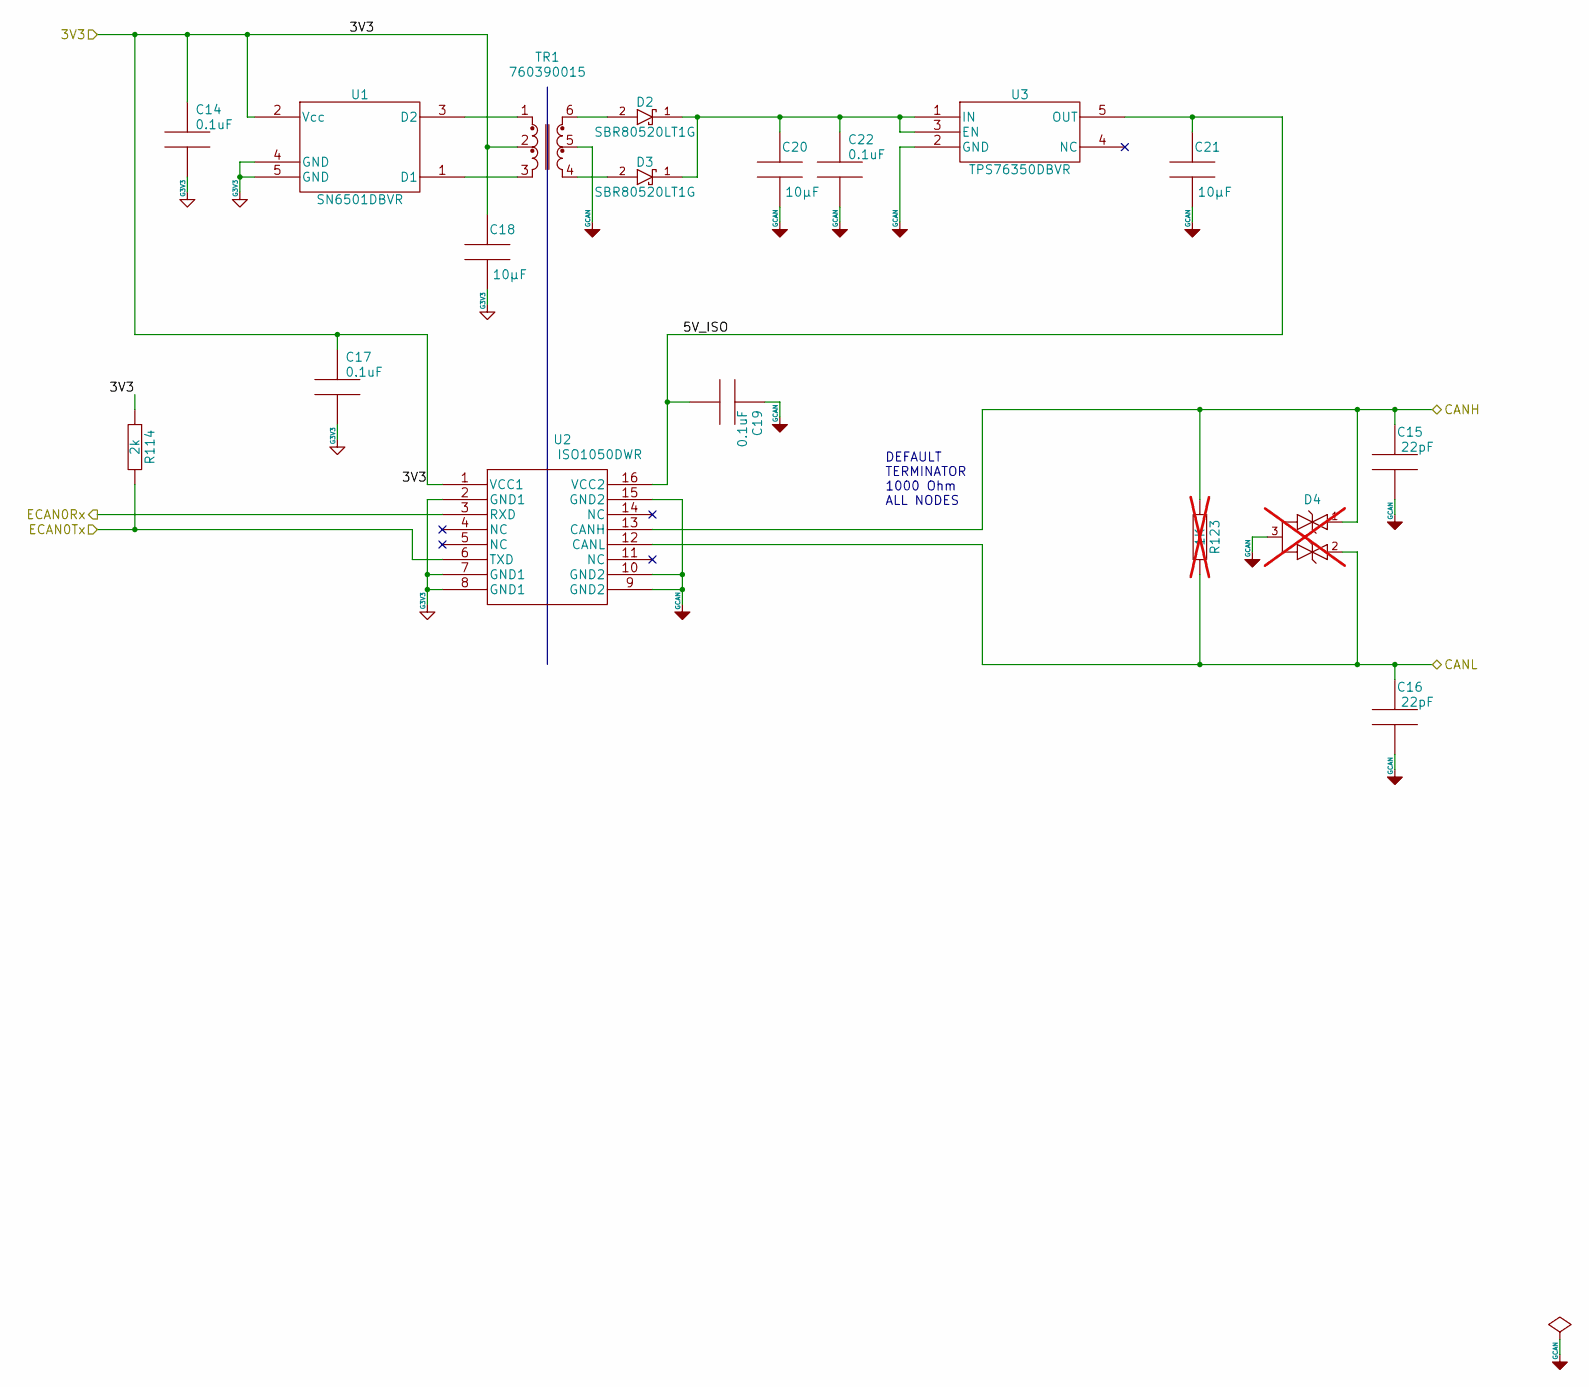
[picture p4: schematic can.kicad_sch]

Parts:
C14, C17, C19, C22: 06035C104KAZ2A; CAPC1608X90N; Tolerance ±10%; Voltage 50V; ManufacturerPartNumber 06035C104KAZ2A
C15, C16: 08055A220JAT2A; CAPC1608X90N; ManufacturerPartNumber 08055A220JAT2A
C18, C20, C21: 12103C106KAT2A; CAPC3225X94N; Tolerance 10%; Voltage 25V; ManufacturerPartNumber 12103C106KAT2A
D2, D3: SBR80520LT1G; SOD3716X118; ManufacturerPartNumber SBR80520LT1G
D4: ESDCAN05-2BWY; SOT65P210X110-3; ManufacturerPartNumber ESDCAN05-2BWY; not fitted
R114: RC0805FR-072KL; RESC2012X65N; Tolerance 1%; ManufacturerPartNumber RC0805FR-072KL
R123: RC0603FR-071KL; RESC1608X65N; ManufacturerPartNumber RC0603FR-071KL; not fitted
TR1: 760390015; WURTH_760390015; ManufacturerPartNumber 760390015
U1: SN6501DBVR; SOT95P280X145-5N; ManufacturerPartNumber SN6501DBVR
U2: ISO1050DWR; SOIC127P1030X265-16; ManufacturerPartNumber ISO1050DWR
U3: TPS76350DBVR; SOT95P280X145-5N; ManufacturerPartNumber TPS76350DBVR

Connections:
3V3: C14.1, C17.1, C18.1, R114.1, TR1.2, U1.2 (Vcc), U2.1 (VCC1)
5V_ISO: C19.2, C21.1, U2.16 (VCC2), U3.5 (OUT)
CANH: C15.1, D4.1, R123.1, U2.13 (CANH)
CANL: C16.1, D4.2, R123.2, U2.12 (CANL)
ECAN0Rx: U2.3 (RXD)
ECAN0Tx: R114.2, U2.6 (TXD)
GND_3V3: C14.2, C17.2, C18.2, U1.4 (GND), U1.5 (GND), U2.2 (GND1), U2.7 (GND1), U2.8 (GND1)
GND_CAN: C15.2, C16.2, C19.1, C20.2, C21.2, C22.2, D4.3, TR1.5, U2.9 (GND2), U2.10 (GND2), U2.15 (GND2), U3.2 (GND)
unnamed: C20.1, C22.1, D2.1 (K), D3.1 (K), U3.1 (IN), U3.3 (EN)
unnamed: D2.2 (A), TR1.6
unnamed: D3.2 (A), TR1.4
unnamed: TR1.1, U1.3 (D2)
unnamed: TR1.3, U1.1 (D1)

Notes on the sheet:
DEFAULT TERMINATOR 1000 Ohm ALL NODES
