TokarskyiAnton/a0180_eol_ecu_mix/current_meas.kicad_sch

## KiCad design current_meas.kicad_sch (2026-02-06)

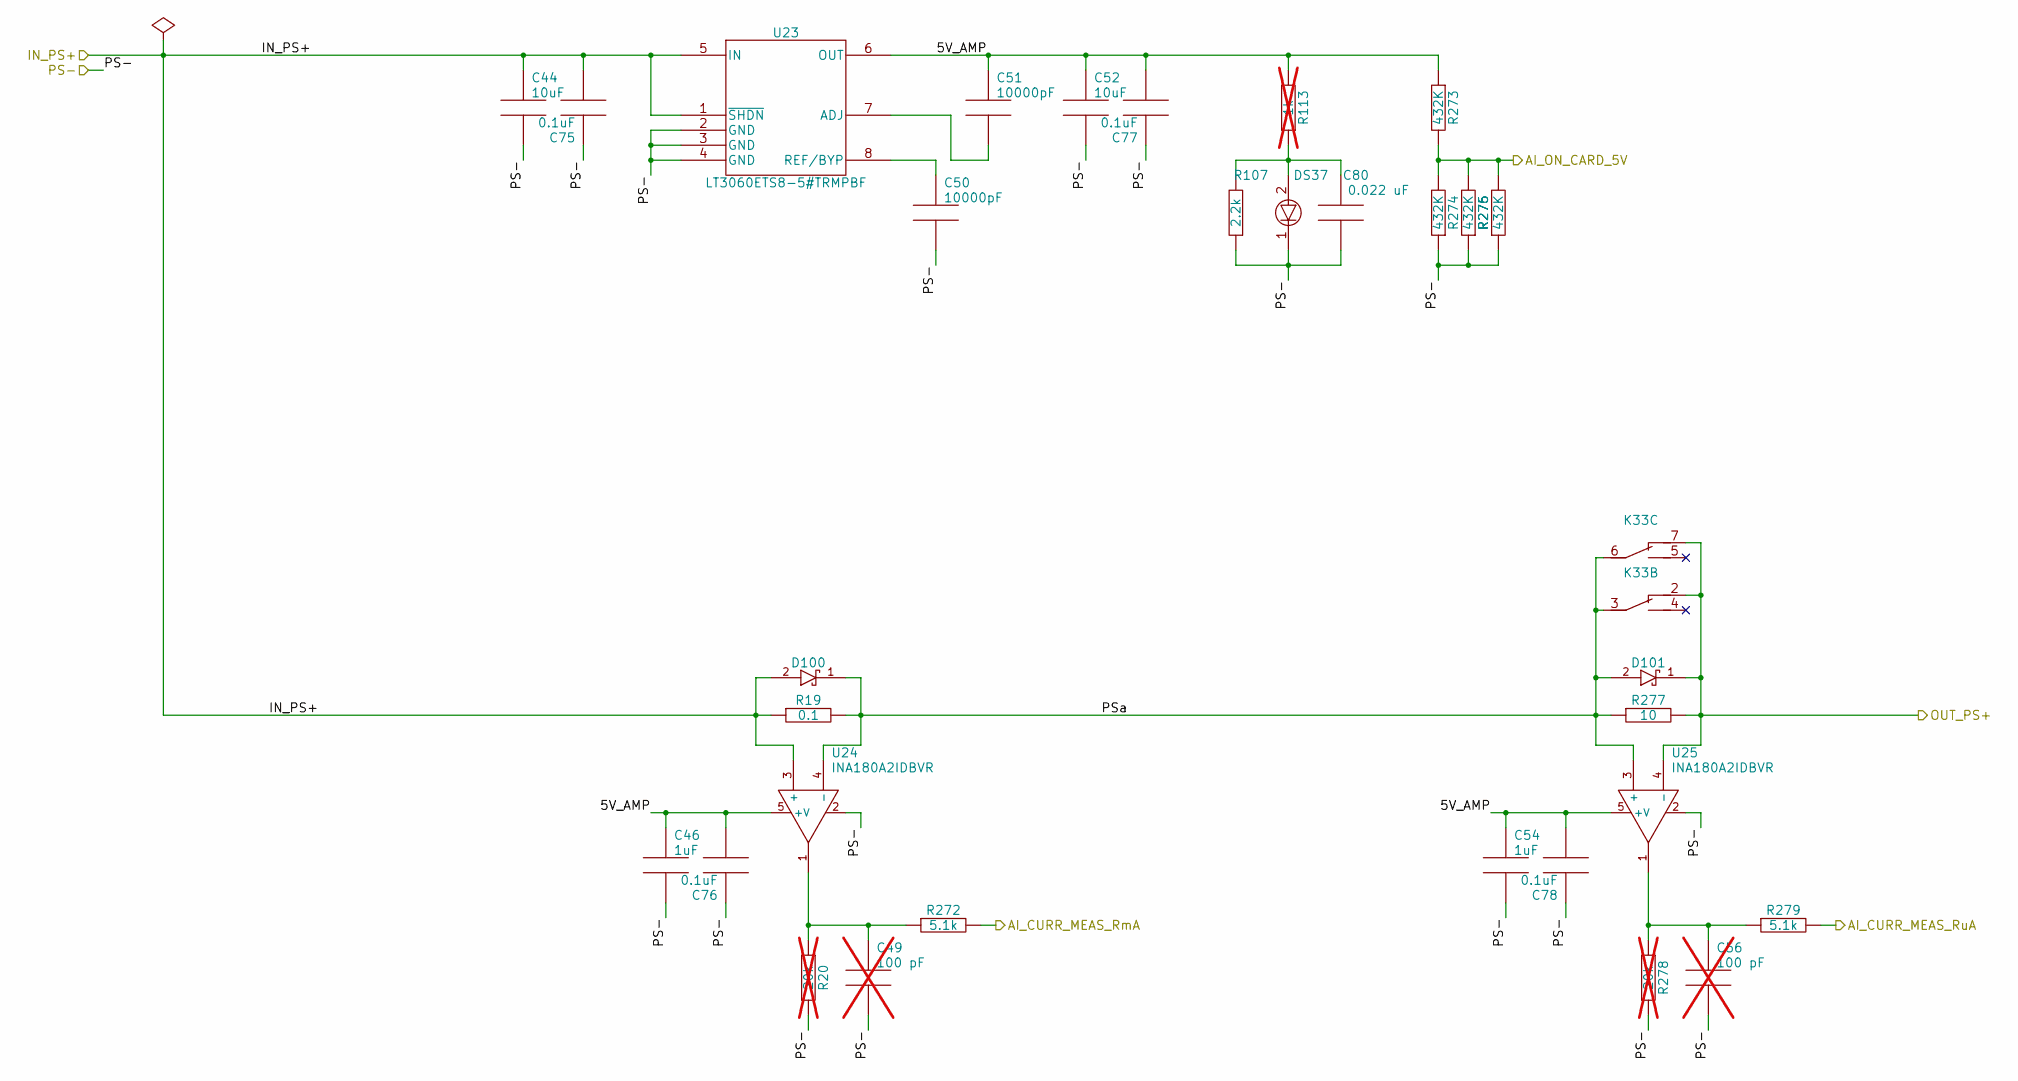
[picture p5: schematic current_meas.kicad_sch]

Parts:
C44, C52: CL32B106KBJNNWE; CAPC3225X280N; Tolerance 20%; Voltage 50V; ManufacturerPartNumber CL32B106KBJNNNE
C46, C54: 08055C105KAT2A; CAPC2012X94; Tolerance 10%; Voltage 50V; ManufacturerPartNumber 08055C105KAT2A
C49, C56: C0805C101K5RACTU; CAPC2012X120N; Tolerance 10%; Voltage 50V; ManufacturerPartNumber C0805C101K5RACTU; not fitted
C50, C51: GRM2195C1H103FA01D; CAPC2012X135N; Tolerance 1%; Voltage 50V; ManufacturerPartNumber GRM2195C1H103FA01D
C75, C76, C77, C78: 06035C104KAZ2A; CAPC1608X90N; Tolerance ±10%; Voltage 50V; ManufacturerPartNumber 06035C104KAZ2A
C80: CGA4J2NP01H223J125AA; CAPC2012X145N; ManufacturerPartNumber CGA4J2NP01H223J125AA
D100, D101: STPS2H100ZFY; SODFL3516X110; ManufacturerPartNumber STPS2H100ZFY
DS37: LTST-C171KGKT; LEDC2012X120N; Voltage 2V; ManufacturerPartNumber LTST-C171KGKT
K33: G6K-2G-Y-TR_DC24_DPDT; OMRON_G6K-2G-Y; ManufacturerPartNumber G6K-2G-Y-TR DC24
R19: WSL2512R1000FEA; RESC6331X88; Tolerance 1%; ManufacturerPartNumber WSL2512R1000FEA
R20, R278: RC0805FR-0720KL; RESC2012X65N; Tolerance 1%; ManufacturerPartNumber RC0805FR-0720KL; not fitted
R107: RC0603JR-072K2L; RESC1608X65N; Tolerance 5%; ManufacturerPartNumber RC0603JR-072K2L
R113: RC1206FR-071KL; RESC3116X65N; ManufacturerPartNumber RC1206FR-071KL; not fitted
R272, R279: RC0805FR-075K1L; RESC2012X65N; Tolerance 1%; ManufacturerPartNumber RC0805FR-075K1L
R273, R274, R275, R276: RT0603BRD07432KL; RESC1608X65N; ManufacturerPartNumber RT0603BRD07432KL
R277: CRCW251210R0FKEG; RESC6331X50; Tolerance 1%; ManufacturerPartNumber CRCW251210R0FKEG
U23: LT3060ETS8-5#TRMPBF; SOT65P280X100-8; ManufacturerPartNumber LT3060ETS8-5#TRMPBF
U24, U25: INA180A2IDBVR; SOT95P280X145-5N; ManufacturerPartNumber INA180A2IDBVR

Connections:
5V_AMP: C46.2, C51.2, C52.1, C54.2, C76.2, C77.2, C78.2, R113.2, R273.1, U23.6 (OUT), U24.5 (+V), U25.5 (+V)
AI_CURR_MEAS_RmA: R272.2
AI_CURR_MEAS_RuA: R279.2
AI_ON_CARD_5V: R273.2, R274.2, R275.2, R276.2
IN_PS+: C44.1, C75.2, D100.2 (A), R19.1, U23.1 (~SHDN), U23.5 (IN), U24.3 (+)
unnamed: C49.2, R20.1, R272.1, U24.1
unnamed: C50.2, U23.8 (REF/BYP)
unnamed: C51.1, U23.7 (ADJ)
unnamed: C56.2, R278.1, R279.1, U25.1
unnamed: C80.2, DS37.2 (-), R107.2, R113.1
OUT_PS+: D101.1 (K), K33.2, K33.7, R277.2, U25.4 (-)
PS-: C44.2, C46.1, C49.1, C50.1, C52.2, C54.1, C56.1, C75.1, C76.1, C77.1, C78.1, C80.1, DS37.1 (+), R20.2, R107.1, R274.1, R275.1, R276.1, R278.2, U23.2 (GND), U23.3 (GND), U23.4 (GND), U24.2, U25.2
PSa: D100.1 (K), D101.2 (A), K33.3, K33.6, R19.2, R277.1, U24.4 (-), U25.3 (+)
