TokarskyiAnton/a0180_eol_ecu_mix/input.kicad_sch

## KiCad design input.kicad_sch (2026-02-06)

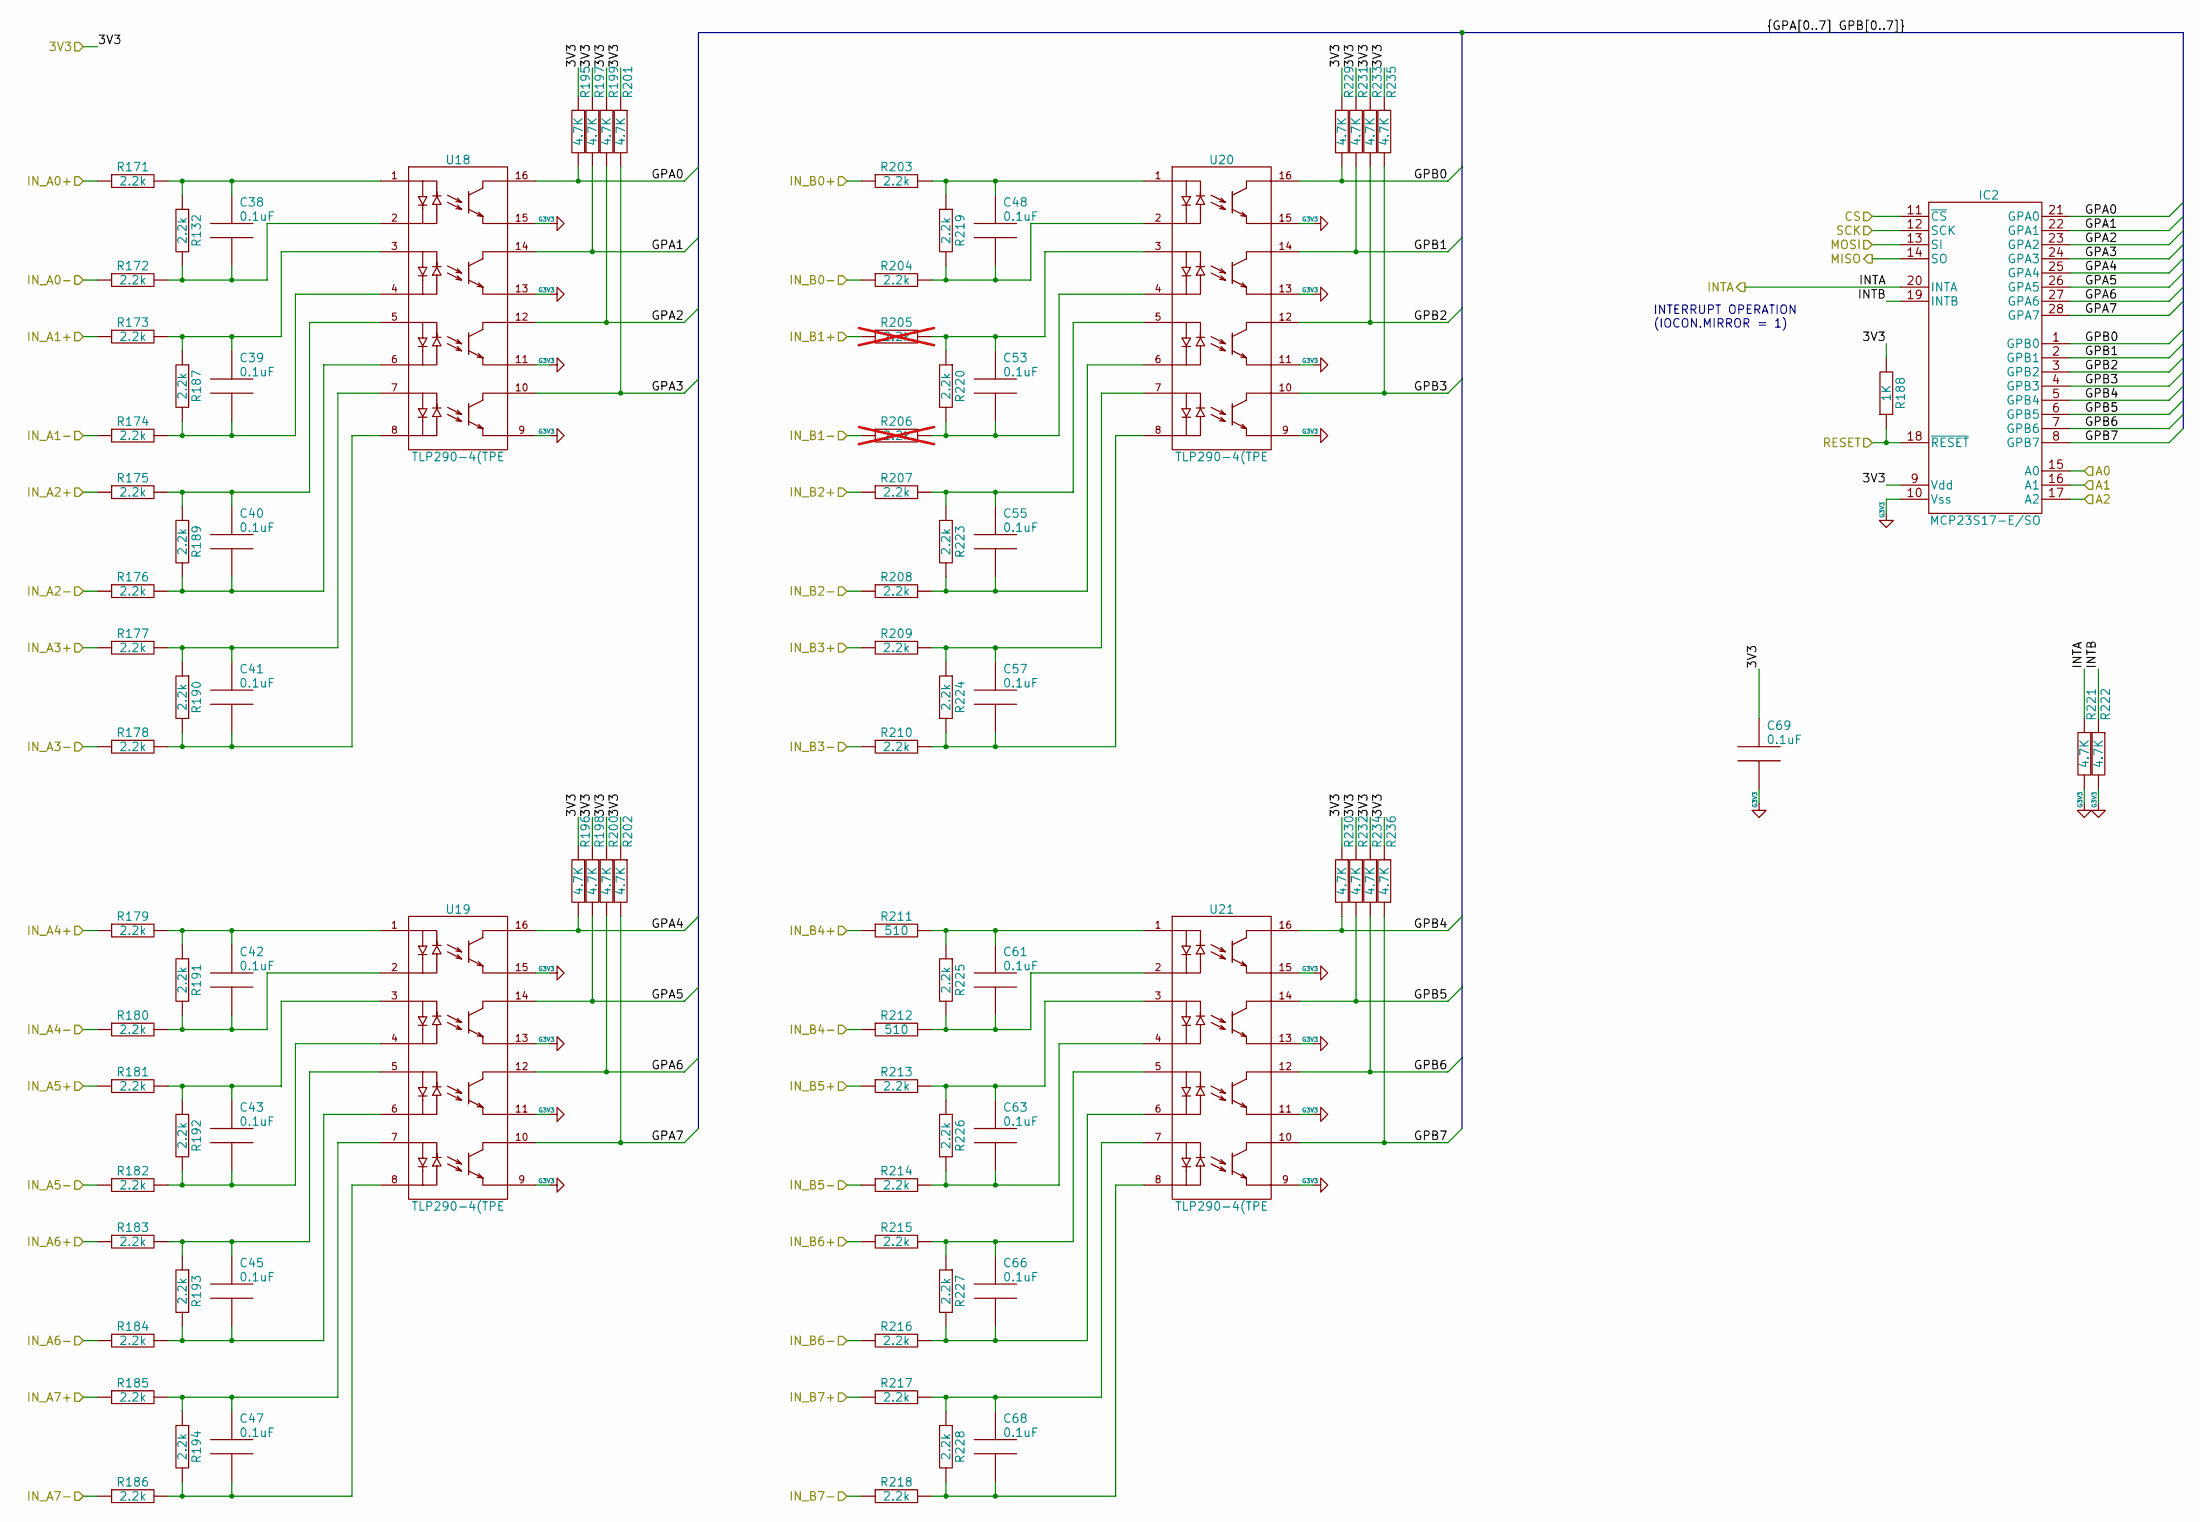
[picture p6: schematic input.kicad_sch]

Parts:
C38, C39, C40, C41, C42, C43, C45, C47, C48, C53, C55, C57, C61, C63, C66, C68, C69: 06035C104KAZ2A; CAPC1608X90N; Tolerance ±10%; Voltage 50V; ManufacturerPartNumber 06035C104KAZ2A
IC2: MCP23S17_E_SO; SOIC28P127_1786X1034X264L83X43N; ManufacturerPartNumber MCP23S17-E/SO
R132, R171, R172, R173, R174, R175, R176, R177, R178, R179, R180, R181, R182, R183, R184, R185, R186, R187, R189, R190, R191, R192, R193, R194, R203, R204, R207, R208, R209, R210, R213, R214, R215, R216, R217, R218, R219, R220, R223, R224, R225, R226, R227, R228: RC0603JR-072K2L; RESC1608X65N; Tolerance 5%; ManufacturerPartNumber RC0603JR-072K2L
R188: RC0603FR-071KL; RESC1608X65N; ManufacturerPartNumber RC0603FR-071KL
R195, R196, R197, R198, R199, R200, R201, R202, R221, R222, R229, R230, R231, R232, R233, R234, R235, R236: RC0603FR-074K7L; RESC1608X65N; ManufacturerPartNumber RC0603FR-074K7L
R205, R206: RC0603JR-072K2L; RESC1608X65N; Tolerance 5%; ManufacturerPartNumber RC0603JR-072K2L; not fitted
R211, R212: RC0603FR-07510RL; RESC1608X65N; ManufacturerPartNumber RC0603FR-07510RL
U18, U19, U20, U21: TLP290-4(TPE; SOIC127P700X220-16; ManufacturerPartNumber TLP290-4(TPE

Connections:
3V3: C69.1, IC2.9 (Vdd), R188.2, R195.1, R196.1, R197.1, R198.1, R199.1, R200.1, R201.1, R202.1, R229.1, R230.1, R231.1, R232.1, R233.1, R234.1, R235.1, R236.1
A0: IC2.15 (A0)
A1: IC2.16 (A1)
A2: IC2.17 (A2)
CS: IC2.11 (~CS)
GND_3V3: C69.2, IC2.10 (Vss), R221.2, R222.2, U18.9, U18.11, U18.13, U18.15, U19.9, U19.11, U19.13, U19.15, U20.9, U20.11, U20.13, U20.15, U21.9, U21.11, U21.13, U21.15
GPA0: IC2.21 (GPA0), R195.2, U18.16
GPA1: IC2.22 (GPA1), R197.2, U18.14
GPA2: IC2.23 (GPA2), R199.2, U18.12
GPA3: IC2.24 (GPA3), R201.2, U18.10
GPA4: IC2.25 (GPA4), R196.2, U19.16
GPA5: IC2.26 (GPA5), R198.2, U19.14
GPA6: IC2.27 (GPA6), R200.2, U19.12
GPA7: IC2.28 (GPA7), R202.2, U19.10
GPB0: IC2.1 (GPB0), R229.2, U20.16
GPB1: IC2.2 (GPB1), R231.2, U20.14
GPB2: IC2.3 (GPB2), R233.2, U20.12
GPB3: IC2.4 (GPB3), R235.2, U20.10
GPB4: IC2.5 (GPB4), R230.2, U21.16
GPB5: IC2.6 (GPB5), R232.2, U21.14
GPB6: IC2.7 (GPB6), R234.2, U21.12
GPB7: IC2.8 (GPB7), R236.2, U21.10
INTA: IC2.20 (INTA), R221.1
INTB: IC2.19 (INTB), R222.1
IN_A0+: R171.1
IN_A0-: R172.1
IN_A1+: R173.1
IN_A1-: R174.1
IN_A2+: R175.1
IN_A2-: R176.1
IN_A3+: R177.1
IN_A3-: R178.1
IN_A4+: R179.1
IN_A4-: R180.1
IN_A5+: R181.1
IN_A5-: R182.1
IN_A6+: R183.1
IN_A6-: R184.1
IN_A7+: R185.1
IN_A7-: R186.1
IN_B0+: R203.1
IN_B0-: R204.1
IN_B1+: R205.1
IN_B1-: R206.1
IN_B2+: R207.1
IN_B2-: R208.1
IN_B3+: R209.1
IN_B3-: R210.1
IN_B4+: R211.1
IN_B4-: R212.1
IN_B5+: R213.1
IN_B5-: R214.1
IN_B6+: R215.1
IN_B6-: R216.1
IN_B7+: R217.1
IN_B7-: R218.1
MISO: IC2.14 (SO)
MOSI: IC2.13 (SI)
unnamed: C38.1, R132.1, R171.2, U18.1
unnamed: C38.2, R132.2, R172.2, U18.2
unnamed: C39.1, R173.2, R187.1, U18.3
unnamed: C39.2, R174.2, R187.2, U18.4
unnamed: C40.1, R175.2, R189.1, U18.5
unnamed: C40.2, R176.2, R189.2, U18.6
unnamed: C41.1, R177.2, R190.1, U18.7
unnamed: C41.2, R178.2, R190.2, U18.8
unnamed: C42.1, R179.2, R191.1, U19.1
unnamed: C42.2, R180.2, R191.2, U19.2
unnamed: C43.1, R181.2, R192.1, U19.3
unnamed: C43.2, R182.2, R192.2, U19.4
unnamed: C45.1, R183.2, R193.1, U19.5
unnamed: C45.2, R184.2, R193.2, U19.6
unnamed: C47.1, R185.2, R194.1, U19.7
unnamed: C47.2, R186.2, R194.2, U19.8
unnamed: C48.1, R203.2, R219.1, U20.1
unnamed: C48.2, R204.2, R219.2, U20.2
unnamed: C53.1, R205.2, R220.1, U20.3
unnamed: C53.2, R206.2, R220.2, U20.4
unnamed: C55.1, R207.2, R223.1, U20.5
unnamed: C55.2, R208.2, R223.2, U20.6
unnamed: C57.1, R209.2, R224.1, U20.7
unnamed: C57.2, R210.2, R224.2, U20.8
unnamed: C61.1, R211.2, R225.1, U21.1
unnamed: C61.2, R212.2, R225.2, U21.2
unnamed: C63.1, R213.2, R226.1, U21.3
unnamed: C63.2, R214.2, R226.2, U21.4
unnamed: C66.1, R215.2, R227.1, U21.5
unnamed: C66.2, R216.2, R227.2, U21.6
unnamed: C68.1, R217.2, R228.1, U21.7
unnamed: C68.2, R218.2, R228.2, U21.8
RESET: IC2.18 (~RESET), R188.1
SCK: IC2.12 (SCK)

Notes on the sheet:
INTERRUPT OPERATION (IOCON.MIRROR = 1)
