TokarskyiAnton/a0180_eol_ecu_mix/load.kicad_sch

## KiCad design load.kicad_sch (2026-02-06)

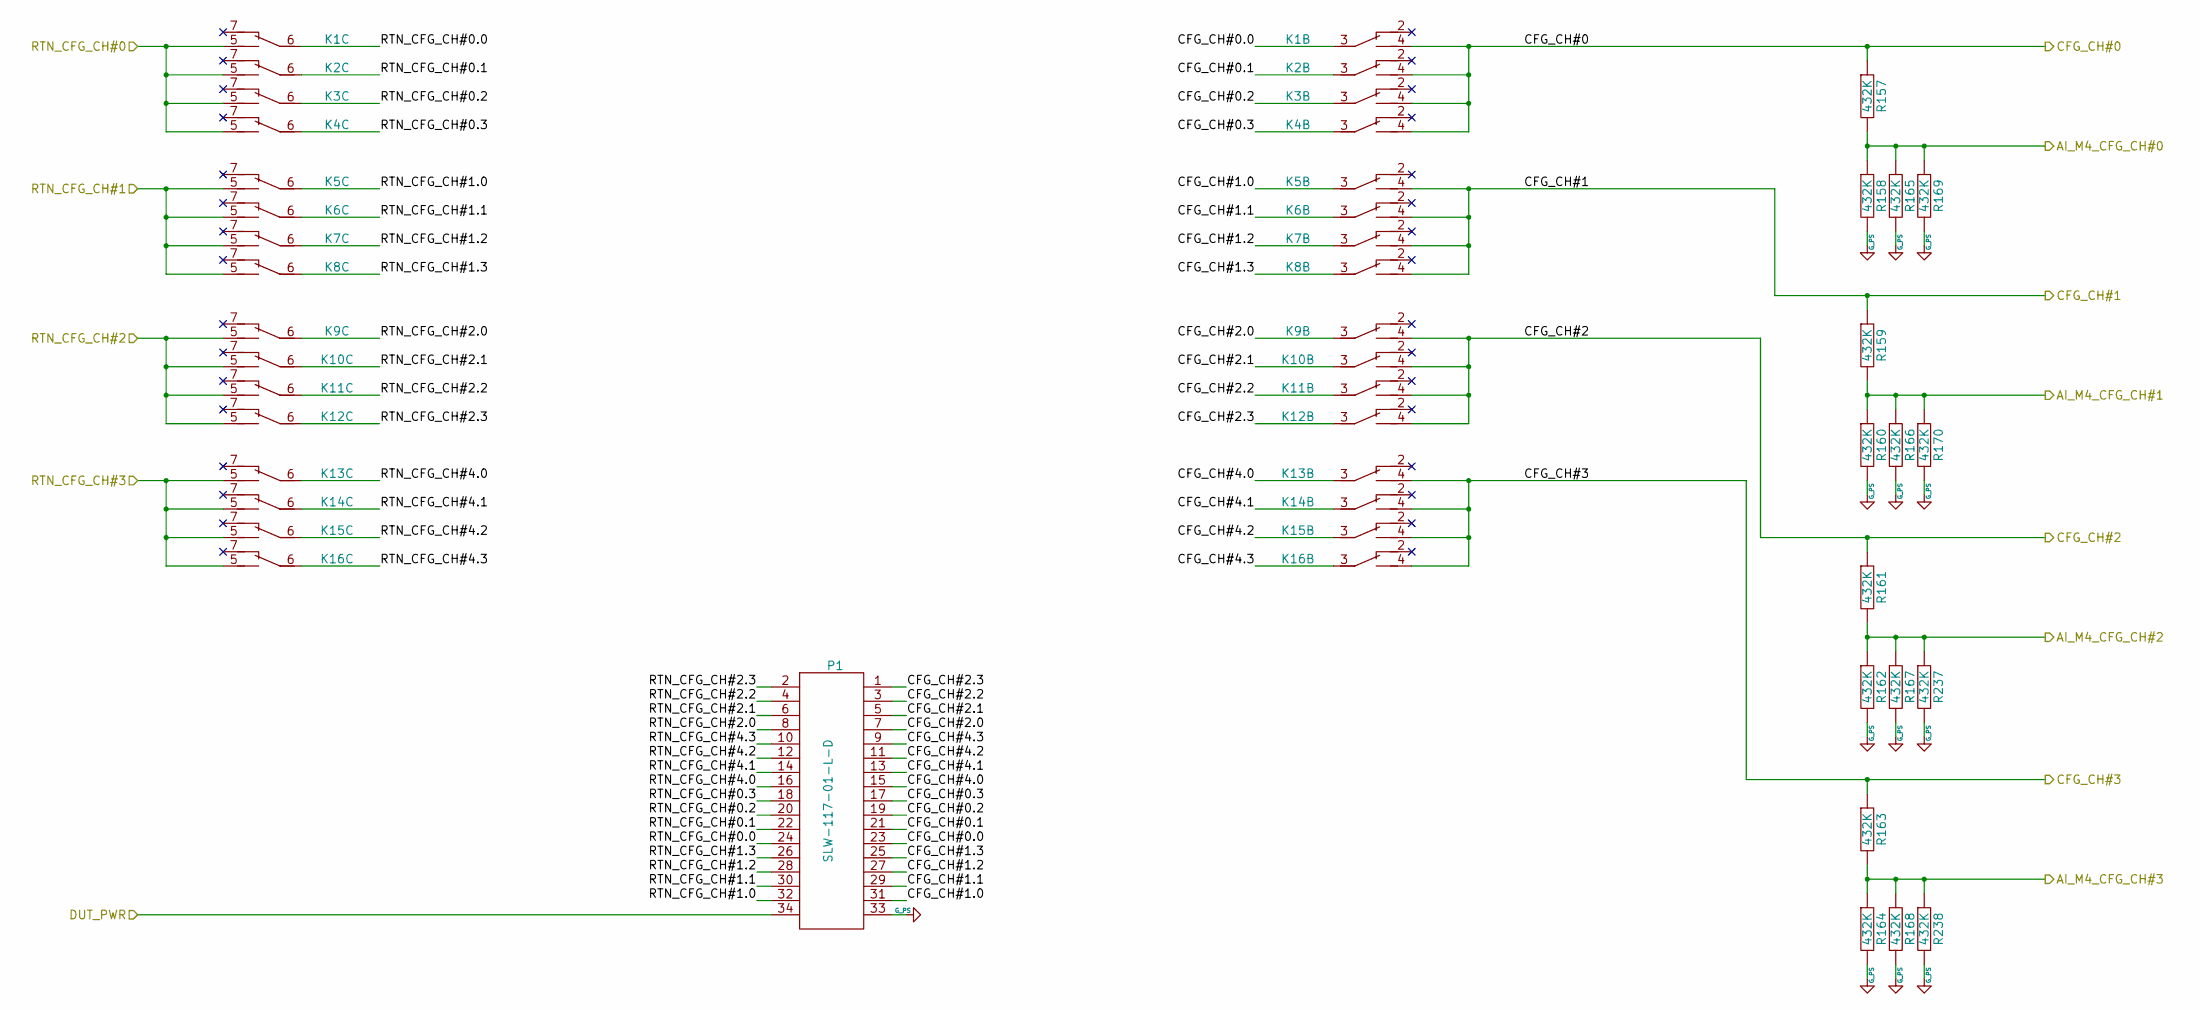
[picture p7: schematic load.kicad_sch]

Parts:
K1, K2, K3, K4, K5, K6, K7, K8, K9, K10, K11, K12, K13, K14, K15, K16: G6K-2G-Y-TR_DC24_DPDT; OMRON_G6K-2G-Y; ManufacturerPartNumber G6K-2G-Y-TR DC24
P1: SLW-117-01-L-D_VAR1; SAMTEC_SLW-117-01-X-D; ManufacturerPartNumber SLW-117-01-L-D
R157, R158, R159, R160, R161, R162, R163, R164, R165, R166, R167, R168, R169, R170, R237, R238: RT0603BRD07432KL; RESC1608X65N; ManufacturerPartNumber RT0603BRD07432KL

Connections:
AI_M4_CFG_CH#0: R157.2, R158.1, R165.1, R169.1
AI_M4_CFG_CH#1: R159.2, R160.1, R166.1, R170.1
AI_M4_CFG_CH#2: R161.2, R162.1, R167.1, R237.1
AI_M4_CFG_CH#3: R163.2, R164.1, R168.1, R238.1
CFG_CH#0: K1.4, K2.4, K3.4, K4.4, R157.1
CFG_CH#0.0: K1.3, P1.23
CFG_CH#0.1: K2.3, P1.21
CFG_CH#0.2: K3.3, P1.19
CFG_CH#0.3: K4.3, P1.17
CFG_CH#1: K5.4, K6.4, K7.4, K8.4, R159.1
CFG_CH#1.0: K5.3, P1.31
CFG_CH#1.1: K6.3, P1.29
CFG_CH#1.2: K7.3, P1.27
CFG_CH#1.3: K8.3, P1.25
CFG_CH#2: K9.4, K10.4, K11.4, K12.4, R161.1
CFG_CH#2.0: K9.3, P1.7
CFG_CH#2.1: K10.3, P1.5
CFG_CH#2.2: K11.3, P1.3
CFG_CH#2.3: K12.3, P1.1
CFG_CH#3: K13.4, K14.4, K15.4, K16.4, R163.1
CFG_CH#4.0: K13.3, P1.15
CFG_CH#4.1: K14.3, P1.13
CFG_CH#4.2: K15.3, P1.11
CFG_CH#4.3: K16.3, P1.9
DUT_PWR: P1.34
GND_PS: P1.33, R158.2, R160.2, R162.2, R164.2, R165.2, R166.2, R167.2, R168.2, R169.2, R170.2, R237.2, R238.2
RTN_CFG_CH#0: K1.5, K2.5, K3.5, K4.5
RTN_CFG_CH#0.0: K1.6, P1.24
RTN_CFG_CH#0.1: K2.6, P1.22
RTN_CFG_CH#0.2: K3.6, P1.20
RTN_CFG_CH#0.3: K4.6, P1.18
RTN_CFG_CH#1: K5.5, K6.5, K7.5, K8.5
RTN_CFG_CH#1.0: K5.6, P1.32
RTN_CFG_CH#1.1: K6.6, P1.30
RTN_CFG_CH#1.2: K7.6, P1.28
RTN_CFG_CH#1.3: K8.6, P1.26
RTN_CFG_CH#2: K9.5, K10.5, K11.5, K12.5
RTN_CFG_CH#2.0: K9.6, P1.8
RTN_CFG_CH#2.1: K10.6, P1.6
RTN_CFG_CH#2.2: K11.6, P1.4
RTN_CFG_CH#2.3: K12.6, P1.2
RTN_CFG_CH#3: K13.5, K14.5, K15.5, K16.5
RTN_CFG_CH#4.0: K13.6, P1.16
RTN_CFG_CH#4.1: K14.6, P1.14
RTN_CFG_CH#4.2: K15.6, P1.12
RTN_CFG_CH#4.3: K16.6, P1.10
