TokarskyiAnton/a0180_eol_ecu_mix/output.kicad_sch

## KiCad design output.kicad_sch (2026-02-11)

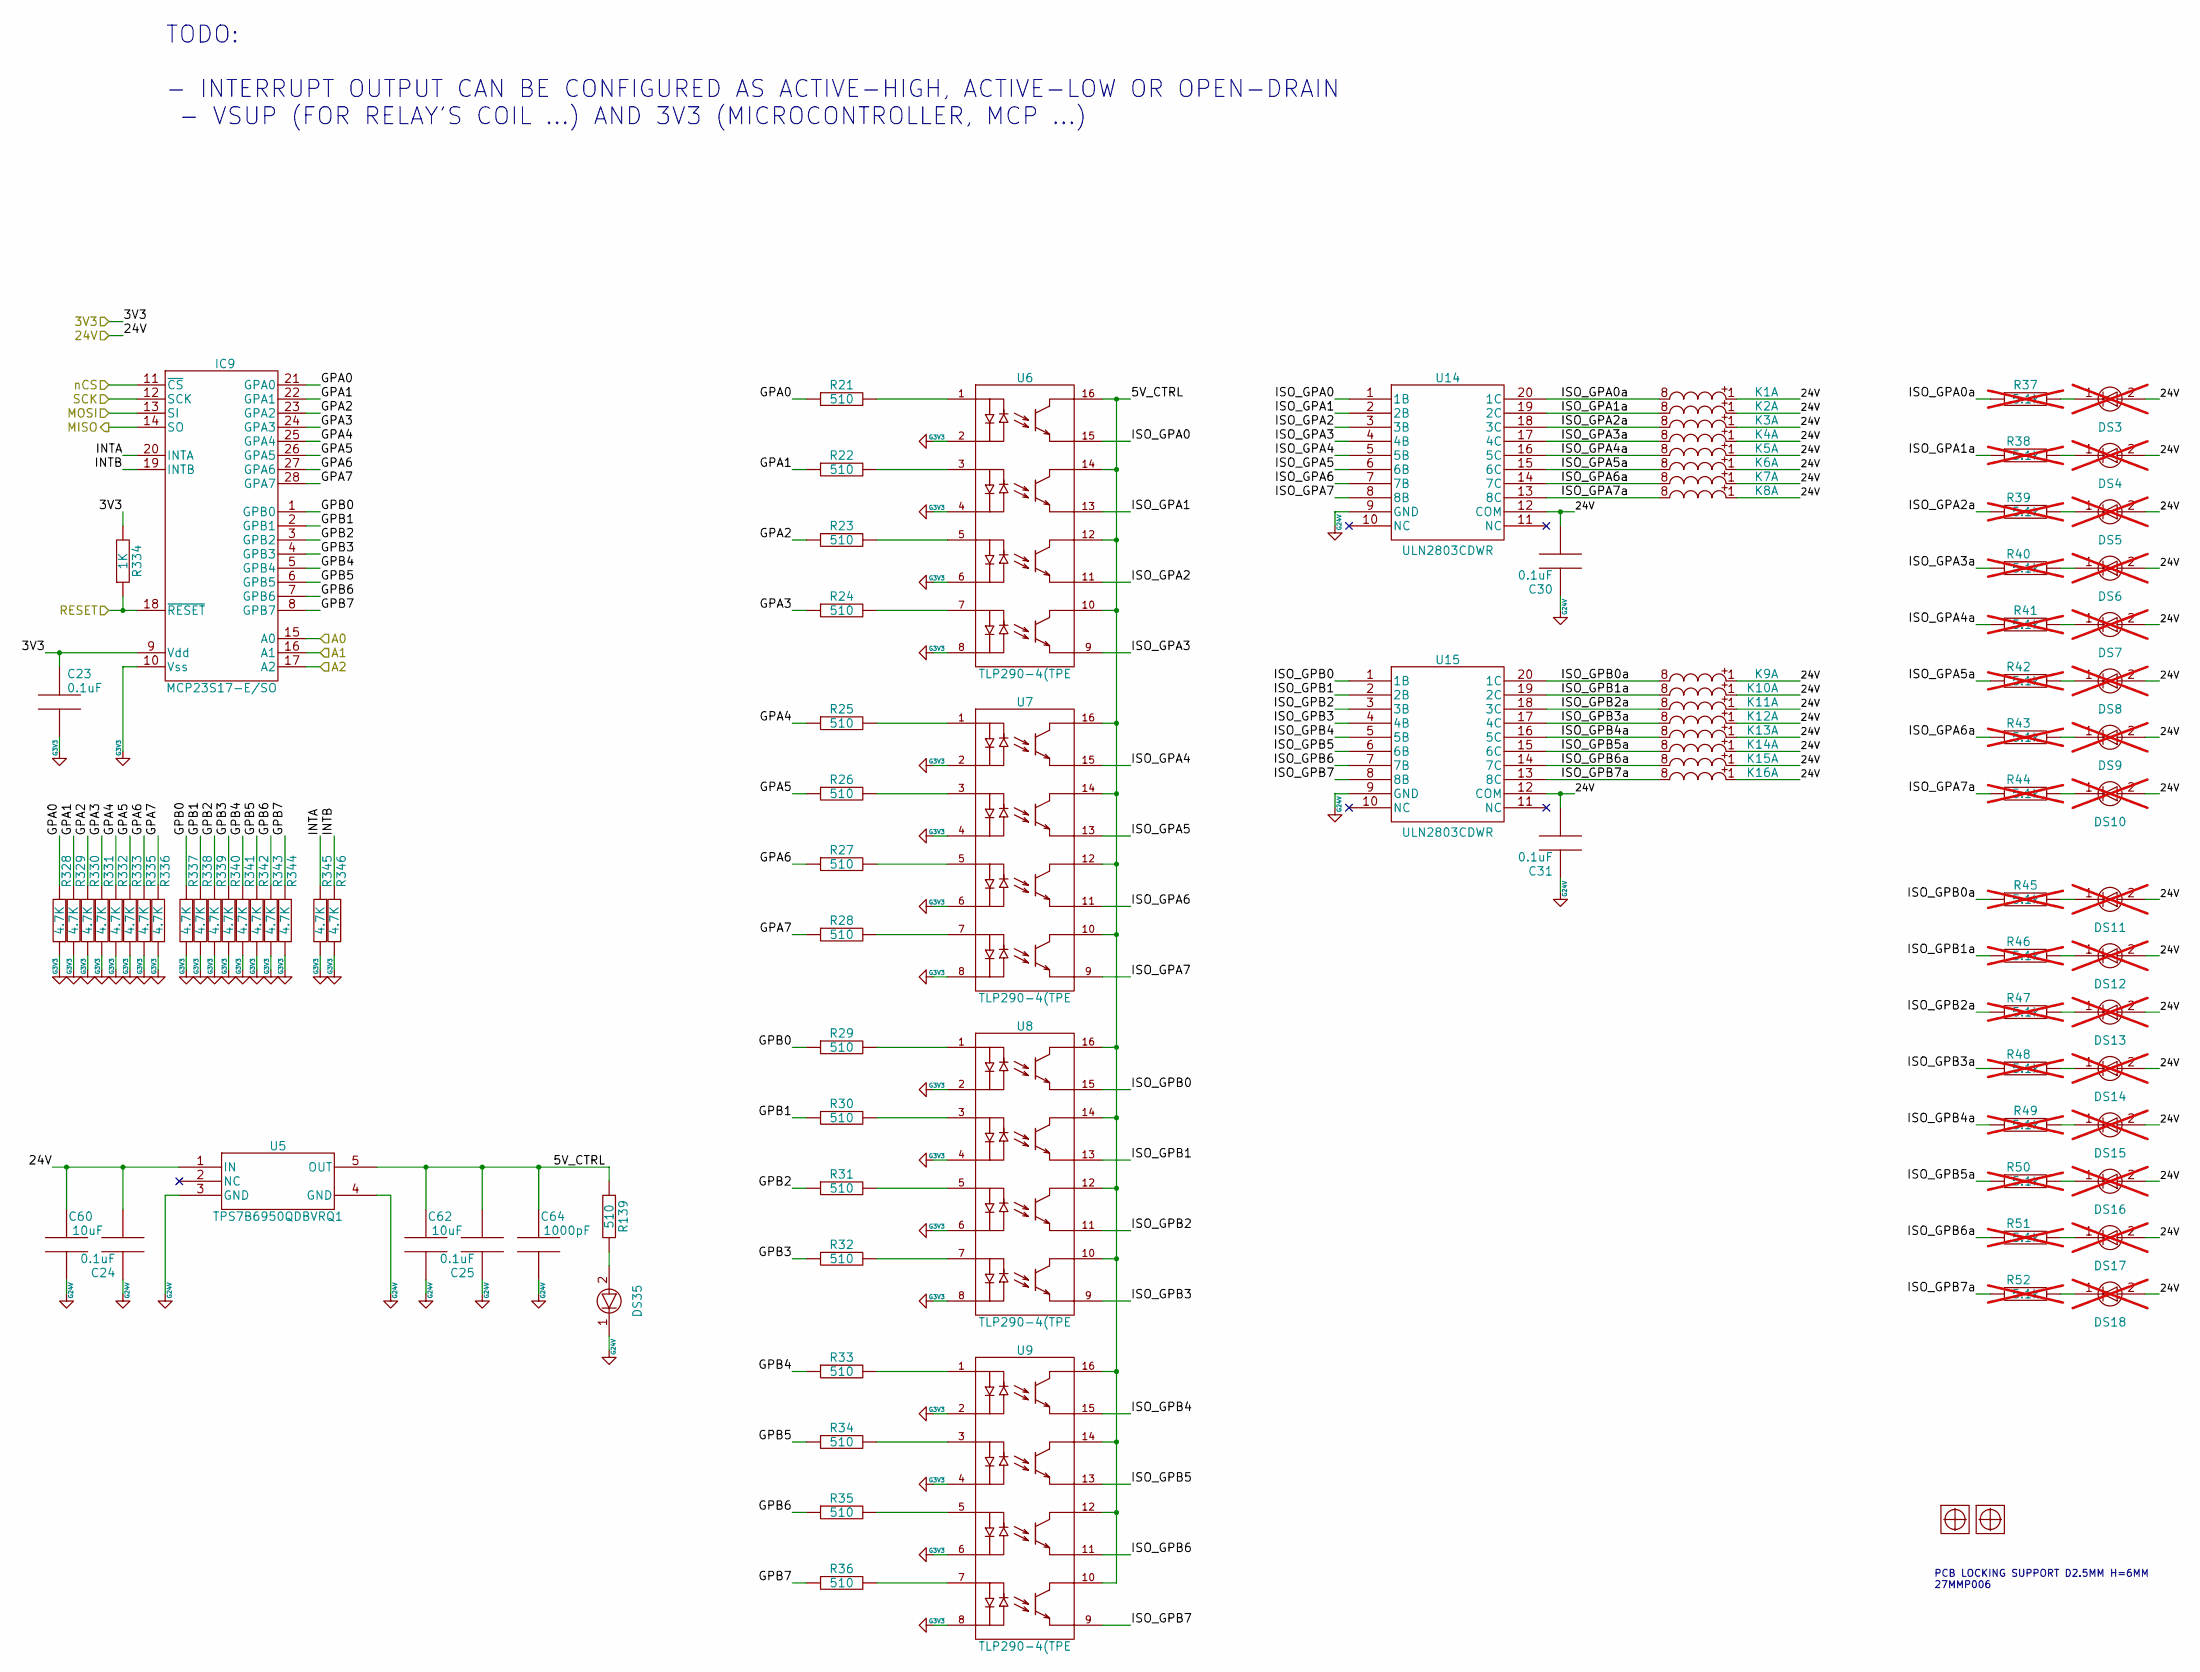
[picture p8: schematic output.kicad_sch]

Parts:
C23, C24, C25, C30, C31: 06035C104KAZ2A; CAPC1608X90N; Tolerance ±10%; Voltage 50V; ManufacturerPartNumber 06035C104KAZ2A
C60, C62: CL32B106KBJNNWE; CAPC3225X280N; Tolerance 20%; Voltage 50V; ManufacturerPartNumber CL32B106KBJNNNE
C64: GRM1885C1H102FA01D; CAPC1608X55N; Tolerance ±1%; Voltage 50V; ManufacturerPartNumber GRM1885C1H102FA01D
DS3, DS4, DS5, DS6, DS7, DS8, DS9, DS10, DS11, DS12, DS13, DS14, DS15, DS16, DS17, DS18: LTST-C171KGKT; LEDC2012X120N; Voltage 2V; ManufacturerPartNumber LTST-C171KGKT; not fitted
DS35: LTST-C171KGKT; LEDC2012X120N; Voltage 2V; ManufacturerPartNumber LTST-C171KGKT
IC9: MCP23S17_E_SO; SOIC28P127_1786X1034X264L83X43N; ManufacturerPartNumber MCP23S17-E/SO
K1, K2, K3, K4, K5, K6, K7, K8, K9, K10, K11, K12, K13, K14, K15, K16: G6K-2G-Y-TR_DC24_DPDT; OMRON_G6K-2G-Y; ManufacturerPartNumber G6K-2G-Y-TR DC24
MH1, MH2: MTGNPH250Z345K480; ManufacturerPartNumber NA
R21, R22, R23, R24, R25, R26, R27, R28, R29, R30, R31, R32, R33, R34, R35, R36, R139: RC0603FR-07510RL; RESC1608X65N; ManufacturerPartNumber RC0603FR-07510RL
R37, R38, R39, R40, R41, R42, R43, R44, R45, R46, R47, R48, R49, R50, R51, R52: RC0805FR-075K1L; RESC2012X65N; Tolerance 1%; ManufacturerPartNumber RC0805FR-075K1L; not fitted
R328, R329, R330, R331, R332, R333, R335, R336, R337, R338, R339, R340, R341, R342, R343, R344, R345, R346: RC0603FR-074K7L; RESC1608X65N; ManufacturerPartNumber RC0603FR-074K7L
R334: RC0603FR-071KL; RESC1608X65N; ManufacturerPartNumber RC0603FR-071KL
U5: TPS7B6950QDBVRQ1; SOT95P280X145-5N; ManufacturerPartNumber TPS7B6950QDBVRQ1
U6, U7, U8, U9: TLP290-4(TPE; SOIC127P700X220-16; ManufacturerPartNumber TLP290-4(TPE
U14, U15: ULN2803CDWR; SOIC127P1030X265-20; ManufacturerPartNumber ULN2803CDWR

Connections:
3V3: C23.1, IC9.9 (Vdd), R334.2
5V_CTRL: C25.2, C62.1, C64.2, R139.1, U5.5 (OUT), U6.10, U6.12, U6.14, U6.16, U7.10, U7.12, U7.14, U7.16, U8.10, U8.12, U8.14, U8.16, U9.10, U9.12, U9.14, U9.16
24V: C24.2, C30.2, C31.2, C60.1, DS3.2 (-), DS4.2 (-), DS5.2 (-), DS6.2 (-), DS7.2 (-), DS8.2 (-), DS9.2 (-), DS10.2 (-), DS11.2 (-), DS12.2 (-), DS13.2 (-), DS14.2 (-), DS15.2 (-), DS16.2 (-), DS17.2 (-), DS18.2 (-), K1.1, K2.1, K3.1, K4.1, K5.1, K6.1, K7.1, K8.1, K9.1, K10.1, K11.1, K12.1, K13.1, K14.1, K15.1, K16.1, U5.1 (IN), U14.12 (COM), U15.12 (COM)
A0: IC9.15 (A0)
A1: IC9.16 (A1)
A2: IC9.17 (A2)
GND_3V3: C23.2, IC9.10 (Vss), R328.2, R329.2, R330.2, R331.2, R332.2, R333.2, R335.2, R336.2, R337.2, R338.2, R339.2, R340.2, R341.2, R342.2, R343.2, R344.2, R345.2, R346.2, U6.2, U6.4, U6.6, U6.8, U7.2, U7.4, U7.6, U7.8, U8.2, U8.4, U8.6, U8.8, U9.2, U9.4, U9.6, U9.8
GND_24V: C24.1, C25.1, C30.1, C31.1, C60.2, C62.2, C64.1, DS35.1 (+), U5.3 (GND), U5.4 (GND), U14.9 (GND), U15.9 (GND)
GPA0: IC9.21 (GPA0), R21.1, R328.1
GPA1: IC9.22 (GPA1), R22.1, R329.1
GPA2: IC9.23 (GPA2), R23.1, R330.1
GPA3: IC9.24 (GPA3), R24.1, R331.1
GPA4: IC9.25 (GPA4), R25.1, R332.1
GPA5: IC9.26 (GPA5), R26.1, R333.1
GPA6: IC9.27 (GPA6), R27.1, R335.1
GPA7: IC9.28 (GPA7), R28.1, R336.1
GPB0: IC9.1 (GPB0), R29.1, R337.1
GPB1: IC9.2 (GPB1), R30.1, R338.1
GPB2: IC9.3 (GPB2), R31.1, R339.1
GPB3: IC9.4 (GPB3), R32.1, R340.1
GPB4: IC9.5 (GPB4), R33.1, R341.1
GPB5: IC9.6 (GPB5), R34.1, R342.1
GPB6: IC9.7 (GPB6), R35.1, R343.1
GPB7: IC9.8 (GPB7), R36.1, R344.1
INTA: IC9.20 (INTA), R345.1
INTB: IC9.19 (INTB), R346.1
ISO_GPA0: U6.15, U14.1 (1B)
ISO_GPA0a: K1.8, R37.1, U14.20 (1C)
ISO_GPA1: U6.13, U14.2 (2B)
ISO_GPA1a: K2.8, R38.1, U14.19 (2C)
ISO_GPA2: U6.11, U14.3 (3B)
ISO_GPA2a: K3.8, R39.1, U14.18 (3C)
ISO_GPA3: U6.9, U14.4 (4B)
ISO_GPA3a: K4.8, R40.1, U14.17 (4C)
ISO_GPA4: U7.15, U14.5 (5B)
ISO_GPA4a: K5.8, R41.1, U14.16 (5C)
ISO_GPA5: U7.13, U14.6 (6B)
ISO_GPA5a: K6.8, R42.1, U14.15 (6C)
ISO_GPA6: U7.11, U14.7 (7B)
ISO_GPA6a: K7.8, R43.1, U14.14 (7C)
ISO_GPA7: U7.9, U14.8 (8B)
ISO_GPA7a: K8.8, R44.1, U14.13 (8C)
ISO_GPB0: U8.15, U15.1 (1B)
ISO_GPB0a: K9.8, R45.1, U15.20 (1C)
ISO_GPB1: U8.13, U15.2 (2B)
ISO_GPB1a: K10.8, R46.1, U15.19 (2C)
ISO_GPB2: U8.11, U15.3 (3B)
ISO_GPB2a: K11.8, R47.1, U15.18 (3C)
ISO_GPB3: U8.9, U15.4 (4B)
ISO_GPB3a: K12.8, R48.1, U15.17 (4C)
ISO_GPB4: U9.15, U15.5 (5B)
ISO_GPB4a: K13.8, R49.1, U15.16 (5C)
ISO_GPB5: U9.13, U15.6 (6B)
ISO_GPB5a: K14.8, R50.1, U15.15 (6C)
ISO_GPB6: U9.11, U15.7 (7B)
ISO_GPB6a: K15.8, R51.1, U15.14 (7C)
ISO_GPB7: U9.9, U15.8 (8B)
ISO_GPB7a: K16.8, R52.1, U15.13 (8C)
MISO: IC9.14 (SO)
MOSI: IC9.13 (SI)
unnamed: DS3.1 (+), R37.2
unnamed: DS4.1 (+), R38.2
unnamed: DS5.1 (+), R39.2
unnamed: DS6.1 (+), R40.2
unnamed: DS7.1 (+), R41.2
unnamed: DS8.1 (+), R42.2
unnamed: DS9.1 (+), R43.2
unnamed: DS10.1 (+), R44.2
unnamed: DS11.1 (+), R45.2
unnamed: DS12.1 (+), R46.2
unnamed: DS13.1 (+), R47.2
unnamed: DS14.1 (+), R48.2
unnamed: DS15.1 (+), R49.2
unnamed: DS16.1 (+), R50.2
unnamed: DS17.1 (+), R51.2
unnamed: DS18.1 (+), R52.2
unnamed: DS35.2 (-), R139.2
unnamed: R21.2, U6.1
unnamed: R22.2, U6.3
unnamed: R23.2, U6.5
unnamed: R24.2, U6.7
unnamed: R25.2, U7.1
unnamed: R26.2, U7.3
unnamed: R27.2, U7.5
unnamed: R28.2, U7.7
unnamed: R29.2, U8.1
unnamed: R30.2, U8.3
unnamed: R31.2, U8.5
unnamed: R32.2, U8.7
unnamed: R33.2, U9.1
unnamed: R34.2, U9.3
unnamed: R35.2, U9.5
unnamed: R36.2, U9.7
RESET: IC9.18 (~RESET), R334.1
SCK: IC9.12 (SCK)
nCS: IC9.11 (~CS)

Notes on the sheet:
TODO: - INTERRUPT OUTPUT CAN BE CONFIGURED AS ACTIVE-HIGH, ACTIVE-LOW OR OPEN-DRAIN - VSUP (FOR RELAY'S COIL ...) AND 3V3 (MICROCONTROLLER, MCP ...)
PCB LOCKING SUPPORT D2.5MM H=6MM 27MMP006
