TokarskyiAnton/a0180_eol_ecu_mix/output_n.kicad_sch

## KiCad design output_n.kicad_sch (2026-02-06)

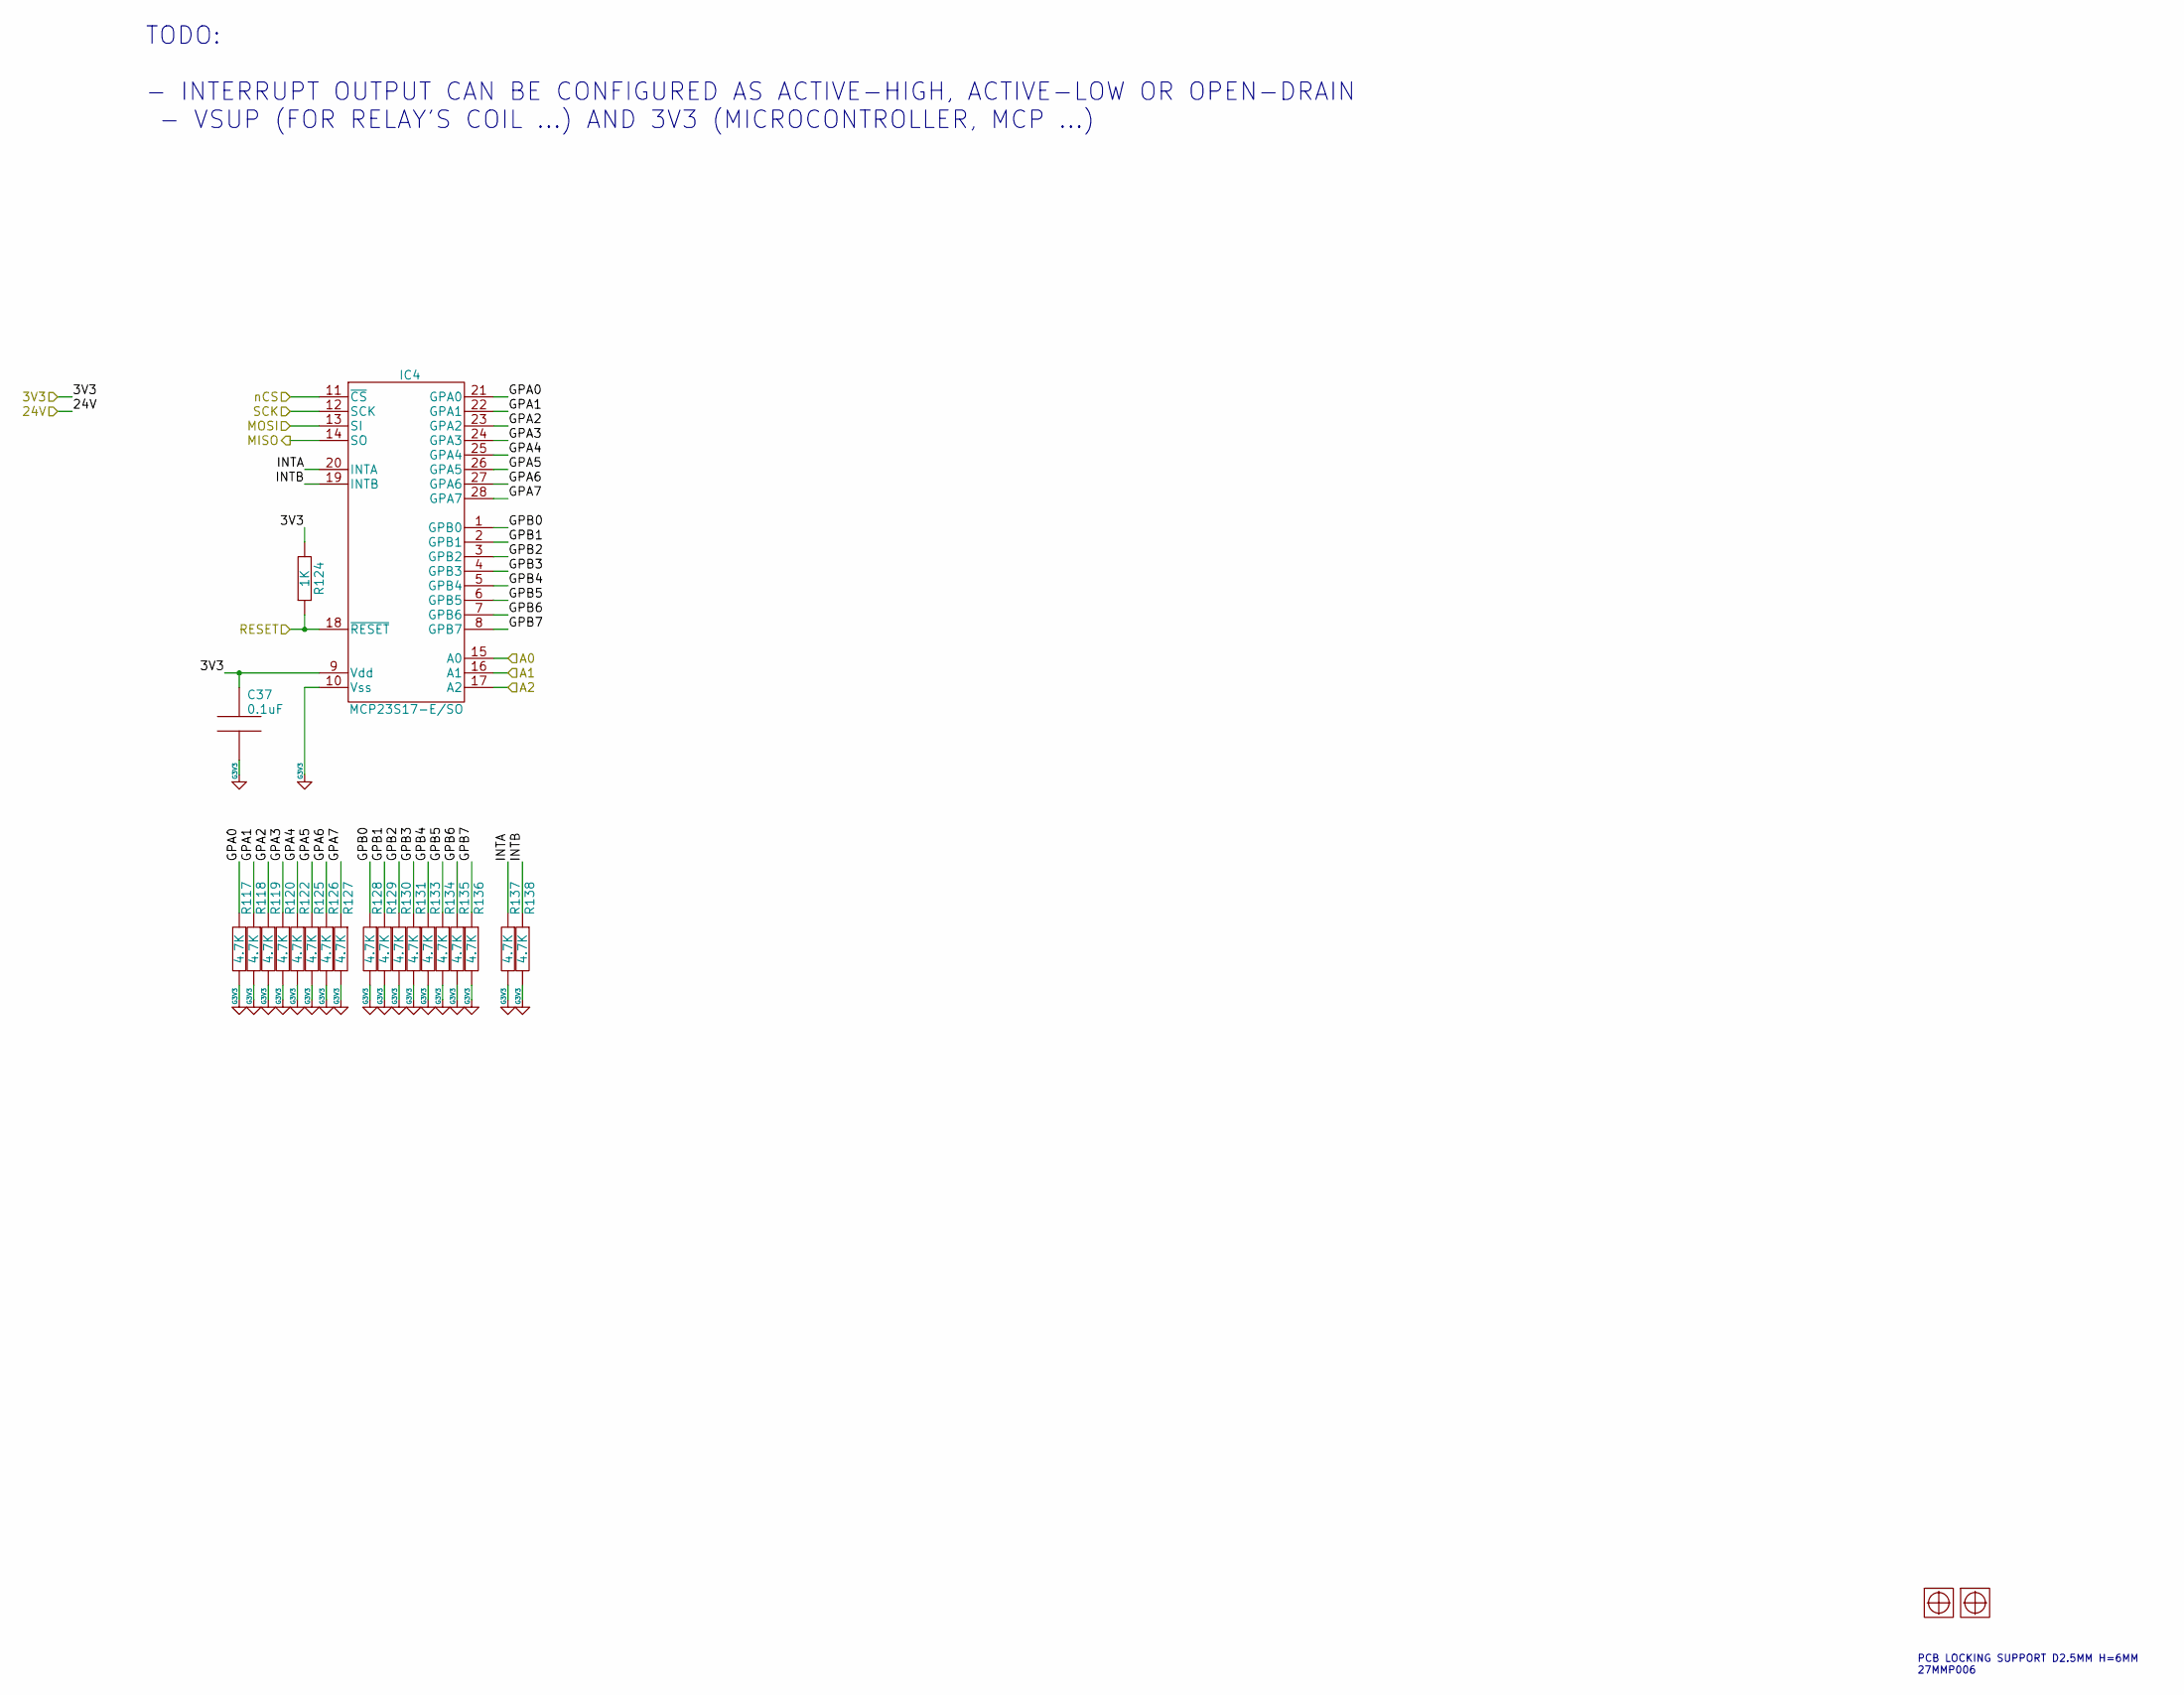
[picture p9: schematic output_n.kicad_sch]

Parts:
C37: 06035C104KAZ2A; CAPC1608X90N; Tolerance ±10%; Voltage 50V; ManufacturerPartNumber 06035C104KAZ2A
IC4: MCP23S17_E_SO; SOIC28P127_1786X1034X264L83X43N; ManufacturerPartNumber MCP23S17-E/SO
MH5, MH6: MTGNPH250Z345K480; ManufacturerPartNumber NA
R117, R118, R119, R120, R122, R125, R126, R127, R128, R129, R130, R131, R133, R134, R135, R136, R137, R138: RC0603FR-074K7L; RESC1608X65N; ManufacturerPartNumber RC0603FR-074K7L
R124: RC0603FR-071KL; RESC1608X65N; ManufacturerPartNumber RC0603FR-071KL

Connections:
3V3: C37.1, IC4.9 (Vdd), R124.2
A0: IC4.15 (A0)
A1: IC4.16 (A1)
A2: IC4.17 (A2)
GND_3V3: C37.2, IC4.10 (Vss), R117.2, R118.2, R119.2, R120.2, R122.2, R125.2, R126.2, R127.2, R128.2, R129.2, R130.2, R131.2, R133.2, R134.2, R135.2, R136.2, R137.2, R138.2
GPA0: IC4.21 (GPA0), R117.1
GPA1: IC4.22 (GPA1), R118.1
GPA2: IC4.23 (GPA2), R119.1
GPA3: IC4.24 (GPA3), R120.1
GPA4: IC4.25 (GPA4), R122.1
GPA5: IC4.26 (GPA5), R125.1
GPA6: IC4.27 (GPA6), R126.1
GPA7: IC4.28 (GPA7), R127.1
GPB0: IC4.1 (GPB0), R128.1
GPB1: IC4.2 (GPB1), R129.1
GPB2: IC4.3 (GPB2), R130.1
GPB3: IC4.4 (GPB3), R131.1
GPB4: IC4.5 (GPB4), R133.1
GPB5: IC4.6 (GPB5), R134.1
GPB6: IC4.7 (GPB6), R135.1
GPB7: IC4.8 (GPB7), R136.1
INTA: IC4.20 (INTA), R137.1
INTB: IC4.19 (INTB), R138.1
MISO: IC4.14 (SO)
MOSI: IC4.13 (SI)
RESET: IC4.18 (~RESET), R124.1
SCK: IC4.12 (SCK)
nCS: IC4.11 (~CS)

Notes on the sheet:
TODO: - INTERRUPT OUTPUT CAN BE CONFIGURED AS ACTIVE-HIGH, ACTIVE-LOW OR OPEN-DRAIN - VSUP (FOR RELAY'S COIL ...) AND 3V3 (MICROCONTROLLER, MCP ...)
PCB LOCKING SUPPORT D2.5MM H=6MM 27MMP006
