TokarskyiAnton/a0180_eol_ecu_mix/pic18f26k83.kicad_sch

## KiCad design pic18f26k83.kicad_sch (2026-02-06)

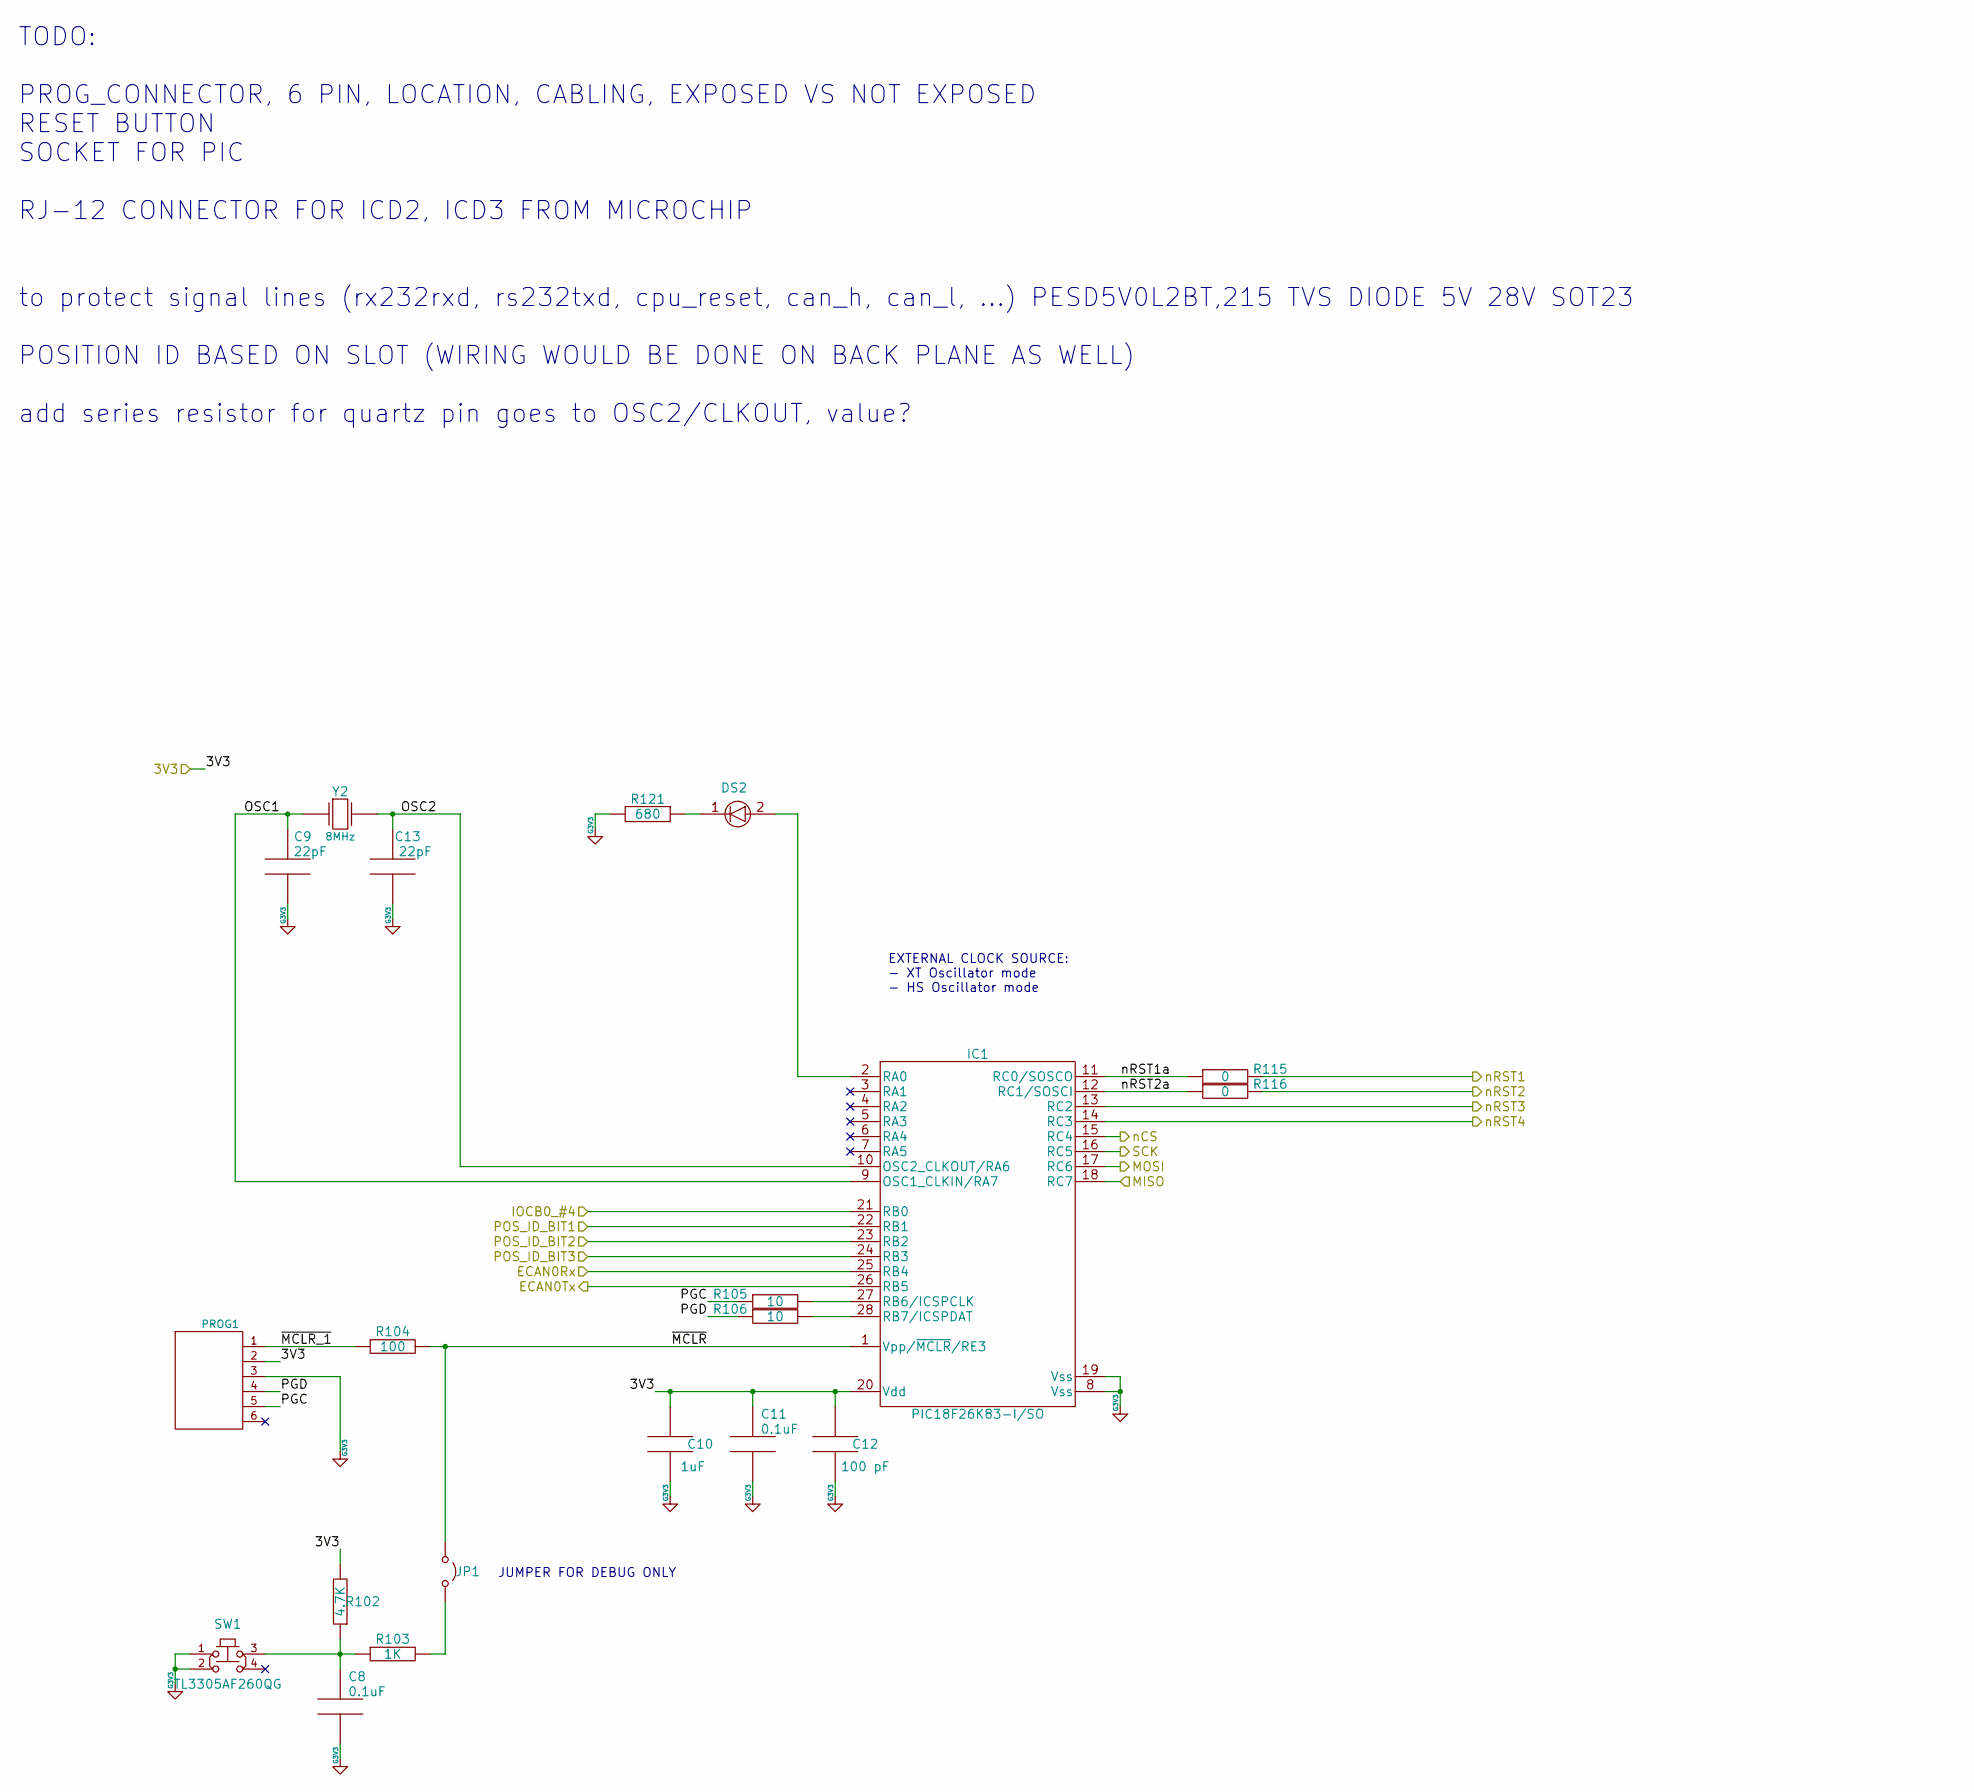
[picture p10: schematic pic18f26k83.kicad_sch]

Parts:
C8, C11: 06035C104KAZ2A; CAPC1608X90N; Tolerance ±10%; Voltage 50V; ManufacturerPartNumber 06035C104KAZ2A
C9, C13: 08055A220JAT2A; CAPC1608X90N; ManufacturerPartNumber 08055A220JAT2A
C10: 08055C105KAT2A; CAPC2012X94; Tolerance 10%; Voltage 50V; ManufacturerPartNumber 08055C105KAT2A
C12: C0805C101K5RACTU; CAPC2012X120N; Tolerance 10%; Voltage 50V; ManufacturerPartNumber C0805C101K5RACTU
DS2: 597-3308-202F; LEDM3527X190; ManufacturerPartNumber 597-3308-202F
IC1: PIC18F26K83-I_SO; SOIC28P127_1786X1034X264L83X43N; ManufacturerPartNumber PIC18F26K83-I/SO
JP1: 61300211121; WURTH_61300211121; ManufacturerPartNumber 61300211121
PROG1: SSW-106-02-G-S; SAMTEC_SSW-106-02-G-S; ManufacturerPartNumber SSW-106-02-G-S
R102: RC0603FR-074K7L; RESC1608X65N; ManufacturerPartNumber RC0603FR-074K7L
R103: RC0603FR-071KL; RESC1608X65N; ManufacturerPartNumber RC0603FR-071KL
R104: RC0805FR-07100RL; RESC2012X65N; Tolerance 1%; ManufacturerPartNumber RC0805FR-07100RL
R105, R106: RC0805FR-0710RL; RESC2012X65N; Tolerance 1%; ManufacturerPartNumber RC0805FR-0710RL
R115, R116: RC0603JR-070RL; RESC1608X65N; ManufacturerPartNumber RC0603JR-070RL
R121: RMCF0805JT680R; RESC2012X55N; ManufacturerPartNumber RMCF0805JT680R
SW1: TL3305AF260QG; ESWITCH_TL3305AF260QG; ManufacturerPartNumber TL3305AF260QG
Y2: ECS-80-20-5PX-TR; XTAL1140X470X430; Tolerance ±50ppm; ManufacturerPartNumber ECS-80-20-5PX-TR

Connections:
3V3: C10.1, C11.1, C12.1, IC1.20 (Vdd), PROG1.2, R102.2
ECAN0Rx: IC1.25 (RB4)
ECAN0Tx: IC1.26 (RB5)
GND_3V3: C8.2, C9.2, C10.2, C11.2, C12.2, C13.2, IC1.8 (Vss), IC1.19 (Vss), PROG1.3, R121.2, SW1.1, SW1.2
IOCB0_#4: IC1.21 (RB0)
MISO: IC1.18 (RC7)
MOSI: IC1.17 (RC6)
unnamed: C8.1, R102.1, R103.1, SW1.3
unnamed: DS2.1 (+), R121.1
unnamed: DS2.2 (-), IC1.2 (RA0)
unnamed: IC1.27 (RB6/ICSPCLK), R105.2
unnamed: IC1.28 (RB7/ICSPDAT), R106.2
unnamed: JP1.2 (B), R103.2
OSC1: C9.1, IC1.9 (OSC1_CLKIN/RA7), Y2.1
OSC2: C13.1, IC1.10 (OSC2_CLKOUT/RA6), Y2.2
PGC: PROG1.5, R105.1
PGD: PROG1.4, R106.1
POS_ID_BIT1: IC1.22 (RB1)
POS_ID_BIT2: IC1.23 (RB2)
POS_ID_BIT3: IC1.24 (RB3)
SCK: IC1.16 (RC5)
nCS: IC1.15 (RC4)
nRST1: R115.2
nRST1a: IC1.11 (RC0/SOSCO), R115.1
nRST2: R116.2
nRST2a: IC1.12 (RC1/SOSCI), R116.1
nRST3: IC1.13 (RC2)
nRST4: IC1.14 (RC3)
~MCLR_1: PROG1.1, R104.1
~MCLR: IC1.1 (Vpp/~MCLR/RE3), JP1.1 (A), R104.2

Notes on the sheet:
EXTERNAL CLOCK SOURCE: - XT Oscillator mode - HS Oscillator mode
JUMPER FOR DEBUG ONLY
TODO: PROG_CONNECTOR, 6 PIN, LOCATION, CABLING, EXPOSED VS NOT EXPOSED RESET BUTTON SOCKET FOR PIC RJ-12 CONNECTOR FOR ICD2, ICD3 FROM MICROCHIP to protect signal lines (rx232rxd, rs232txd, cpu_reset, can_h, can_l, ...) PESD5V0L2BT,215 TVS DIODE 5V 28V SOT23 POSITION ID BASED ON SLOT (WIRING WOULD 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
