TokarskyiAnton/a0180_eol_ecu_mix/power.kicad_sch

## KiCad design power.kicad_sch (2026-02-20)

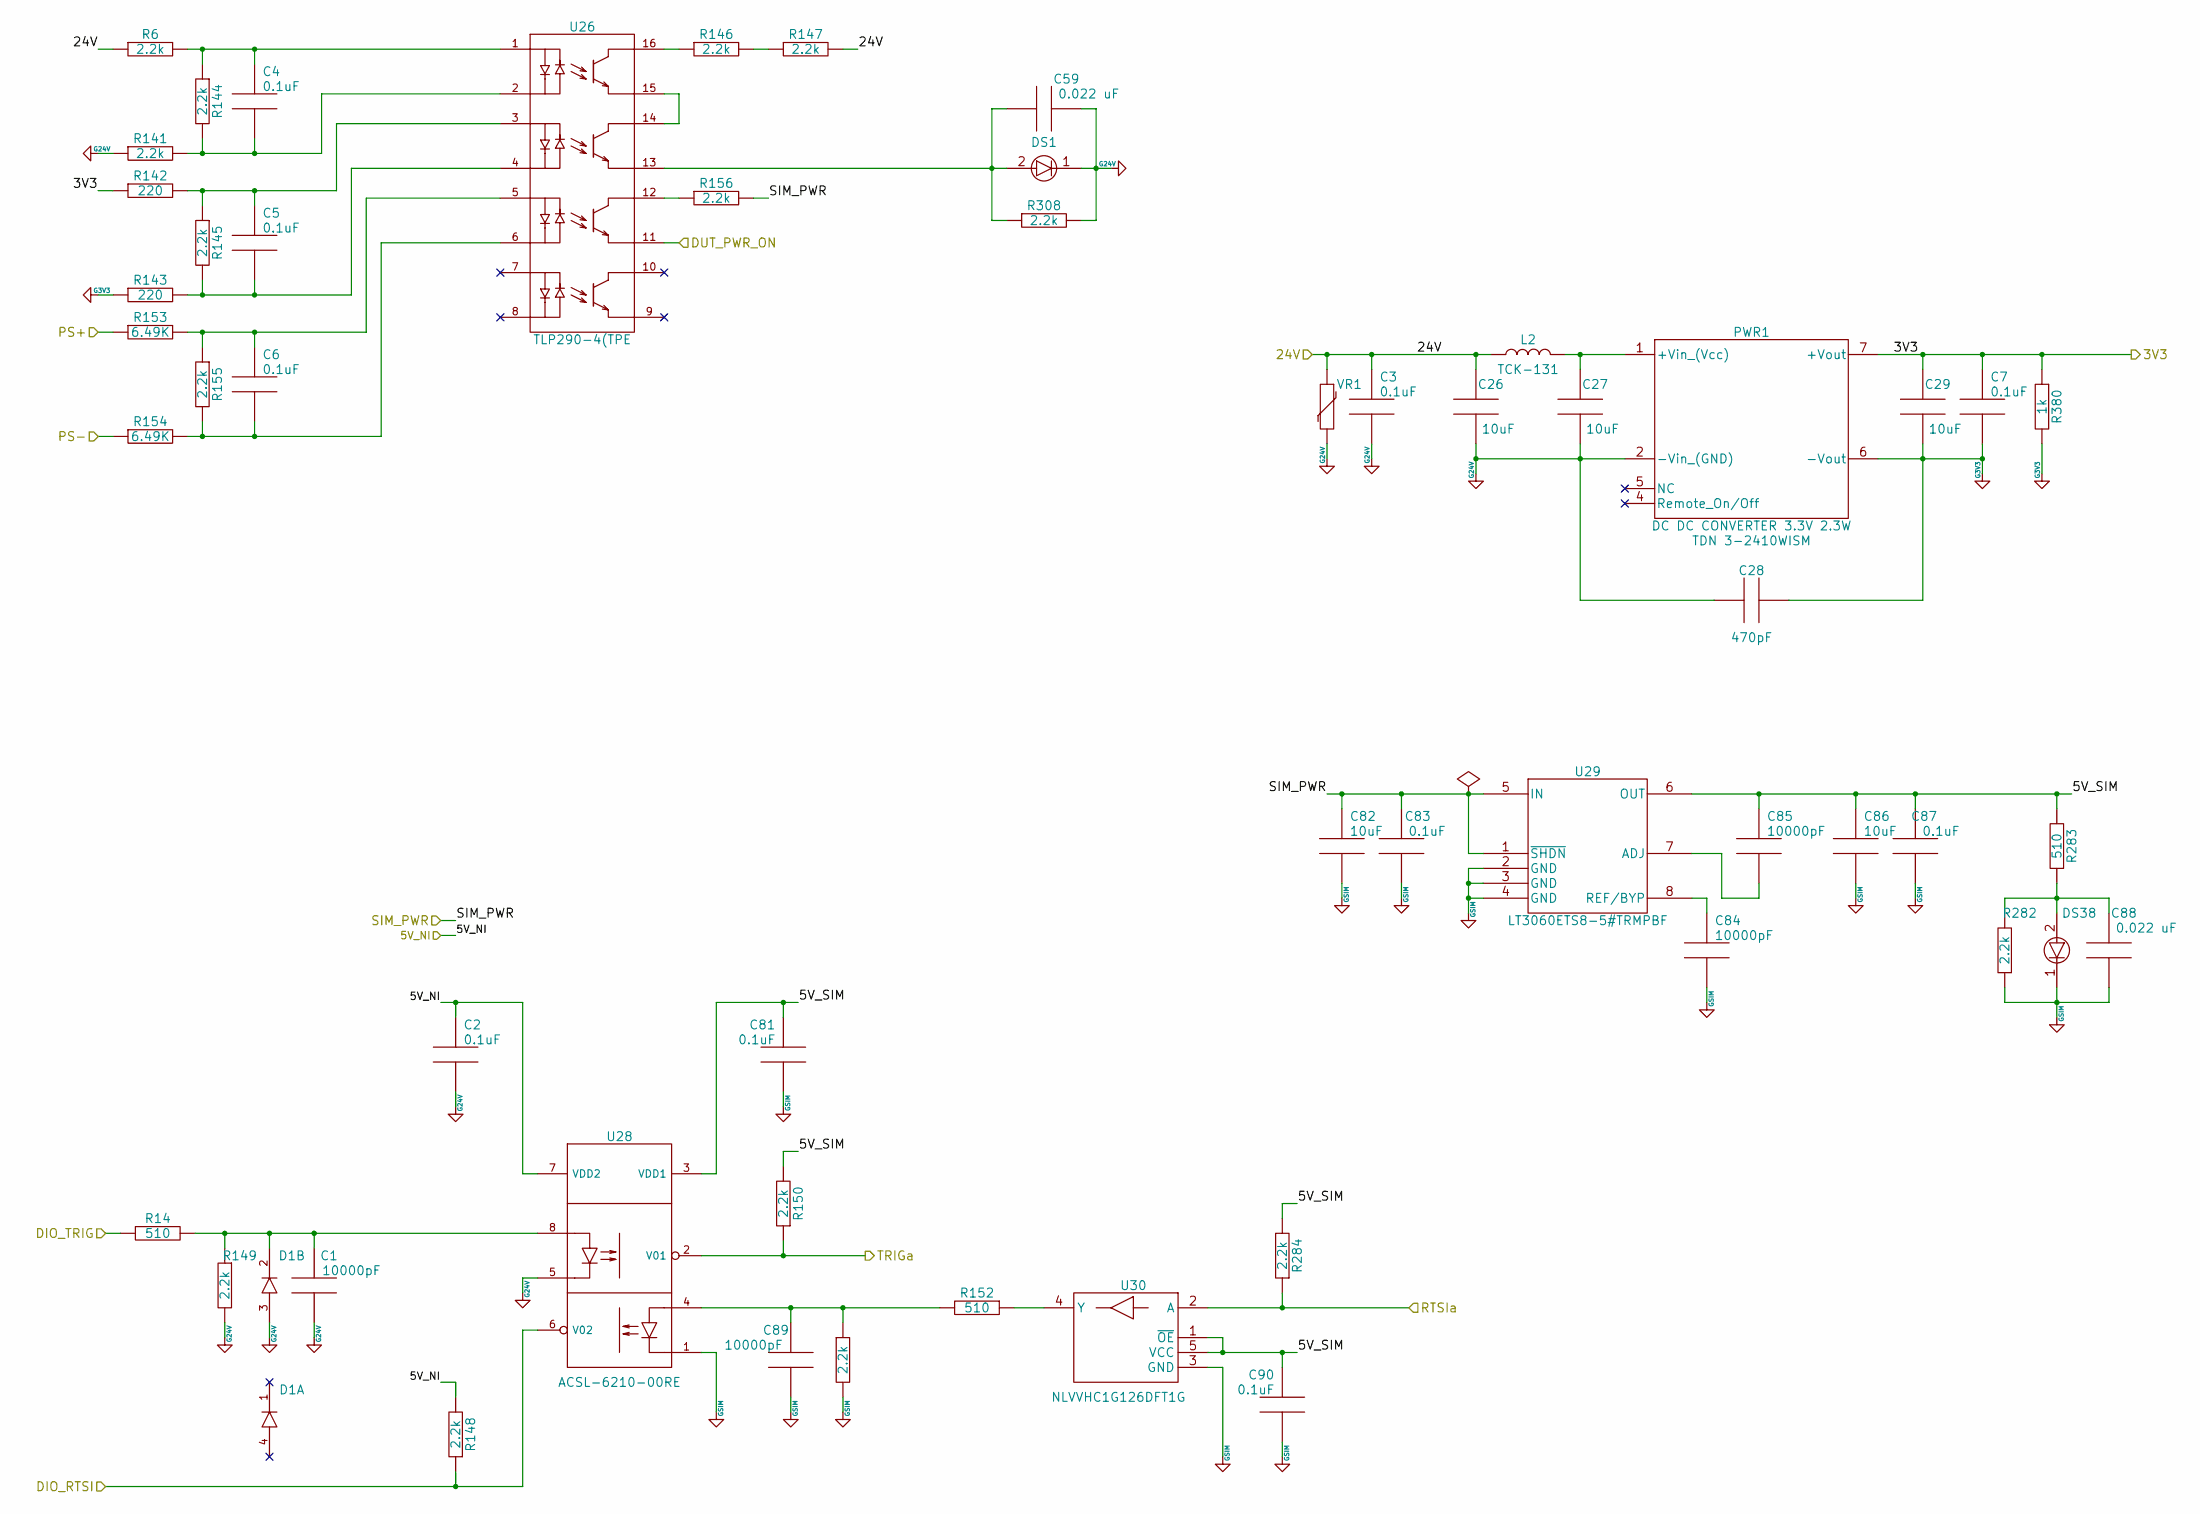
[picture p11: schematic power.kicad_sch]

Parts:
C1, C89: C0603C103F3GACTU; CAPC1608X92; Tolerance ±1%; Voltage 25V; ManufacturerPartNumber C0603C103F3GACTU
C2, C3, C4, C5, C6, C7, C81, C83, C87, C90: 06035C104KAZ2A; CAPC1608X90N; Tolerance ±10%; Voltage 50V; ManufacturerPartNumber 06035C104KAZ2A
C26, C27, C29, C82, C86: CL32B106KBJNNWE; CAPC3225X280N; Tolerance 20%; Voltage 50V; ManufacturerPartNumber CL32B106KBJNNNE
C28: 1808HC471KAT2A; CAPC4520X102N; Tolerance 10%; Voltage 3KV; ManufacturerPartNumber 1808HC471KAT2A
C59, C88: CGA4J2NP01H223J125AA; CAPC2012X145N; ManufacturerPartNumber CGA4J2NP01H223J125AA
C84, C85: GRM2195C1H103FA01D; CAPC2012X135N; Tolerance 1%; Voltage 50V; ManufacturerPartNumber GRM2195C1H103FA01D
D1: BAS28; SOT143-4P190_230X110L30X43; ManufacturerPartNumber BAS28
DS1: 597-3308-202F; LEDM3527X190; ManufacturerPartNumber 597-3308-202F
DS38: LTST-C171KGKT; LEDC2012X120N; Voltage 2V; ManufacturerPartNumber LTST-C171KGKT
L2: TCK-131; TRACO_TCK-131; ManufacturerPartNumber TCK-131
PWR1: TDN_3-2410WISM; TRACO_TDN_3WISM; ManufacturerPartNumber TDN 3-2410WISM
R6, R141, R144, R145, R146, R147, R148, R149, R150, R151, R155, R156, R282, R284, R308: RC0603JR-072K2L; RESC1608X65N; Tolerance 5%; ManufacturerPartNumber RC0603JR-072K2L
R14, R152, R283: RC0603FR-07510RL; RESC1608X65N; ManufacturerPartNumber RC0603FR-07510RL
R142, R143: RC0603FR-07220RL; RESC1608X65N; ManufacturerPartNumber RC0603FR-07220RL
R153, R154: RC0603FR-076K49L; RESC1608X65N; ManufacturerPartNumber RC0603FR-076K49L
R380: RC1206FR-071KL; RESC3116X65N; ManufacturerPartNumber RC1206FR-071KL
U26: TLP290-4(TPE; SOIC127P700X220-16; ManufacturerPartNumber TLP290-4(TPE
U28: ACSL-6210-00RE; SOIC8P127_508X599X330L65X40; ManufacturerPartNumber ACSL-6210-00RE
U29: LT3060ETS8-5#TRMPBF; SOT65P280X100-8; ManufacturerPartNumber LT3060ETS8-5#TRMPBF
U30: NLVVHC1G126DFT1G; SOT65P210X110-5; ManufacturerPartNumber NLVVHC1G126DFT1G
VR1: B72520E0250K062; VARC3216X170N; Voltage 31V; ManufacturerPartNumber B72520E0250K062

Connections:
3V3: C7.1, C29.1, PWR1.7 (+Vout), R142.1, R380.1
5V_NI: C2.1, R148.2, U28.7 (VDD2)
5V_SIM: C81.1, C85.2, C86.1, C87.2, C90.1, R150.2, R283.2, R284.2, U28.3 (VDD1), U29.6 (OUT), U30.1 (~OE), U30.5 (VCC)
24V: C3.1, C26.1, L2.1, R6.1, R147.2, VR1.1
DIO_RTSI: R148.1, U28.6 (V02)
DIO_TRIG: R14.1
DUT_PWR_ON: U26.11
GND_3V3: C7.2, C28.2, C29.2, PWR1.6 (-Vout), R143.1, R380.2
GND_24V: C1.1, C2.2, C3.2, C26.2, C27.2, C28.1, C59.2, D1.3 (A), DS1.1 (+), PWR1.2 (-Vin_(GND)), R141.1, R149.2, R308.2, U28.5, VR1.2
GND_SIM: C81.2, C82.2, C83.1, C84.1, C86.2, C87.1, C88.1, C89.1, C90.2, DS38.1 (+), R151.2, R282.1, U28.1, U29.2 (GND), U29.3 (GND), U29.4 (GND), U30.3 (GND)
unnamed: C1.2, D1.2 (C), R14.2, R149.1, U28.8
unnamed: C4.1, R6.2, R144.1, U26.1
unnamed: C4.2, R141.2, R144.2, U26.2
unnamed: C5.1, R142.2, R145.1, U26.3
unnamed: C5.2, R143.2, R145.2, U26.4
unnamed: C6.1, R153.2, R155.1, U26.5
unnamed: C6.2, R154.2, R155.2, U26.6
unnamed: C27.1, L2.2, PWR1.1 (+Vin_(Vcc))
unnamed: C59.1, DS1.2 (-), R308.1, U26.13
unnamed: C84.2, U29.8 (REF/BYP)
unnamed: C85.1, U29.7 (ADJ)
unnamed: C88.2, DS38.2 (-), R282.2, R283.1
unnamed: C89.2, R151.1, R152.2, U28.4
unnamed: R146.1, U26.16
unnamed: R146.2, R147.1
unnamed: R152.1, U30.4 (Y)
unnamed: R156.1, U26.12
unnamed: U26.14, U26.15
PS+: R153.1
PS-: R154.1
RTSIa: R284.1, U30.2 (A)
SIM_PWR: C82.1, C83.2, R156.2, U29.1 (~SHDN), U29.5 (IN)
TRIGa: R150.1, U28.2 (V01)
